Julius-eng/project-quiver-05032025/flight-test/README.md

# Flight Test Archive

This folder is no longer in active use. It serves as a historical record of early flight tests conducted during the initial development and validation phases of the project.

Current and future flight tests will be logged and tracked on our [flight tracking platform](https://project-flight-tracking.vercel.app/).

## Contents

- **PT1/** - Prototype 1 flight test logs and documentation
- **PT2/** - Prototype 2 flight test logs and documentation
- **PT3/** - Prototype 3 flight test documentation
- **PT3-TX/** - Prototype 3 flight test documentation in Texas
- **20hr-flight-plan.md** - Original 20-hour flight plan
- **performance-metrics-flight-plan.md** - Performance metrics flight plan
