Julius-eng/project-quiver-05032025/task-grant-bounty/pt3/electronics/0002-Battery-PCB/information-note.md

# PT 3 Battery PCB

# Status

`Valid`

`Revision History: V1`

`Replacement Log: None`

`Reference: PT3 PCB Spec information note`

# Project Description
## PCB Overview

The Battery PCB is one of four custom PCBs being designed for PT3. This PCB is responsible for safely controlling, protecting, and monitoring the primary power output from the Tattu Smart Battery to the Main PCB. These functions are implemented using onboard voltage regulators, MOSFETs, SSRs, resistors, TVS diodes, fuses, LEDs, temperature sensors, and flight controller (FC) control signals. The PCB transmits battery telemetry via CAN, temperature data via I²C, and notifies users of power status through integrated LEDs. Further details are available in the schematic and component datasheets. 

# Methodology
Reviewed and studied the PT3 Battery PCB design files from Julius. Discussed and developed understanding over various direct messages and calls. 
Designed was based on the information provided in the [PT3 PCB Spec information note](https://github.com/Arrow-air/project-quiver/blob/main/task-grant-bounty/pt3/electronics/0001-PCB-Spec/information-note.md).

# Results and Deliverables

## Schematics and CAD files


<sub>***PCB Schematic***</sub>


<sub>***PCB All layers***</sub>


<sub>***PCB Traces***</sub>


<sub>***PCB Ground Plane***</sub>


<sub>***PCB Front***</sub>


<sub>***PCB Back***</sub>


<sub>***PCB CAD front***</sub>


<sub>***PCB CAD back***</sub>

### PCB Build Specifications

- Base material: FR-4
- Dimensions: 172.2 x 101.8 mm
- Layers: 4
- PCB thickness: 1.6 mm
- PCB Color: Blue
- Silkscreen: White
- Material Type: FR-4 TG155
- Via Covering: Plugged
- Min via hole size/diameter: 0.3mm/(0.4/0.45mm)
- Surface finish: ENIG
- Gold Thickness: 2U”
- Outer/Inner Copper Weight: 2 oz each
- Board Outline Tolerance: ±0.2mm(Regular)

## Layout Description

**J1 – Push-button Connector**

- Pre-charge activation push button with integrated LED
    - LED indication powered by internal power supply (PS1)

**J2 – 5-pin Eurostyle Connector**

- FC_2: Pre-charge termination signal from flight controller (FC)
- I²C SDA & SCL: Temperature sensor data communication
- CAN H & L: Battery telemetry signals

**J3 – 4 pin Eurostyle Connector**

- SSR_S: Enable signal for Solid State Relay (SSR) U3
- 12V and 5V inputs from the Main PCB
- Ground

**J5 – CAN Jumper**

- Optional jumper for enabling battery telemetry via CAN

**J6 – Pre-charge Behavior Control Jumper**

- Optional jumper enabling specific control of the pre-charge circuit

**J7 & J8 – Fuse Connectors**

- Press-fit pins designed for a 200A fuse
- Pre-charge bypass: A 16 AWG cable with a ring terminal connects directly to J49 on the Main PCB, activated via push button (J1)

**J9 & J10 - Main Battery Connector**

- Custom Molex connectors:
    - Contact pins: 2x of Molex EXTreme 46437-9206
    - Guide pin: 1x  Molex 464379-301
            
       <sub>***Custom Molex Connector***</sub>

- J9
    - P1-P5: Main negative outputs (fused at J7 & J8)
        - Ground reference for the circuit with exception of 12V and 5V coming from the Main PCB via J3
    - P6: CAN_L
- J10
    - P2 - P6: Main positive output
    - P1: CAN_H

**J11 – Main Output Connector**

- AMASS power connector using 6 or 8 AWG cable

**IC1 & IC2 - Temperature sensors** 

- Powered by regulated 3.3V (PS2)
- Positioned on PCB's top layer, measuring temperature of pre-charge resistors and SSR MOSFETs located on the bottom layer
- Address determined by soldering 1 of the jumper pads circled in red
    - IC1: +3V3 (JP3)
    - IC2: GND (JP6)
        
        

**Q2 - Q7 Main MOSFETs**

- Source connected to fused negative terminal (BAT-)
- Gate voltage provided by SSR (U3) via regulator (U2), controlled by FC
- Protection circuitry:
    - 10Ω gate resistor
    - 220kΩ gate-to-ground resistor
    - TVS diode gate-to-ground
- Similar operation and protections apply to pre-charge MOSFET (Q1)
- Test points
    - TP1 - voltage divider for PS1 remote operation
        - Powered off reading: ~10-15V
        - Powered on reading: Battery voltage
    - TP2 - 5V input to PS2 (Temperature sensor voltage regulator)
    - TP3 - 3.3V PS2 output
    - TP4 - Gate voltage for Q1 MOSFET (pre-charge )
        - 12V after push button pressed
    - TP5 - Gate voltage for MOSFETs Q2-Q7
        - 12V after SSR_S triggered
    - TP6 - Battery voltage out of SSR U3
        - Battery voltage after SSR_S triggered

**The remainder of the circuit will be explained in the Circuit Operation section**

## Circuit Operation

- Battery is plugged in
    - PS1 is energized but is not outputting 12V without pushbutton (J1) activation
    - Main output (J11)
        - + terminal is live
        - - terminal is open circuit with MOSFETS Q1 - Q7
    - Depending on J5 jumper placement, Battery telemetry will be on CAN bus
- User presses push button (J1)
    - LED on pushbutton will light up
    - 12V output from PS1 to Q1 MOSFET gate
    - Pre-charge will begin allowing current to pass through 200A fuse (J7 & J8), automotive fuse (U1), MOSFET (Q1), NC SSR (K1), pre-charge resistors (R15 - R17), and then the main negative output
    - This will allow limited power output from the Battery PCB to the Main PCB
        - pre-charge ESC capacitors
        - Power on Main PCB 12V and 5V regulators
        - Power to FC and aux components
    - This will also bring in 5V and 12V from the Main PCB
        - 5V will power the 3.3V regulator (PS2)
            - temperature sensors will be powered on(3.3V) and transmit data over I<sup>2</sup>C back to Main PCB
    - After pre-charge is complete the following LEDs will be visible on the Battery PCB exterior
        - LED5 - 3.3V (from internal voltage regulator)
        - LED6 - 5V (coming from Main PCB, J3)
        - LED6 - 12V (coming from Main PCB, J3)
    - Pre-charge bypass wire will be live but is an open circuit on the Main PCB until SSR U3 (Main PCB) is closed. 
- User completes pre-arm checklist
- Users sends signal to fully activate main power out from FC (SSR_S, J3) and end pre-charge signal (FC_2, J2) (Depending on JP9 and JP10 selection)
    - Two things can happen here depending on J6 jumper placement
        - With jumper
            - SSR_S or FC_2 will open the NC SSR (K1) effectively terminating the pre-charge
            - Simultaneously, SSR_S will trigger the NO SSR (U3) allowing another 12V regulator (U2) to be powered on
                - this will apply 12V to the gate of the MOSFETs (Q2 - Q7)
                - current will pass through the MOSFETs to main negative output (J3)
            - circuit will have full power output capabilities
        - without jumper
            - pre-charge will remain on
            - FC_2 will be an open circuit
            - SSR_S will trigger the NO SSR (U3) allowing another 12V regulator (U2) to be powered on
                - this will apply 12V to the gate of the MOSFETs (Q2 - Q7)
                - current will pass through the MOSFETs to main negative output (J3)
            - circuit will have full power output capabilities
    - LED5 - SSR Signal will be visible on the Battery PCB exterior
 
# Remarks
- Design work was conducted by Julius.
- Schematic and CAD files can be find in the Quiver PT3 task and bounties directory
- information note prepared by Erick.
- Manufacturing instructions can be found in the assembly guide.
