Julius-eng/project-quiver-05032025/task-grant-bounty/pt1/electronics/0002-PT1.5_Harnessing_Update/information-note.md

# PT 1.5 Harnessing Update

# Status

`Valid`

`Revision History: None`

`Replacement Log: None`

`Reference: None`

# Project Description

This information note covers the harnessing updates for PT1 due to the implementation of a new PCB. These updates were required because various components, connectors, and enclosures were changed. 

# Methodology

The main considerations for the design are:

- Updated layout and components used in the new PCB
- Components removed
- Redesigned enclosure
- Compatibility with the existing systems

# Results and Deliverables

### Overview of Changes

The following components were removed from the PT1 design:

- Feather PT3 Testbed PDB
- Contactor
- XT-60 Splitter
- Custom designed enclosure
- Pixhawk PM02D Voltage regulator
- KDE UBEC

The following components were added to the design:

- “PT2 PCB”
    - See [information note](https://github.com/Arrow-air/project-quiver/blob/main/task-grant-bounty/pt1/electronics/0001-PDB_V1/information-note.md) for detailed review.
    - Handles all voltage regulation and power distribution
    - Introduces various plug size Molex Eurostyle Terminal blocks
    - Added physical switch for pre-charge control
    - XT60PW-M for ESC Output
- Solid State Relay (SSR)
- Updated PCB enclosure merged with the attachment interface

The following connectors are being reused:

- compression lugs
- XT30PW-F

An updated To/From table was prepared for all connections in a [CSV format](https://docs.google.com/spreadsheets/d/16EMP2wPfAB1RD0uh3B_RAArtTbWv5ikxNuRASy50kpA/edit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). Refer to this table to get specifics on pins and what connectors are used. This will eventually be used to create a detailed routing CAD diagram. 

### Cables Created

J1 → SIYI

- SIYI cable plugs into J1

J2 → SSR LED

J3 → SSR Control Pins

- 4 position Eurostyle plug to header pins
- 28 AWG

J4 & J5 → Various FC ports

- 6 and 10 position Eurostyle plug to JST connectors on Pixhawk
- 28 AWG
- 75 cm
- Note: J5 pins 8 and 9 will go to flight controller AD&IO port

J6 → Payload (Attachment interface)

- 7 position Eurostyle plug to 8 position Molex

J7 → Battery Interface

- 2 position Eurostyle plug with bare leads
    - solder into slots on battery interface

J8 → Radar Altimeter

- 4 Position Eurostyle plug directly from radar altimeter

J9 → Battery (-)

- 2 position Eurostyle plug
- Pin 1 connects to negative terminal of battery interface with ring terminal

SSR + → J10

- 6 AWG Silicon cable with compression lug

J11 → Precharge Switch 

- 2 position Eurostyle connecting to toggle switch

SSR - → J12

- 6 AWG Silicon cable with compression lug

XT60PW-F are used for power delivery to the ESCs and 5 Position Eurostyle plugs are used for the CAN and PWM connections. 

### Updated Enclosure

The pictures below give a brief description of the internal connections for the updated enclosure. Please see the PT 1.5 cockpit information note for additional details. 





# Remarks

- Cable lengths and colors have not been recorded. This note will be updated when the information is available
- Suggestions received so far for changes to harnessing:
    - shielded, threaded, barrel connectors
    - 3rd party manufactured harnessing
- There is a lot of cabling in this update that could be reduce with a different harnessing approach.
    - We can attempt a single connector for PT3 and have a harness with nodes that branch off to different areas of the drone.
    - This will increase the complexity of the harnessing and would require more information of cable lengths and where to place components.
- Below is a rough drawing of the harnessing for PT 1.5
    - The drawing is incomplete because there was too many harnesses to fit in one screen.
