Julius-eng/project-quiver-05032025/docs/Engineering-Reports/PT3/images/battwall.png

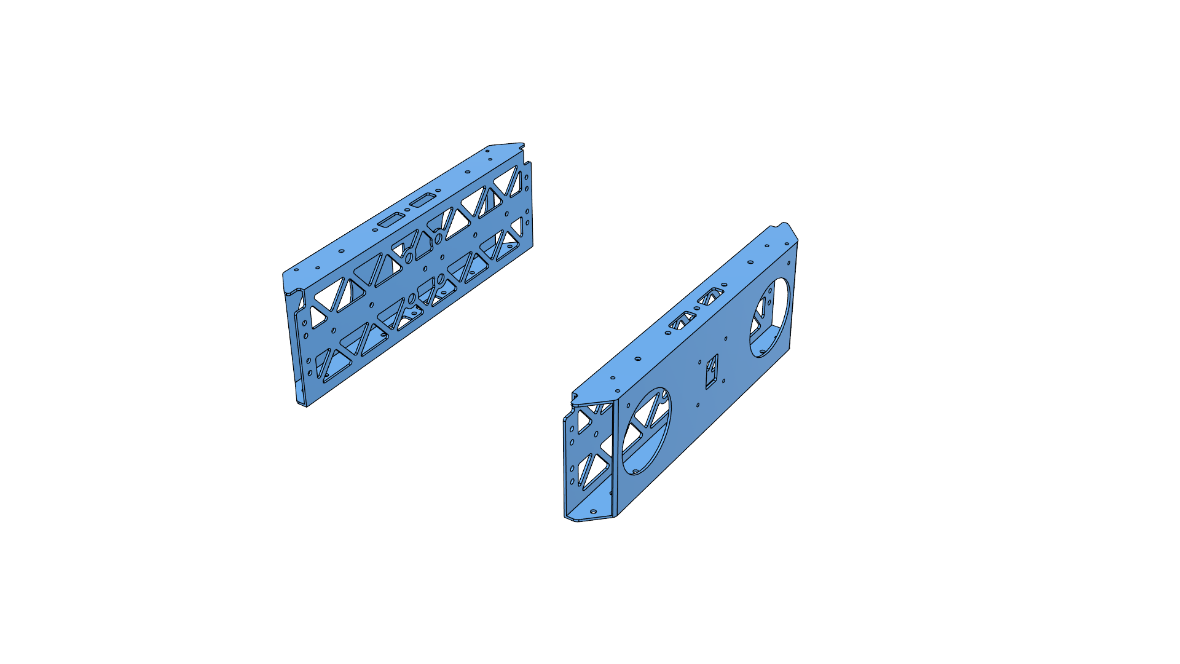
docs/Engineering-Reports/PT3/images/battwall.png
