Julius-eng/project-quiver-05032025/docs/Engineering-Reports/PT3/images/GNSS-explode.png

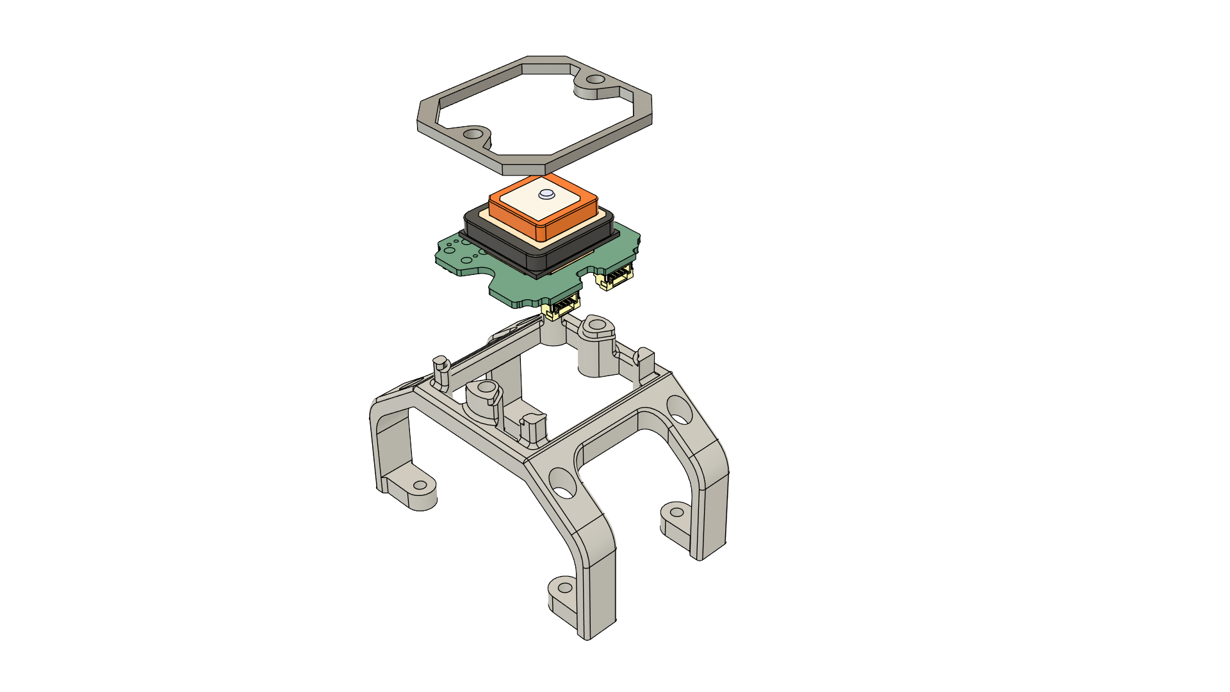
docs/Engineering-Reports/PT3/images/GNSS-explode.png
