Julius-eng/project-quiver-05032025/docs/Engineering-Reports/PT3/images/PCB3D.png

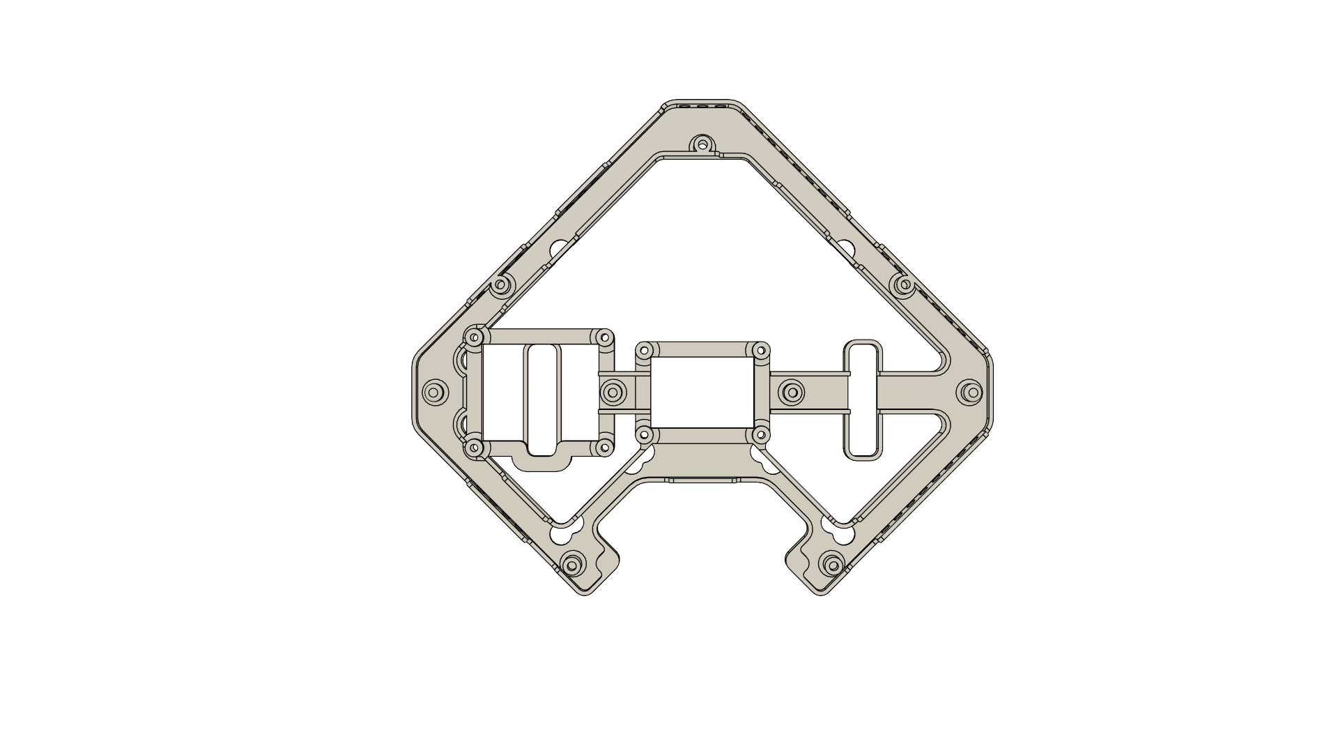
docs/Engineering-Reports/PT3/images/PCB3D.png
