Julius-eng/project-quiver-05032025/docs/Engineering-Reports/PT3/images/platescut.png

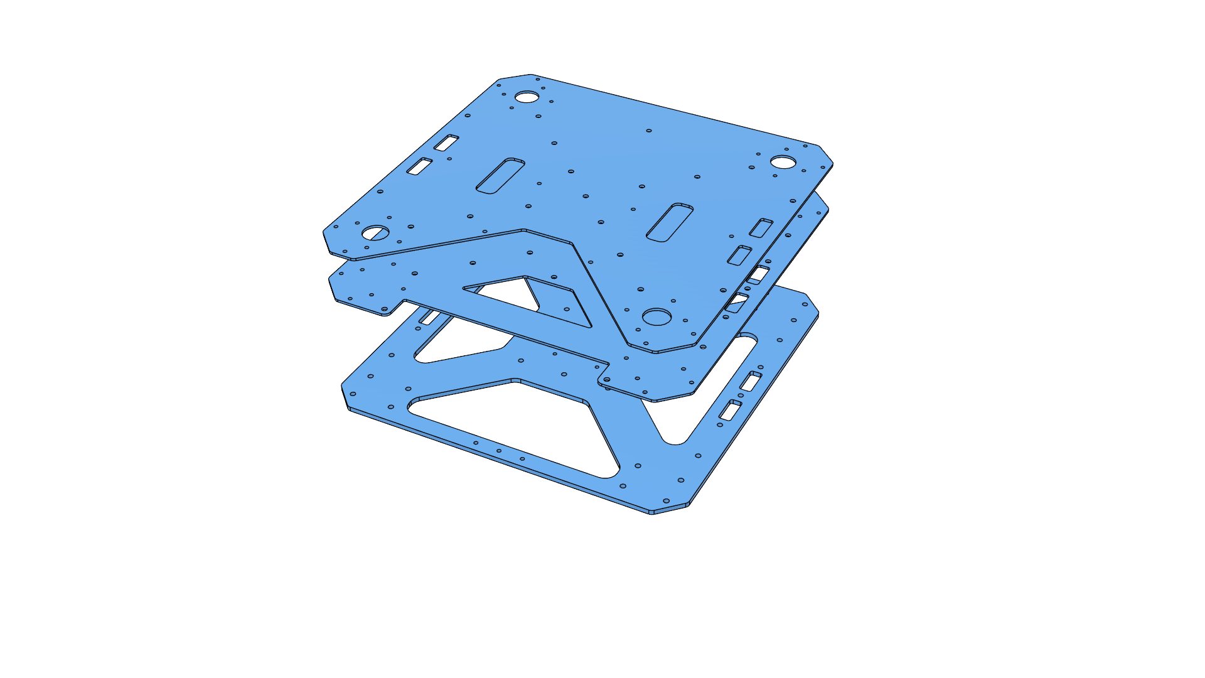
docs/Engineering-Reports/PT3/images/platescut.png
