Julius-eng/project-quiver-05032025/docs/Engineering-Reports/PT3/images/side_att_explode.png

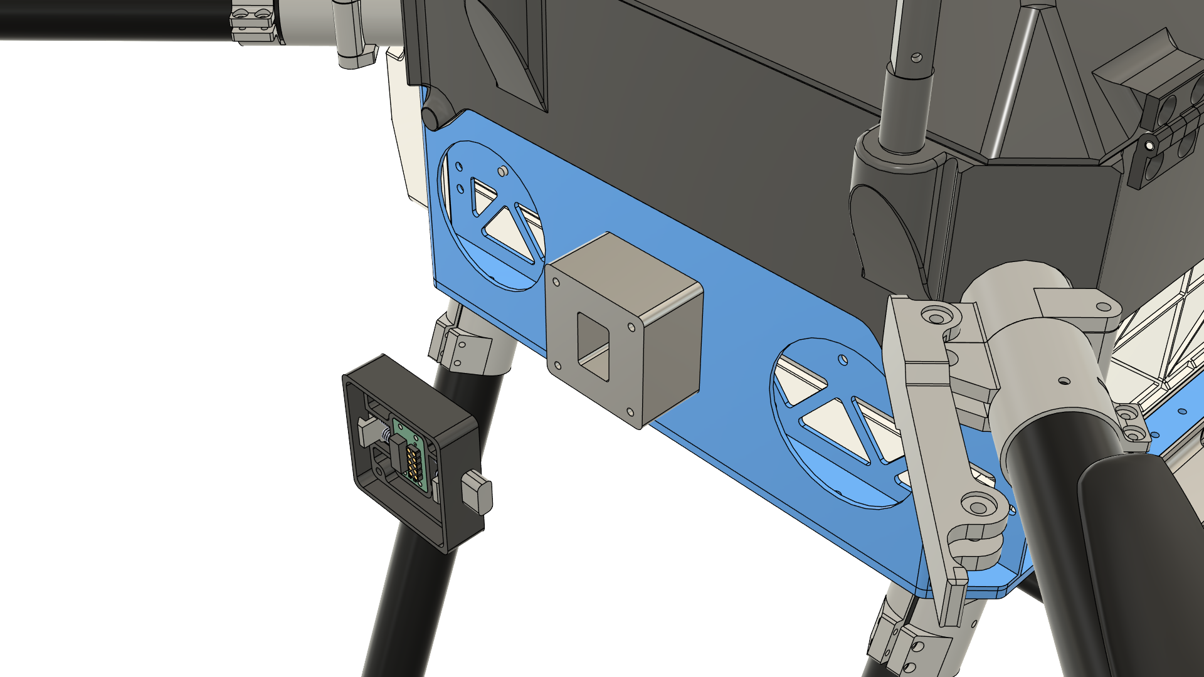
docs/Engineering-Reports/PT3/images/side_att_explode.png
