Julius-eng/project-quiver-05032025/task-grant-bounty/pt1/electronics/0001-PDB_V1/project-data/Pictures/Quiver_PDB_Bottom.png

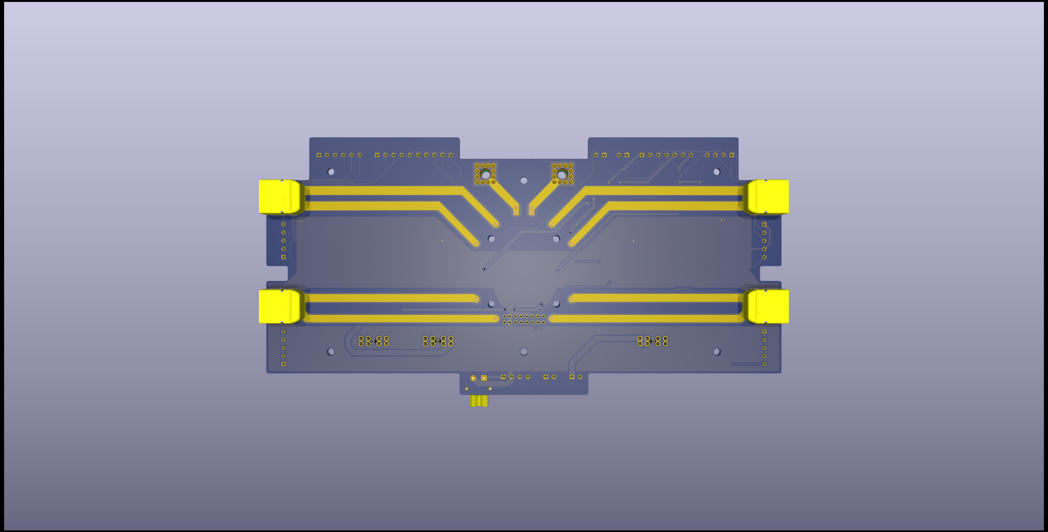
task-grant-bounty/pt1/electronics/0001-PDB_V1/project-data/Pictures/Quiver_PDB_Bottom.png
