Julius-eng/project-quiver-05032025/task-grant-bounty/pt1/electronics/0002-PT1.5_Harnessing_Update/picture/1.5 info note- 1.png

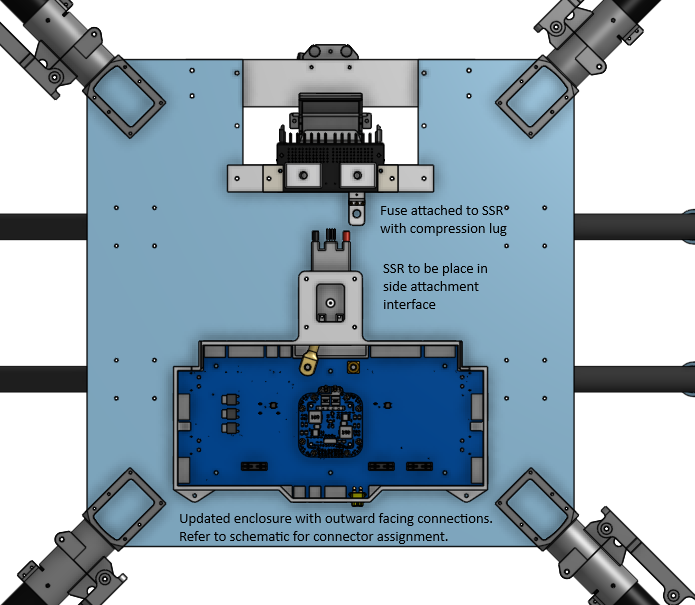
task-grant-bounty/pt1/electronics/0002-PT1.5_Harnessing_Update/picture/1.5 info note- 1.png
