Julius-eng/project-quiver-05032025/task-grant-bounty/pt1/electronics/0002-PT1.5_Harnessing_Update/picture/Screenshot 2025-05-01 110826.png

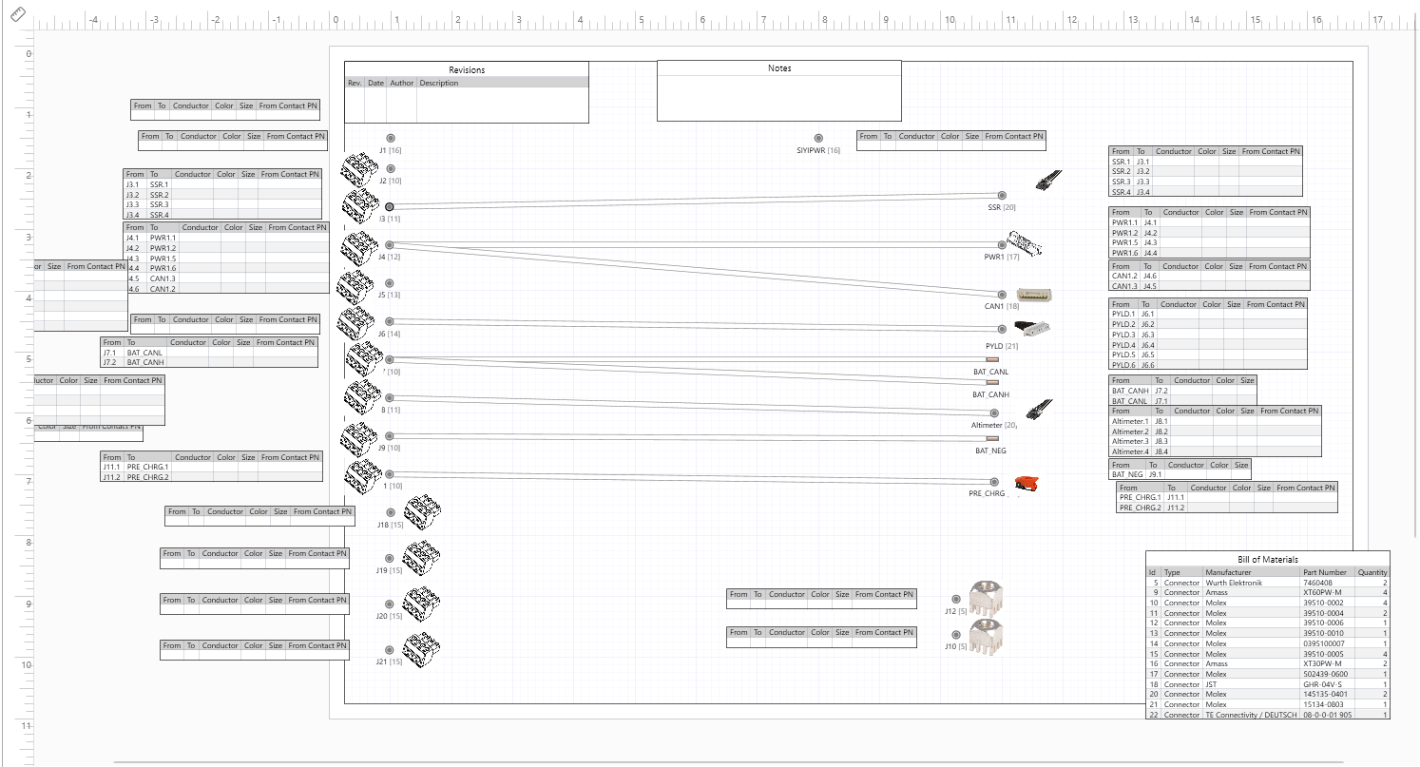
task-grant-bounty/pt1/electronics/0002-PT1.5_Harnessing_Update/picture/Screenshot 2025-05-01 110826.png
