Julius-eng/project-quiver-05032025/task-grant-bounty/pt1/structural/0001-battery_enclosure_improvement/picture/explode_view.jpg

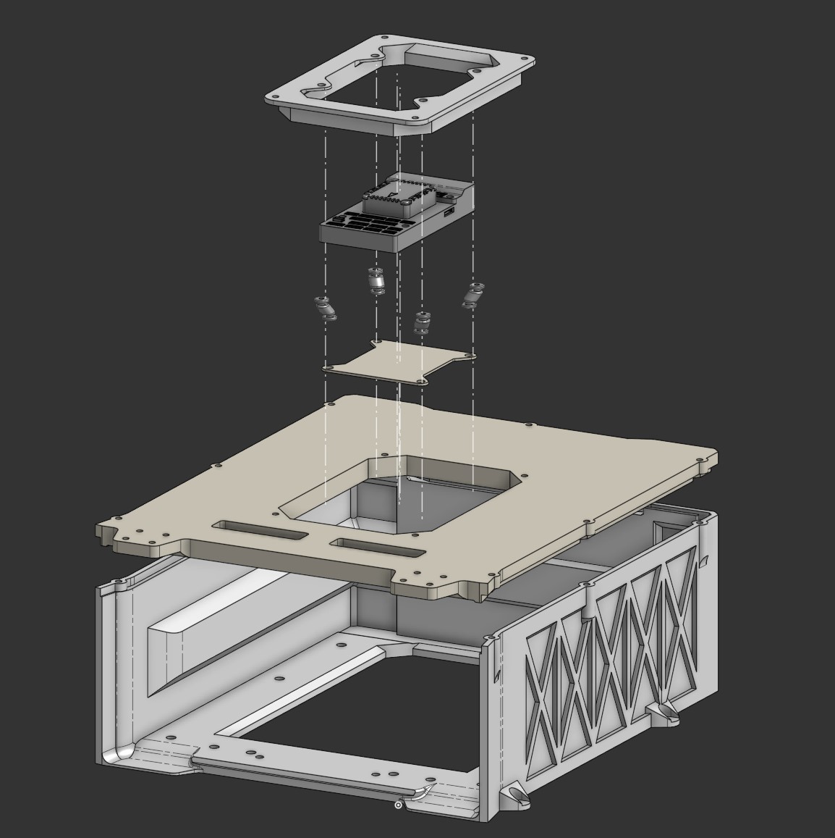
task-grant-bounty/pt1/structural/0001-battery_enclosure_improvement/picture/explode_view.jpg
