Julius-eng/project-quiver-05032025/task-grant-bounty/pt2/project-quiver-pt2-complete-grant/additional-data/pt2-design-improvements-introduction-pictures/Design_Improvments_3.png

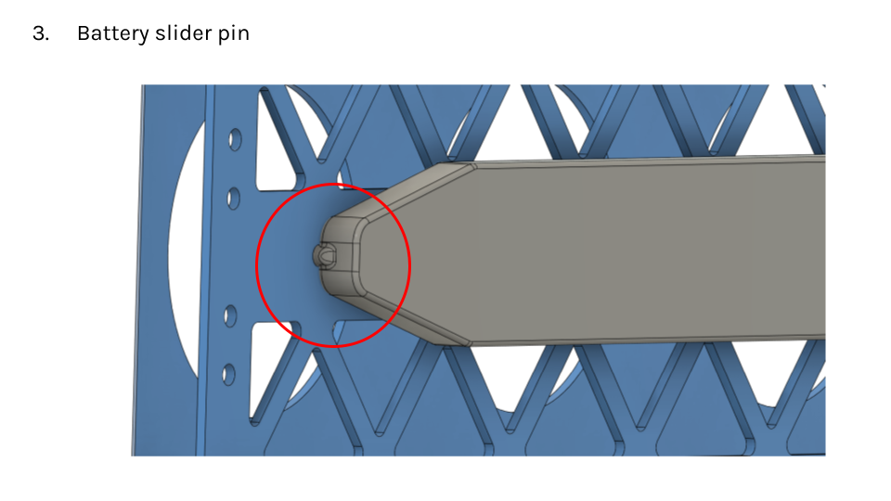
task-grant-bounty/pt2/project-quiver-pt2-complete-grant/additional-data/pt2-design-improvements-introduction-pictures/Design_Improvments_3.png
