Julius-eng/project-quiver-05032025/task-grant-bounty/pt2/project-quiver-pt2-complete-grant/additional-data/pt2-main-pcb-files/quiver-pt2-main-pcb-overview.png

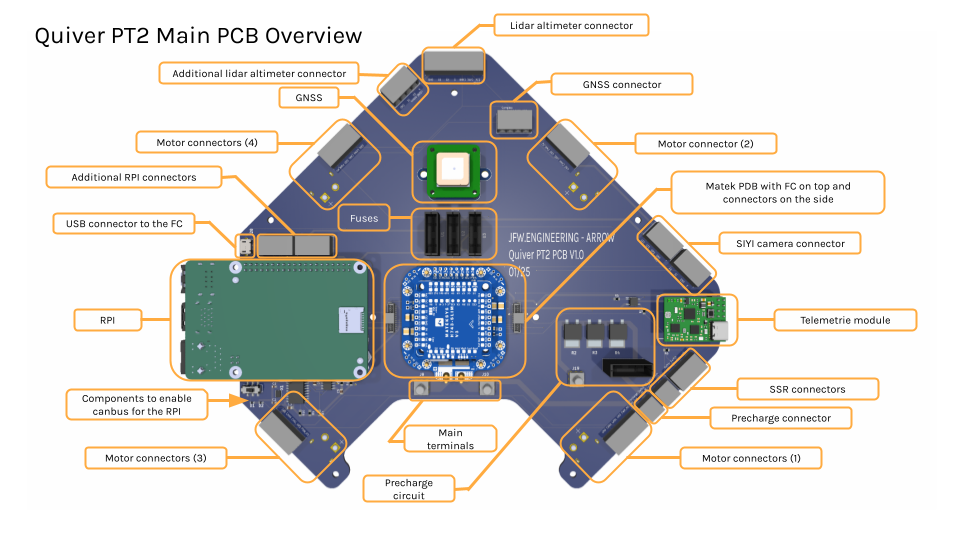
task-grant-bounty/pt2/project-quiver-pt2-complete-grant/additional-data/pt2-main-pcb-files/quiver-pt2-main-pcb-overview.png
