Julius-eng/project-quiver-05032025/task-grant-bounty/pt2/project-quiver-pt2-complete-grant/engineering-report/pictures/Image_4.png

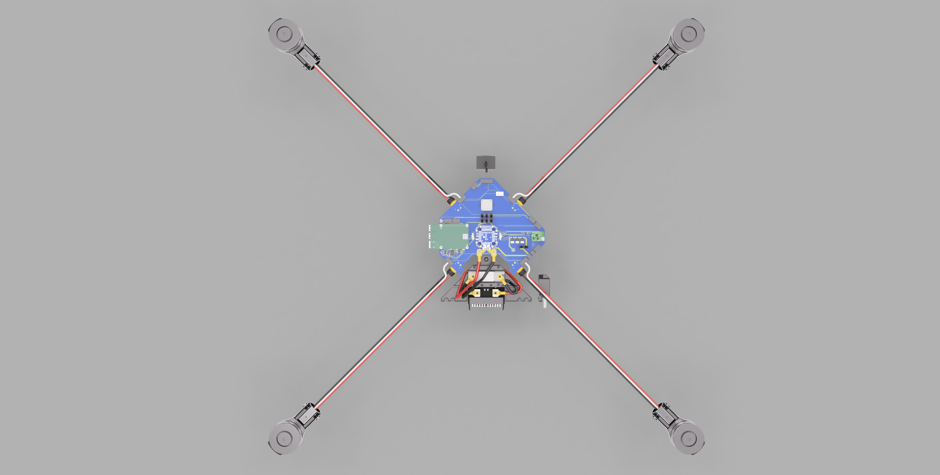
task-grant-bounty/pt2/project-quiver-pt2-complete-grant/engineering-report/pictures/Image_4.png
