Julius-eng/project-quiver-05032025/task-grant-bounty/pt3/electronics/0001-PCB-Spec/picture/carrier-1.png

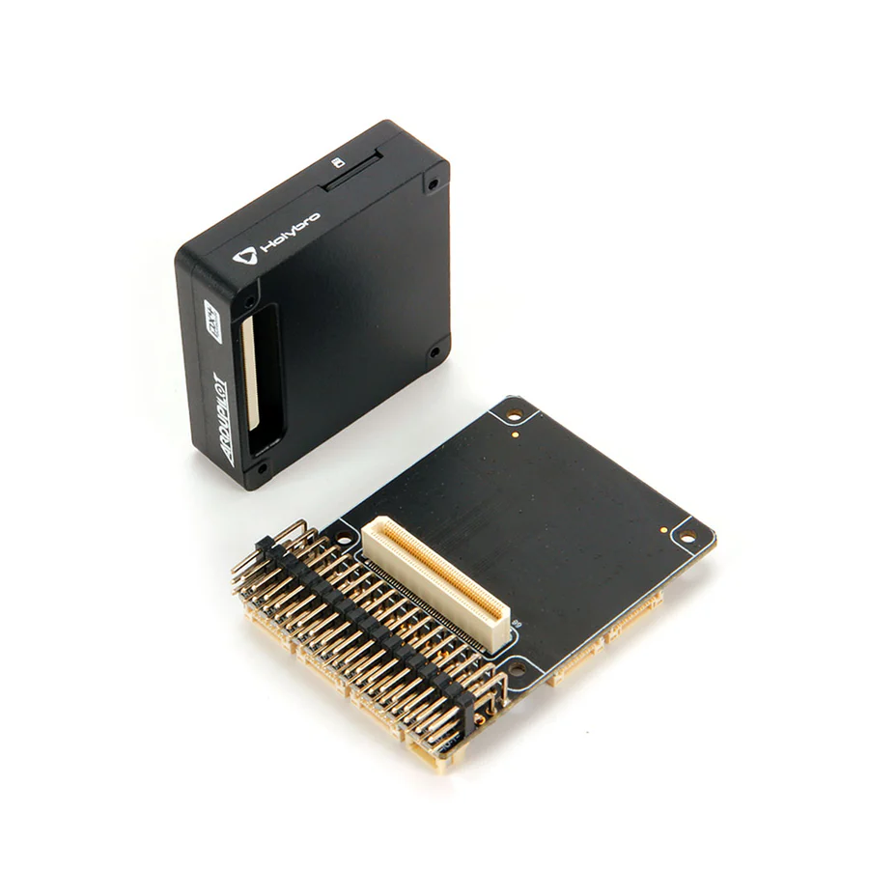
task-grant-bounty/pt3/electronics/0001-PCB-Spec/picture/carrier-1.png
