Julius-eng/project-quiver-05032025/task-grant-bounty/pt3/electronics/0001-PCB-Spec/picture/PCB-seg.png

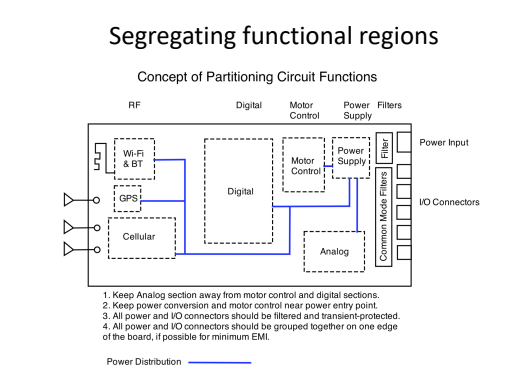
task-grant-bounty/pt3/electronics/0001-PCB-Spec/picture/PCB-seg.png
