Julius-eng/project-quiver-05032025/task-grant-bounty/pt3/electronics/0007-Main-PCB/Updates/assets/NEW2.png

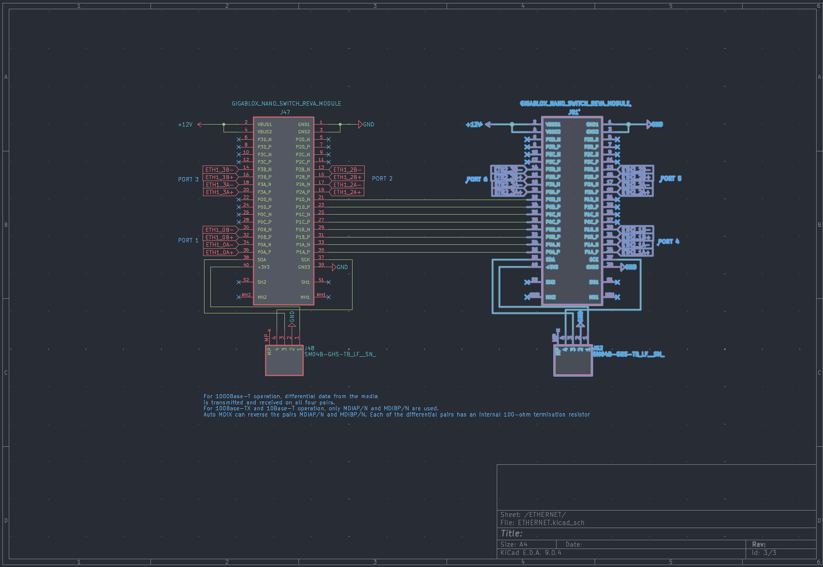
task-grant-bounty/pt3/electronics/0007-Main-PCB/Updates/assets/NEW2.png
