Julius-eng/project-quiver-05032025/task-grant-bounty/pt3/electronics/0008-FC-PCB/assets/editor - bottom.png

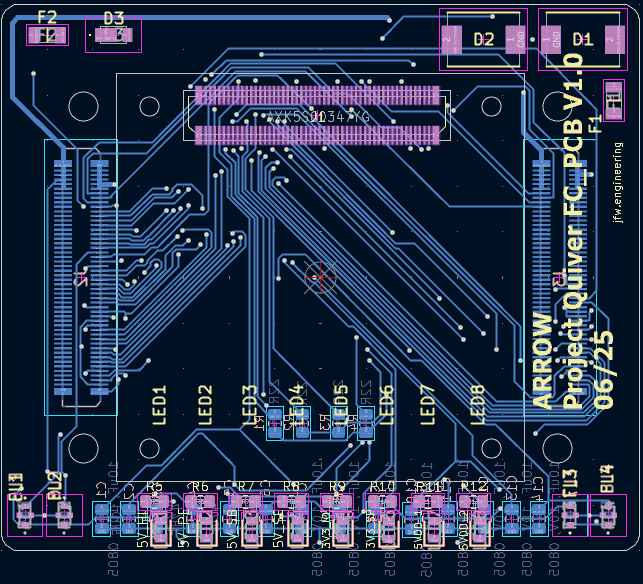
task-grant-bounty/pt3/electronics/0008-FC-PCB/assets/editor - bottom.png
