Julius-eng/project-quiver-05032025/task-grant-bounty/pt3/electronics/0008-FC-PCB/KiCAD-Files/Quiver_PT3_FC_PCB_1.png

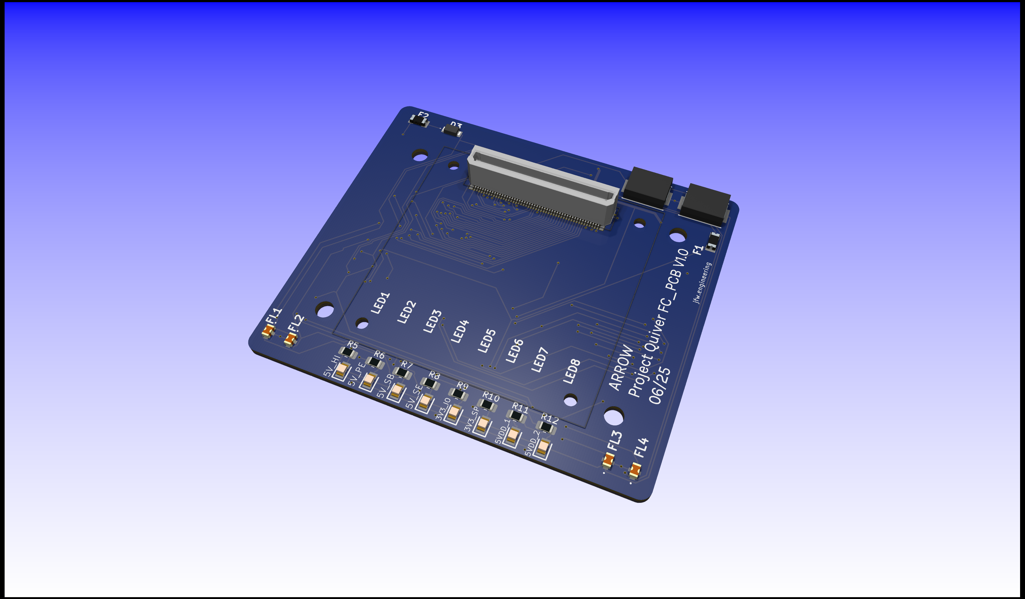
task-grant-bounty/pt3/electronics/0008-FC-PCB/KiCAD-Files/Quiver_PT3_FC_PCB_1.png
