Julius-eng/project-quiver-05032025/task-grant-bounty/pt3/electronics/0008-FC-PCB/Updates/assets/PCB5.png

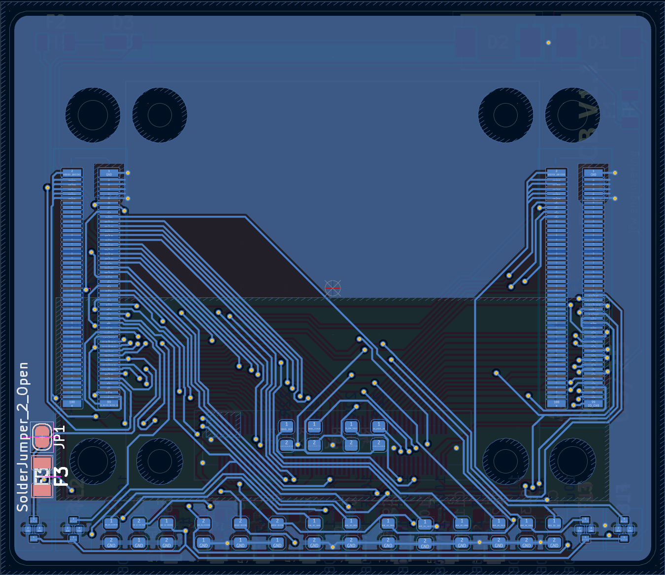
task-grant-bounty/pt3/electronics/0008-FC-PCB/Updates/assets/PCB5.png
