Julius-eng/project-quiver-05032025/task-grant-bounty/pt3/structural/0001-comprehensive_airframe_modification/image/altimeter_mount.jpg

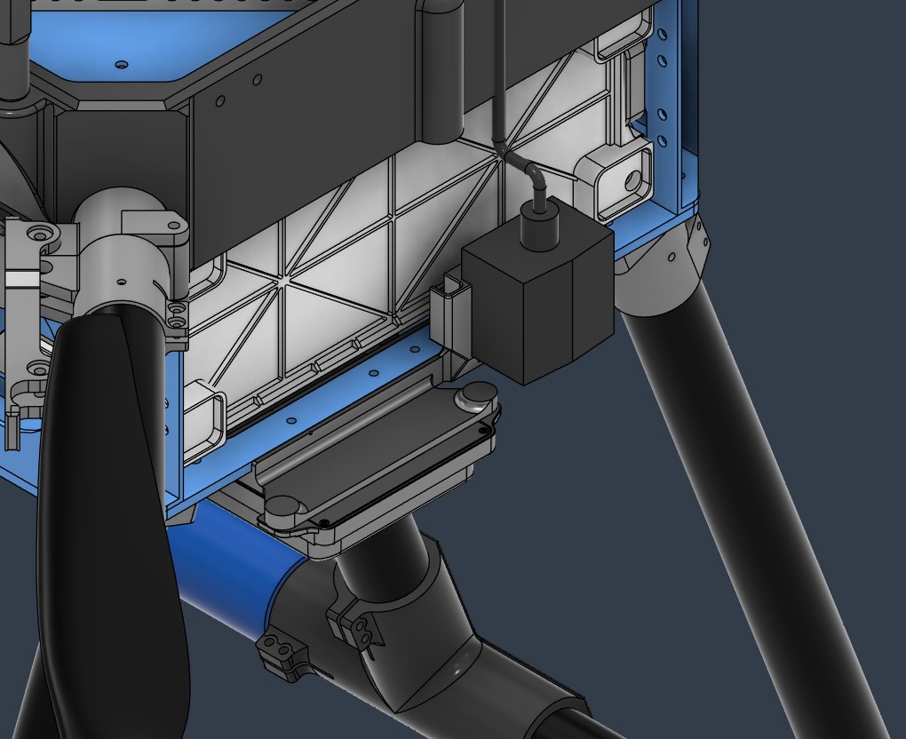
task-grant-bounty/pt3/structural/0001-comprehensive_airframe_modification/image/altimeter_mount.jpg
