Julius-eng/project-quiver-05032025/task-grant-bounty/pt3/structural/0001-comprehensive_airframe_modification/image/gnss_stand.jpg

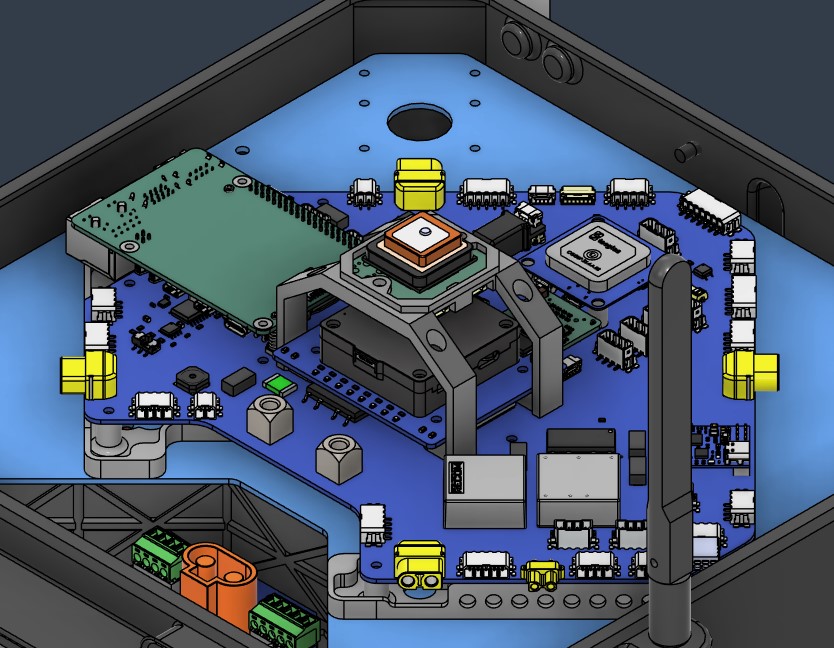
task-grant-bounty/pt3/structural/0001-comprehensive_airframe_modification/image/gnss_stand.jpg
