Julius-eng/project-quiver-05032025/task-grant-bounty/pt3/structural/0003-enclosure_latch_and_sensor_mount_modification/image/sensor_mount_new_2.jpg

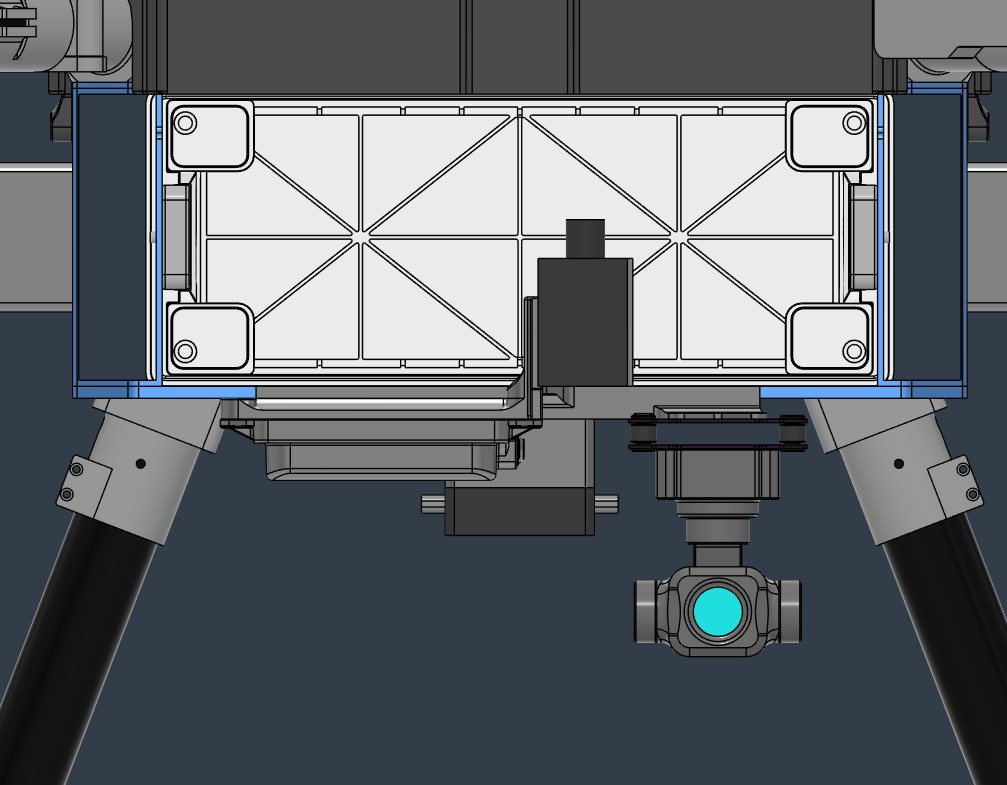
task-grant-bounty/pt3/structural/0003-enclosure_latch_and_sensor_mount_modification/image/sensor_mount_new_2.jpg
