Julius-eng/project-quiver-05032025/task-grant-bounty/pt3/electronics/0003-Attachment-Interface-PCB/BOM/QuiverAttachPCB_BOM.csv

QuiverAttachPCB
Id | Designator | Footprint | Quantity | Designation | Supplier | MPN | Product URL
1 | J2 | 8132201030000101 | 1 | 813-22-010-30-000101 | Mill-Max | 813-22-010-30-000101 | https://www.mouser.com/ProductDetail/Mill-Max/813-22-010-30-000101?qs=iJx90KzHWBpyidWenribEg%3D%3D
2 | J1 | CONN12_2077601281_MOL | 1 | 2077601281 | Molex | 2077601281 | https://www.mouser.com/ProductDetail/Molex/207760-1281?qs=GedFDFLaBXEeqt2cXDe9Ig%3D%3D
3 | J3 | 419-10-210-30-054000 | 1 | 419-10-210-30-054000 | Mill-Max | 419-10-210-30-054000 | https://www.mouser.com/ProductDetail/Mill-Max/419-10-210-30-054000?qs=rcV84j27mGu7FxS0X2jhEg%3D%3D
 | Not Populated | 204523-1201 | 1 | 204523-1201 | Molex | 204523-1201 | https://www.mouser.com/ProductDetail/Molex/204523-1201?qs=GedFDFLaBXE6kZVpi1x6pg%3D%3D
