Julius-eng/project-quiver-05032025/task-grant-bounty/pt1/flight-test/0001-list-of-issues/Flight Log Review.xlsx

Table 1
Log Name | Date | Flight Summary | Flight Modes | Flight Duration | Vibration Levels | GPS | EKF | Power | Flight Performance | Motor Outputs | Error Messages | Comments
00000095.BIN | 2025-03-20 | On-Ground | STAB | 1:00:00 | OK | OK | OK | OK | - | Random zeros? | -
00000096.BIN | 2025-03-20 | Hover, stabilization | STAB, ALT, POS | 1:35:00 | OK | OK | 2 Yaw Reset | OK | Good | Good, 2-4 giving more | - | Pitch and roll performance great
00000097.BIN | 2025-03-20 | Hover, small inputs | STAB, POS | 3:20:00 | OK | OK | 2 Yaw Reset | OK | Good | Good, too much change during yaw inputs | - | Yaw input response should be studied
00000098.BIN | 2025-03-20 | On-Ground | STAB | 0:15:00 | Higher but safe | OK | OK | OK | - | Hitting limits on ground | - | ?
00000099.BIN | 2025-03-20 | Horizontal Movements | STAB, POS | 3:00:00 | OK | OK | 2 Yaw Reset | OK | Good, POS needs tuning | Good, too much change during yaw inputs | -
00000100.BIN | 2025-03-21 | On-Ground | STAB | 0:30:00 | OK | OK | OK | OK | - | Good | -
00000101.BIN | 2025-03-21 | On-Ground | STAB | 0:40:00 | OK | OK | OK | ESC0 slightly less | - | Good, 1-2 giving more | -
00000102.BIN | 2025-03-21 | Takeoff, Landing | STAB, POS | 1:25:00 | OK | OK | 2 Yaw Reset | ESC0 slightly less | Ground oscillations at the end | 1-2 giving way more on ground (around 28:30) | - | Check yaw at the beginning
00000103.BIN | 2025-03-21 | On-Ground, No input | GUIDED | 2:00:00 | OK | OK | OK | Contactor Open | - | - | - | Tried activating guided mode
00000104.BIN | 2025-03-21 | On-Ground, No input | POS | 0:15:00 | OK | OK | OK | Contactor Open | - | - | - | RC calibration?
00000105.BIN | 2025-03-22 | On-Ground, No input | POS | 0:15:00 | OK | inside the workshop? | OK | Contactor Open | - | - | -
00000106.BIN | 2025-03-22 | On-Ground | STAB | 1:00:00 | OK | OK | OK | ESC0 slightly less | Ground oscillations - no takeoff | Too much oscillation on ground | -
00000107.BIN | 2025-03-22 | Takeoff, few maneuvers, Landing | STAB, POS | 0:55:00 | OK | OK | 2 Yaw Reset | ESC0 slightly less | A bit worse than others | 3-4 giving more | -
00000108.BIN | 2025-03-22 | Takeoff, small maneuvers | ALT, POS | 1:40:00 | OK | OK | 2 Yaw Reset | ESC0 slightly less | A bit oscillatory | Good | - | Altitude changes in POS even though no throttle given
00000109.BIN | 2025-03-22 | Lateral and longitudinal movements, step inputs, yaw inputs | ALT, POS | 3:10:00 | OK | OK | 2 Yaw Reset | ESC0 slightly less | Good, check POS | Good but check around 46:30 | -
00000110.BIN | 2025-03-22 | On-Ground | ALT, POS | 0:30:00 | OK | - | - | No data | - | No data | - | It says armed but no battery data? Contractor probably open, armed how?
00000111.BIN | 2025-03-22 | Altitude changes in POS mode | ALT, POS | 1:30:00 | OK | OK | 1 Yaw Reset | ESC0 slightly less | A bit oscillatory | Good but check around 09:36 | - | Route was like a big circle but very little pilot input. Check
00000112.BIN | 2025-03-22 | Takeoff, very small maneuvers, altitude change, land | ALT, POS | 1:20:00 | Slightly higher at landing but safe | OK | 2 Yaw Reset | OK, too much oscillation at landing | A bit oscillatory | Good | - | Too much vibration at landing
00000113.BIN | 2025-03-22 | Takeoff and landing in POS mode | POS | 0:50:00 | OK | OK | 2 Yaw Reset | ESC0 slightly less | Pitch twitches, roll better | Good | -
00000114.BIN | 2025-03-22 | Takeoff and landing in AUTO mode | POS, AUTO | 0:50:00 | OK | OK | 1 Yaw Reset | ESC0 slightly less | Worse than POS | Good but twitches at landing
00000115.BIN | 2025-03-22 | Takeoff and land in POS mode, roll step | POS | 0:45:00 | OK | OK | 1 Yaw Reset | ESC0 slightly less | Better but still needs tuning | Good
00000116.BIN | 2025-03-22 | Waypoint tracking with AUTO mode (line) | POS, AUTO | 1:15:00 | OK | OK | 1 Yaw Reset | ESC0 slightly less | Better than 114, still needs checking | Good but twitches at landing
00000117.BIN | 2025-03-22 | Waypoint tracking with AUTO mode (triangle) | POS, AUTO | 1:30:00 | OK | OK | 2 Yaw Reset | ESC0 slightly less | Similar to 116 | 1 giving less after some point, check attitudes
00000118.BIN | 2025-03-22 | On-Ground, No input | POS | 0:20:00 | OK | OK | - | ESC0 slightly less | - | -
00000119.BIN | 2025-03-22 | On-Ground, No input | POS | 0:30:00 | OK | OK | - | ESC0 slightly less | - | -
00000120.BIN | 2025-03-22 | 10 m altitude test in AUTO mode | POS, AUTO | 0:40:00 | OK | OK | 1 Yaw Reset | ESC0 slightly less | Twitches | 1-2 giving less but attitude is also positive |  | Possible wind, positive roll and pitch
00000121.BIN | 2025-03-22 | 10 m altitude test in AUTO mode | POS, AUTO | 0:30:00 | OK | OK | 2 Yaw Reset | ESC0 slightly less | Worse than 120 | 1-2 giving less, small yaw divergence. Landing twitchy |  | Possible wind, positive roll and pitch
00000122.BIN | 2025-03-22 | 10 m altitude test in AUTO mode | POS, AUTO | 0:30:00 | OK | OK | 2 Yaw Reset | ESC0 slightly less | Needs tuning | 1-2 giving less, small yaw divergence. Landing twitchy |  | Possible wind, positive roll and pitch
00000123.BIN | 2025-03-22 | 10 m altitude test in AUTO mode | POS, AUTO | 0:25:00 | OK | OK | 1 Yaw Reset | ESC0 slightly less | Worse in pitch and roll, faster in climb rate | 1-2 giving less, small yaw divergence. Landing twitchy |  | Possible wind, positive roll and pitch
00000124.BIN | 2025-03-22 | 10 m altitude test in AUTO mode, stays longer at 10 m | POS, AUTO | 0:35:00 | OK | OK | 1 Yaw Reset | ESC0 slightly less | Similar to 123 | 1-2 giving less, small yaw divergence. Landing twitchy |  | Possible wind, positive roll and pitch
00000125.BIN | 2025-03-22 | 10 m altitude test in AUTO mode | POS, AUTO | 0:30:00 | OK | OK | 1 Yaw Reset | ESC0 slightly less | Less twitchy but not following too well | 1-2 giving less, small yaw divergence. Landing twitchy
00000126.BIN | 2025-03-22 | 10 m altitude test in AUTO mode | POS, AUTO | 0:30:00 | OK, a bit higher than others | OK | 1 Yaw Reset | ESC0 slightly less | Still slow | 1-2 giving less, small yaw divergence. Landing twitchy
00000127.BIN | 2025-03-22 | Takeoff and reach 10m in AUTO, descend and land in POS mode | POS, AUTO | 1:00:00 | OK | OK | 1 Yaw Reset | ESC0 slightly less | Overshoots in AUTO, POS slightly better than AUTO | Good, landing less twitchy
00000128.BIN | 2025-03-22 | 10 m altitude test in AUTO mode | POS, AUTO | 0:30:00 | OK | OK | 1 Yaw Reset | ESC0 slightly less | Oscillatory behavior | Landing twitchy
00000129.BIN | 2025-03-22 | Waypoint tracking with AUTO mode (square). In the last leg, POS activated for return | POS, AUTO | 1:00:00 | OK | OK | 1 Yaw Reset | ESC0 slightly less | Angle tracking is the best in all AUTO flights. POS is also better. | Good, landing is great |  | Best test, check gains
00000130.BIN | 2025-03-22 | Waypoint tracking with AUTO mode (zigzag with elevation change) | AUTO | 2:00:00 | OK | OK | 1 Yaw Reset | ESC0 slightly less | Angle tracking is good, less altitude drop during decelaration. Landing is a bit fast. | Hit the limits yaw turns. Investigate.
