Julius-eng/project-quiver-05032025/docs/pt3-assembly-guides/structural-assembly/assets/models/part2.step

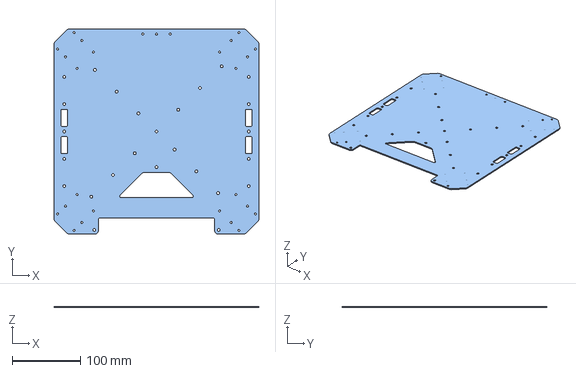
[picture p119: CAD file, 2025-07-04]
docs/pt3-assembly-guides/structural-assembly/assets/models/part2.step
300.0 x 300.0 x 2.00 mm
