Julius-eng/project-quiver-05032025/task-grant-bounty/pt3/electronics/0003-Attachment-Interface-PCB/QuiverAttachPCB_10pin/QuiverAttachPCB.step

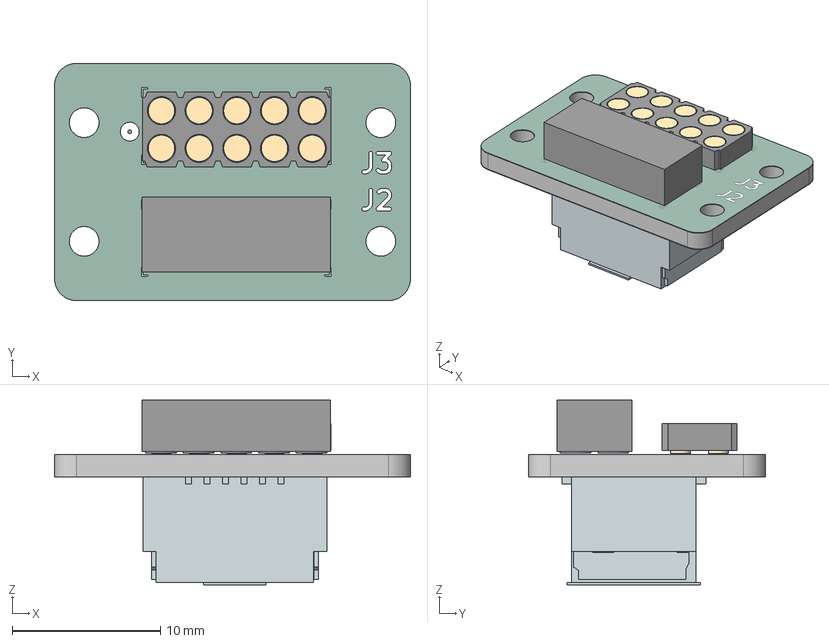
[picture p120: CAD file, 2025-06-26]
task-grant-bounty/pt3/electronics/0003-Attachment-Interface-PCB/QuiverAttachPCB_10pin/QuiverAttachPCB.step
24.0 x 16.0 x 12.5 mm
Pins
P4XX-28-011-00-000000_P410-28-011-00-000000
QuiverAttachPCB_silkscreen
QuiverAttachPCB_soldermask
QuiverAttachPCB_PCB
