Julius-eng/project-quiver-05032025/docs/pt3-assembly-guides/structural-assembly/assets/models/part4.step

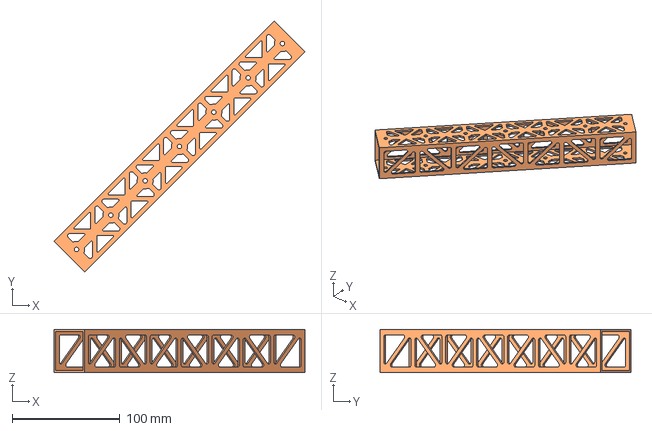
[picture p121: CAD file, 2025-07-04]
docs/pt3-assembly-guides/structural-assembly/assets/models/part4.step
232.8 x 232.8 x 40.0 mm
