Julius-eng/project-quiver-05032025/docs/pt3-assembly-guides/structural-assembly/assets/models/part7_8.step

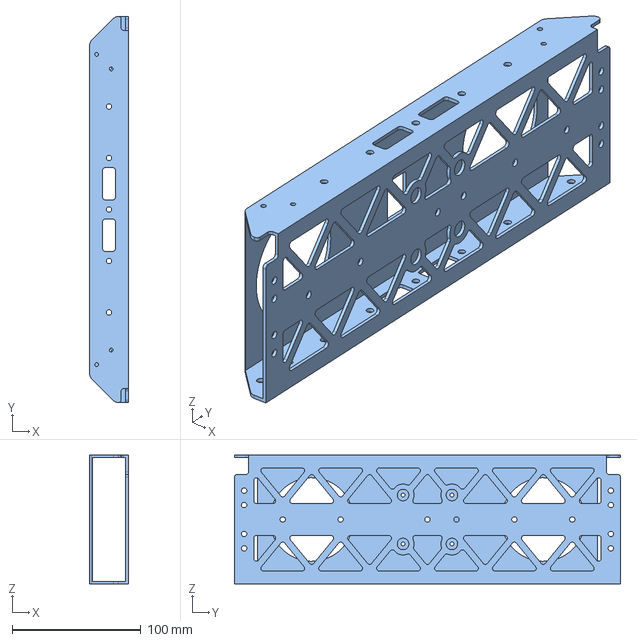
[picture p122: CAD file, 2025-07-04]
docs/pt3-assembly-guides/structural-assembly/assets/models/part7_8.step
30.0 x 300.0 x 100.0 mm
