Julius-eng/project-quiver-05032025/docs/pt3-assembly-guides/structural-assembly/assets/models/part3.step

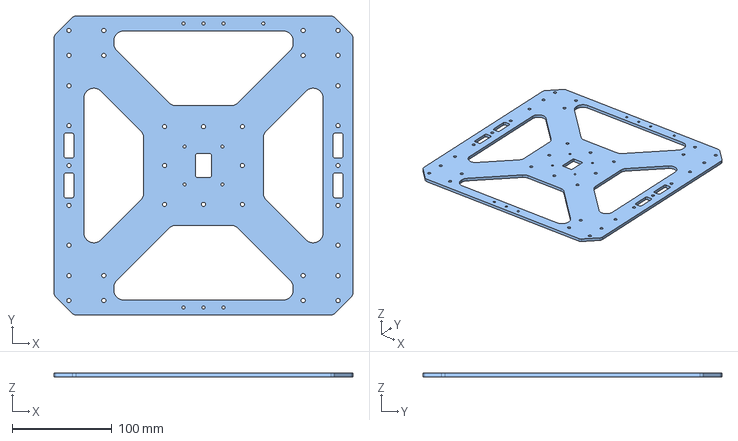
[picture p123: CAD file, 2025-07-04]
docs/pt3-assembly-guides/structural-assembly/assets/models/part3.step
300.0 x 300.0 x 4.00 mm
