Julius-eng/project-quiver-05032025/docs/pt3-assembly-guides/structural-assembly/assets/models/part5_6.step

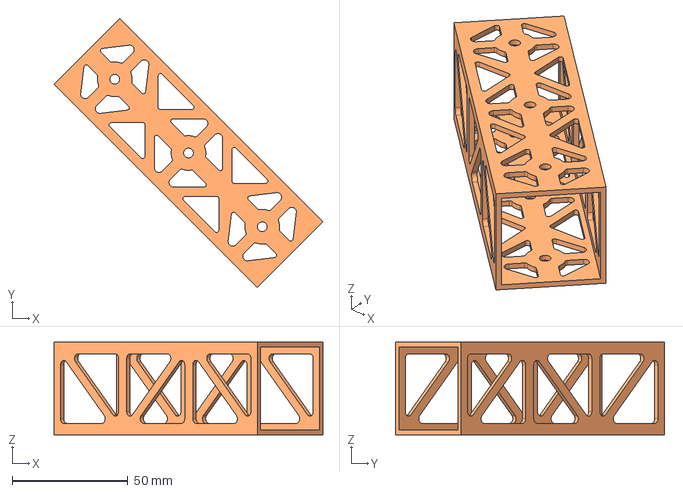
[picture p125: CAD file, 2025-07-04]
docs/pt3-assembly-guides/structural-assembly/assets/models/part5_6.step
116.1 x 116.1 x 40.0 mm
