Julius-eng/project-quiver-05032025/docs/pt3-assembly-guides/PCB-assembly/battery-connector-pcb.mdx

---
title: Battery Connector PCB
sidebar_position: 1
---

# Battery Connector PCB Assembly Manual

This manual will help with the project Quiver PT3 BC PCB (Battery connector PCB) assembly process.

> Note: This is not a final version of this document. As of this time (June 2025) this PCB is not tested yet and not fully assembled. The given instructions will give a general guide on the assembly process. Assembly should only be carried out by an experienced worker with experience in SMD soldering and the appropriate equipment. If you need this PCB fully assembled please contact: julius@arrowair.com

This PCB can be ordered (almost) fully assembled from the respective PCB manufacturer (e.g. JLCPCB). There are several parts that are normally not in stock at the PCB manufacturer and need to be sourced from one of the large electronic component distributors by the PCB manufacturer. This means that the production time for a finished PCB is around 3 weeks.

The large molex battery connectors (J9, J10) still need manual assembly at the moment. A quick explanation is written under the chapter: **Additional Steps**

The manual soldering of the circuit board can be done with the help of this interactive BOM which is stored in the respective github folder of this PCB:

## Interactive BOM

[Open Interactive BOM](./assets/Quiver_PT3_BC_PCB_V0.1_ibom.html)

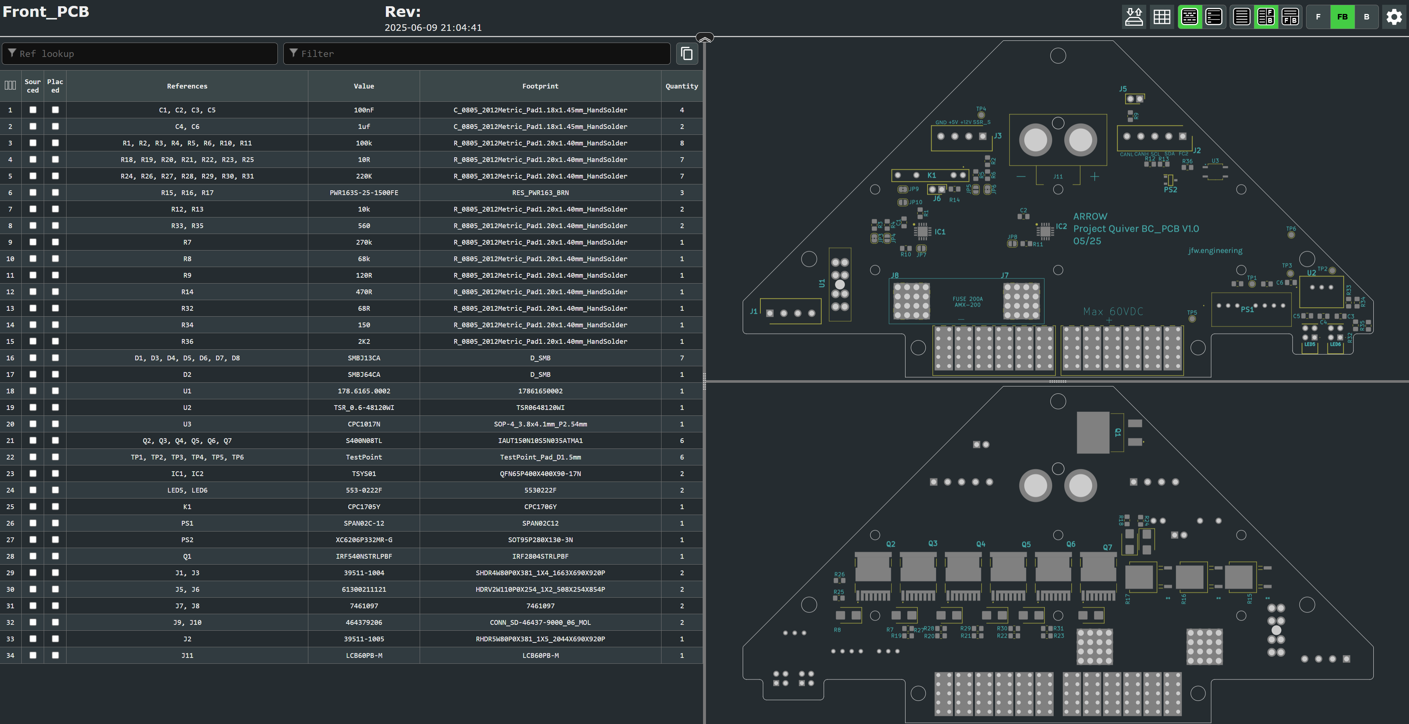
[picture p126: docs/pt3-assembly-guides/PCB-assembly/assets/bc-pcb/bom.png]
Interactive BOM screenshot


This is an HTML file that opens in the browser. On the left side is the parts list and on the right side are the views for the front and back of the circuit board. It will help to put the components in the right place.

It is essential to use a pcb stencil to place the solder paste in the right places. A reflow oven or a hot air blower (temperature and airflow controllable) should be used for the soldering process.

### View on the top side of this PCB:

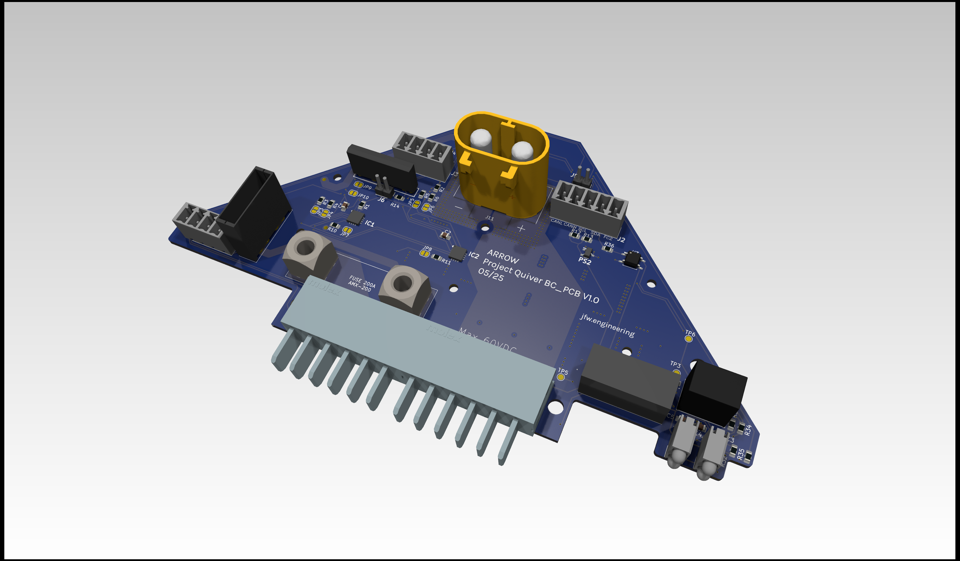
[picture p127: docs/pt3-assembly-guides/PCB-assembly/assets/bc-pcb/PCB_1.png]
Top side of PCB


### View on the bottom side of this PCB:

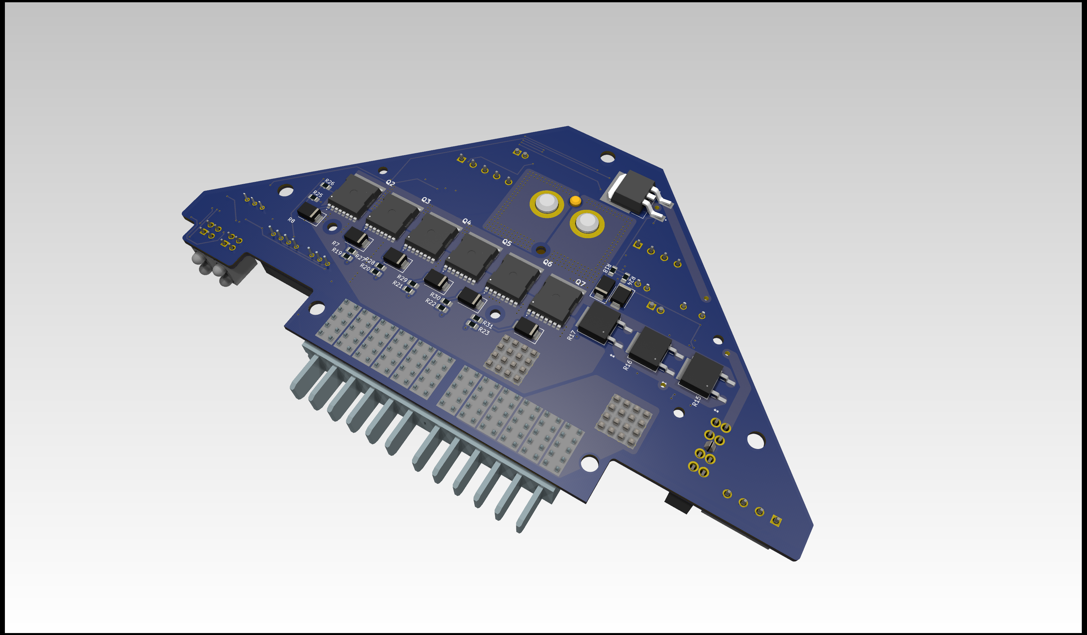
[picture p128: docs/pt3-assembly-guides/PCB-assembly/assets/bc-pcb/PCB_2.png]
Bottom side of PCB


## Additional Steps

1. Adding the Molex battery connector (J9, J10):

   The molex battery connector can not be bought in one piece at the moment (06/25). It's assembled from four individual parts (1x guiding pin left, 1x guiding pin right, 2x Molex 46437-9206). The guiding pins are sourced from a pre assembled Molex connector 464379-301. The individual parts can be clipped together and then inserted into the PCB. The connector pins should be manually soldered to the PCB.

   Molex connector

2. Installation of the heatsink:

   The heatsink must be attached to the PCB for the PCB to function properly. The heat sink is in direct contact with the frame of the drone and ensures that the power mosfets are well cooled.

   - Gap filler: Arctic TP-3 thermal pad: [https://www.arctic.de/TP-3/ACTPD00057A](https://www.arctic.de/TP-3/ACTPD00057A)
   - Nylon spacers: McMaster 99072A104
   - Screws: McMaster 92125A090
   - Washers: McMaster 95610A011
   - Nuts: McMaster 90591A270

   Please secure the screws of the heatsink with loctite.

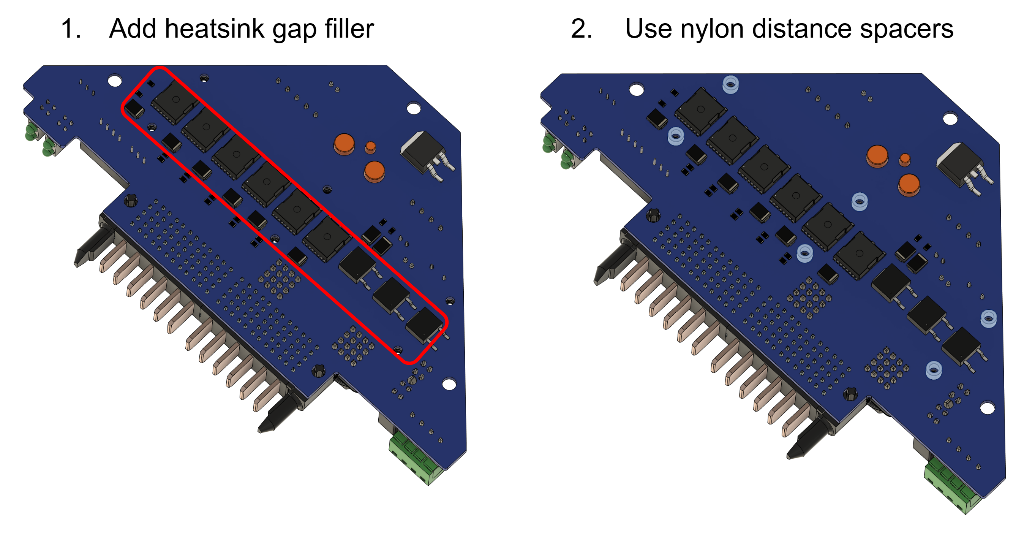
[picture p129: docs/pt3-assembly-guides/PCB-assembly/assets/bc-pcb/Heatsink_1.png]
Heatsink installation
   

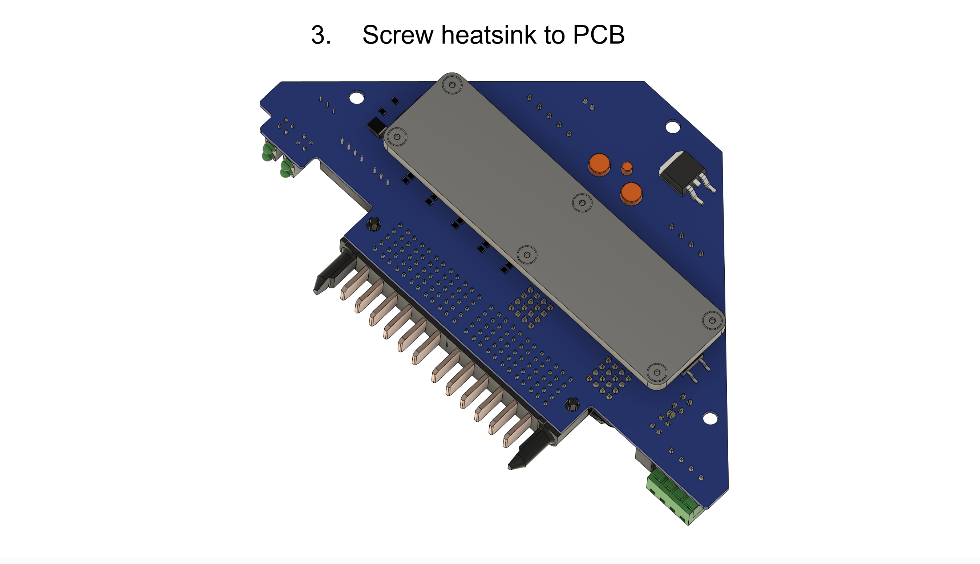
[picture p130: docs/pt3-assembly-guides/PCB-assembly/assets/bc-pcb/Heatsink_2.png]
Heatsink installed
   

3. Installation of the fuse:

   A AMX-200 fuse needs to be mounted between J7 and J8. Please use loctite to secure the screws.

   Example screws: McMaster 98093A213
