Julius-eng/project-quiver-05032025/docs/pt3-assembly-guides/PCB-assembly/flight-controller-pcb.mdx

---
title: Flight Controller PCB
sidebar_position: 2
---

# Flight Controller PCB Assembly Manual

This manual will help with the project Quiver PT3 FC PCB (Flight controller PCB) assembly process.

> Note: This is not a final version of this document. As of this time (June 2025) this PCB is not tested yet and not fully assembled. The given instructions will give a general guide on the assembly process. Assembly should only be carried out by an experienced worker with experience in SMD soldering and the appropriate equipment. If you need this PCB fully assembled please contact: julius@arrowair.com

This PCB can be ordered fully assembled from the respective PCB manufacturer (e.g. JLCPCB). The 100 pin connectors (J1, J2, J3) are normally not in stock and must be ordered from the manufacturer. This means that the production time for a finished PCB is around 3 weeks.

The manual soldering of the circuit board can be done with the help of this interactive BOM which is stored in the respective github folder of this PCB:

## Interactive BOM

[Open Interactive BOM](./assets/Quiver_PT3_FC_PCB_V0.1_ibom.html)

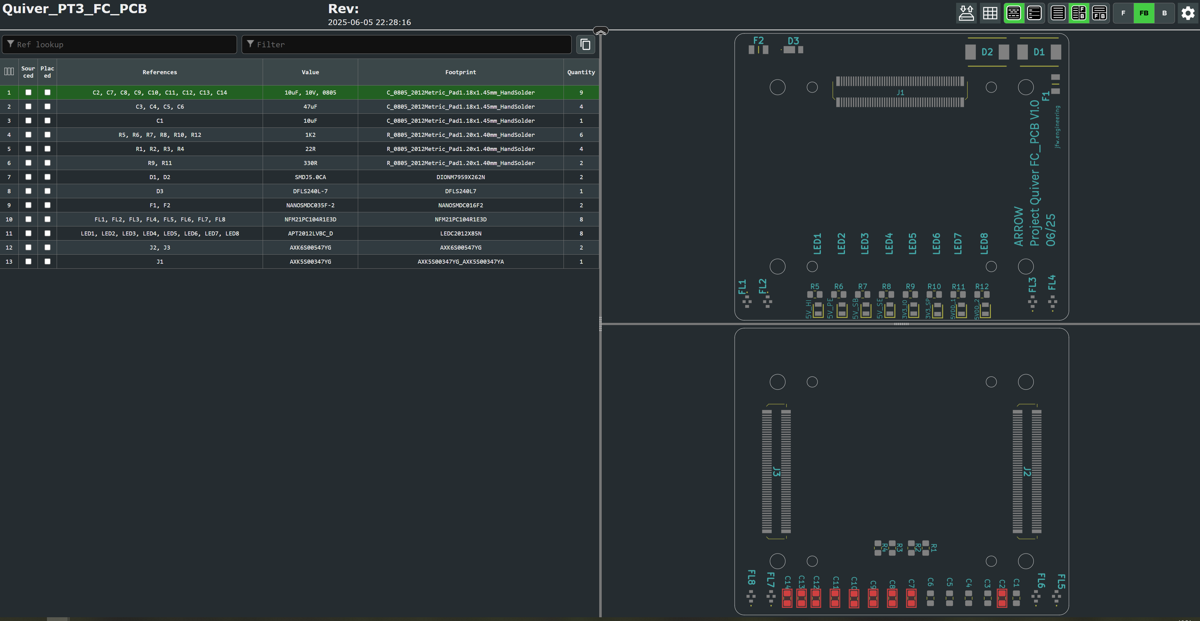
[picture p131: docs/pt3-assembly-guides/PCB-assembly/assets/fc-pcb/bom.png]
Interactive BOM screenshot


This is an HTML file that opens in the browser. On the left side is the parts list and on the right side are the views for the front and back of the circuit board. It will help to put the components in the right place.

It is essential to use a pcb stencil to place the solder paste in the right places. A reflow oven or a hot air blower (temperature and airflow controllable) should be used for the soldering process.

### View on the top side of this PCB (this side will connect to the pix32 v6 flight controller):

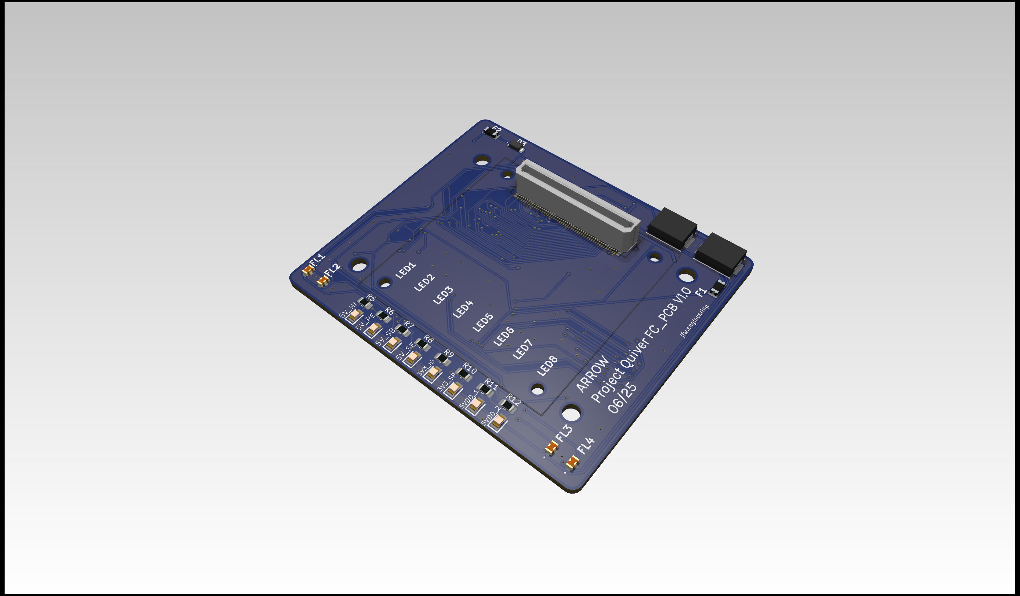
[picture p132: docs/pt3-assembly-guides/PCB-assembly/assets/fc-pcb/PCB_1.png]
Top side of PCB


### View on the bottom side of this PCB (this side will connect to the PT3 Main PCB):

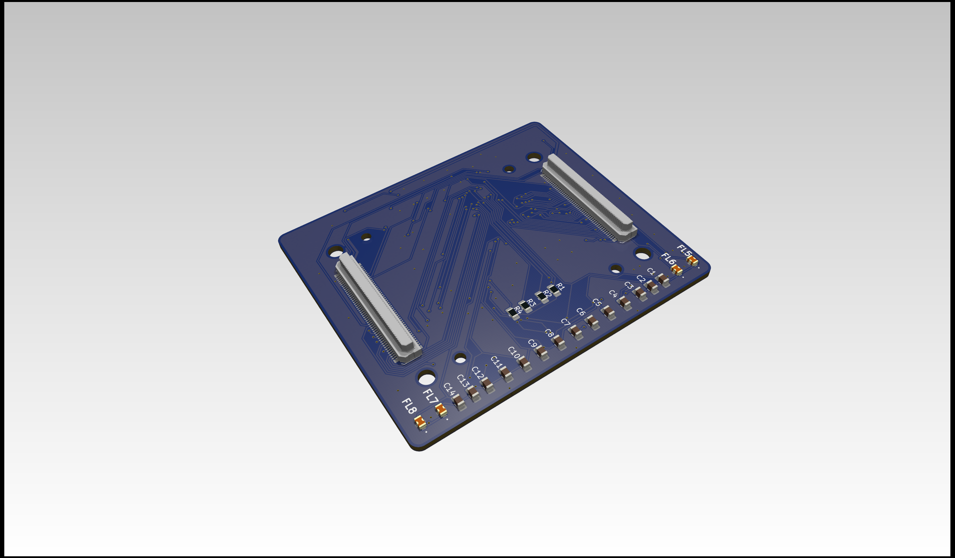
[picture p133: docs/pt3-assembly-guides/PCB-assembly/assets/fc-pcb/PCB_2.png]
Bottom side of PCB


## Additional Steps

- no additional steps at the moment
