Julius-eng/project-quiver-05032025/task-grant-bounty/pt1/electronics/0001-PDB_V1/Quiver-PDB-V1-Assembly-Manual.md

# Quiver PDB V1 Assembly Manual

This manual will help with the Quiver PDB V1 assembly process.\
Please work with the BOM of the project. It can be found in the github repository or on [google drive](https://docs.google.com/spreadsheets/d/1y5KGBi_LQUwVHGBvShN0OQPeAf_51J6Oxi9SjTfoWfo/edit?usp=sharing). Here is a picture of the current BOM (21.03.2025):



## Follow these 13 steps to finish the assembly:

### 1. Prepare the bare PCB



### 2. Pressfit the screw terminals



### 3. Fix the distance adapter



### 4. Solder the high power pins for the Matek PDB



### 5. Solder the two pin headers to the PCB



### 6. Matek PDB soldering



### 7. Bottom side preparation



### 8. Solder XT60 and copper rods



### 9. Bottom side is finished. Turn around the PCB again.



### 10. Solder the SMD components



### 11. Solder the fuse holders



### 12. Solder all outside facing connectors. After that all components are soldered onto the PCB.



### 13. Great job! The PCB is finished!
