Julius-eng/project-quiver-05032025/task-grant-bounty/pt2/project-quiver-pt2-complete-grant/manuals/pt2-structure-assembly-guide.md

# **Project Quiver PT2 structural assembly guide**

## BOM for the assembly

Table 1: Structure parts and additional material

| Part Nr. | Structure Part | Quantity |
| --- | --- | --- |
| 1 | Top plate 2mm aluminum | 1 |
| 2 | Bottom plate 2mm aluminum | 1 |
| 3 | Small square tube 40x40x2 aluminum (length: 124 mm) | 2 |
| 4 | Small square tube 40x40x2 aluminum (length: 289 mm) | 1 |
| 5 | Side rectangle 30x100x2 aluminum (length: 300 mm) | 2 |
| 6 | Attachment plate 4mm aluminum | 1 |
| 7 | Folding arm adapter | 4 |
| 8 | CF motor beam (length: 360mm) | 4 |
| 9 | CF landing leg beam (length: 400mm) | 4 |
| 10 | CF landing leg bottom beam (length: 500mm) | 2 |
| 11 | Landing leg adapter top (aluminum) | 4 |
| 12 | Landing leg adapter bottom (printed) | 4 |
| 13 | Battery slider | 2 |
| 14 | Rivet 1 (4mm Dia. for 2.5mm-4.5mm thickness; McMaster Part: [97525A251](https://www.mcmaster.com/97525A251)) | 36 |
| 15 | Rivet 2 (4mm Dia- for 4.5mm-6.4mm thickness; McMaster Part: [97525A226](https://www.mcmaster.com/97525A226)) | 10 |
| 16 | Screw 1 (Hex Drive Flat Head Screw M3x8, McMaster Part: [**92125A128**](https://www.mcmaster.com/92125A128)**)** | 48 |
| 17 | Screw 2 (Flanged Button Head Screw M4x10; McMaster Part: [97654A373](https://www.mcmaster.com/97654A373)) | 24 |
| 18 | Screw 3 (Socket Head Screw M3x16; McMaster Part: [91292A115](https://www.mcmaster.com/91292A115)) | 24 |
| 19 | Washer 1 (General Purpose Washer 3.2mm ID, 6mm OD; McMaster Part: [98689A112](https://www.mcmaster.com/98689A112/)) | 24 |
| 20 | Nut 1 (Nylon-Insert Locknut M3; McMaster Part: [**90576A811**](https://www.mcmaster.com/90576A811/)**)** | 24 |

## Preparation

- You need the following tools:
  - Allen key set
  - Wrench set
  - Cordless screwdriver or drill press
  - Chamfering drill bit for 3mm holes
  - Riveting tool
  - Adhesive application tool
  - Loctite
  - Adhesive (for aluminum parts). Note: The adhesive is mostly to reduce vibrations. It's not really needed for structural robustness. The additional strength is just a positive additional point.
  - Cleaning agent
- Check if all the necessary parts are there

## Assembly steps

### Step 1: Prepare the top and bottom aluminum plate

- Parts you need in this step: 1x Bottom plate; 1x Top plate

- Get the top aluminum plate and the bottom aluminum plate ready.

  

- Note: The plates are not symmetrical. The holes for the long square aluminum tube and the short aluminum tube are different. For the next step, you need to make sure that you are applying the chamfers to the correct side.

  

  

- Use the chamfer bit and your cordless screwdriver to create chamfers on the drill holes for the folding motor arm adapter on the top and bottom aluminum plate. You can check with one of the designated screws if you chamfer is wide enough. The next picture shows which holes need the chamfer.

  

  

- Clean the two plates from any metal dust.

- Set aside the top plate. You will need the bottom plate in the next step.

### Step 2: Assemble the bottom plate with the small square tubes

- Parts you need in this step: 1x Bottom plate, 2x Small square tube 40x40x2 aluminum (length: 124 mm), 1x Small square tube 40x40x2 aluminum (length: 289 mm), 13x Rivet 1

- Clean all parts from fat residues and dust.

- Lay down the three square tubes like in the picture and apply some adhesive near the holes.

  

- Place the bottom plate over it and and rivet the components together with the 13 rivets shown in the next picture. Make sure the chamfers are facing upwards.

  

### Step 3:

- Parts you need in this step: 4x Motor arm adapter, 24x Screw 1
- Place the motor arm connectors under the 2mm plate. Orientate the motor arm adapters in the same folding direction.
- Screw the motor arm adapters to the assembly with 24x Screw 1. Use loctite to secure the screws!

  

### Step 4:

- Parts you need in this step: 2x Side rectangle 30x100x2 aluminum, 10x Rivet 2

- Clean all parts from fat residues and dust.

- Place the rectangular tubes parallel to each other and apply adhesive to the top around the rivet holes.

  

- Turn around the assembly.

- Rivet the aluminum sides to the assembly with 10x Rivet 2.

  

### Step 5:

- Parts you need in this step: 1x Top plate, 13x Rivet 1, 24x Screw 1

- Clean all parts from fat residues and dust.

- Apply some adhesive on the top surface of the square tubes around the rivet holes.

  

- Place the top plate on top of the assembly and rivet it together with 13x Rivet 1. Use 24x Screw 1 to also screw the top plate to the motor arm connectors. Use loctite to secure the screws!

  

### Step 6:

- Parts you need in this step: 1x Attachment plate

- Clean all parts from fat residues and dust.

- Apply some adhesive on the top surface of the rectangular aluminum tubes near the rivet holes.

  

- Place the attachment plate on the structure and rivet it together with 10x Rivet 2.

  

### Step 7:

- Parts you need in this step: 4x Aluminum landing leg adapter, 16x Screw 2

- Place the landing leg adapters in the corners of the structure. The adapters are facing outside to the left and right of the structure.

  

- Screw the adapters with 16x Screw 2 to the assembly. Use loctite to secure the screws!

  

### Step 8:

- Parts you need in this step: 4x CF landing leg beam (length: 400mm), Screw package from the aluminum landing leg adapters
- Insert the four CF landing leg beams into the landing leg adapters. Use the screws that came with the landing gear adapters to secure the tubes in place. Use loctite to secure the screws.

  

### Step 9:

- Parts you need in this step: 2x CF landing leg bottom beam (500mm), 4x Landing leg adapter bottom (printed), 24x Screw 3, 24x Washer 1, 24x Nut 1

- Prepare the bottom lending legs with the 3D printed adapters like in the following picture.

  

- Place the prepared bottom landing gear on the four carbon fiber tubes that were previously screwed into the structure.

  

- Fix the landing gear in place with 24x Screw 3, 24x Washer 1, 24x Nut 1.

  

### Step 10:

- Parts you need in this step: 2x Battery slider, 8x Screw 2

- Place the 3D printed battery sliders inside the frame. The angled end is orientated to the front of the structure (were the cutouts in the plates are).

  

- Use 8x Screw 2 to fix the two battery sliders to the frame. Secure the screws with loctite.

  

### Step 11:

- Parts you need in this step: 4x CF motor beam (length: 360mm), Screw package from motor beam adapter
- Place the 4 motor beams into the foldable motor beam adapter. Use the screw package that came with the foldable motor beam adapter to secure the motor beams to the structure. Secure the screws with loctite!

  

### The assembly of the quiver PT2 structure is finished.

If you assembled it right your structure should look almost like the following picture.
