Julius-eng/project-quiver-05032025/docs/pt3-assembly-guides/harnessing-guide/assets/Wire Data - Main_PCB.pdf

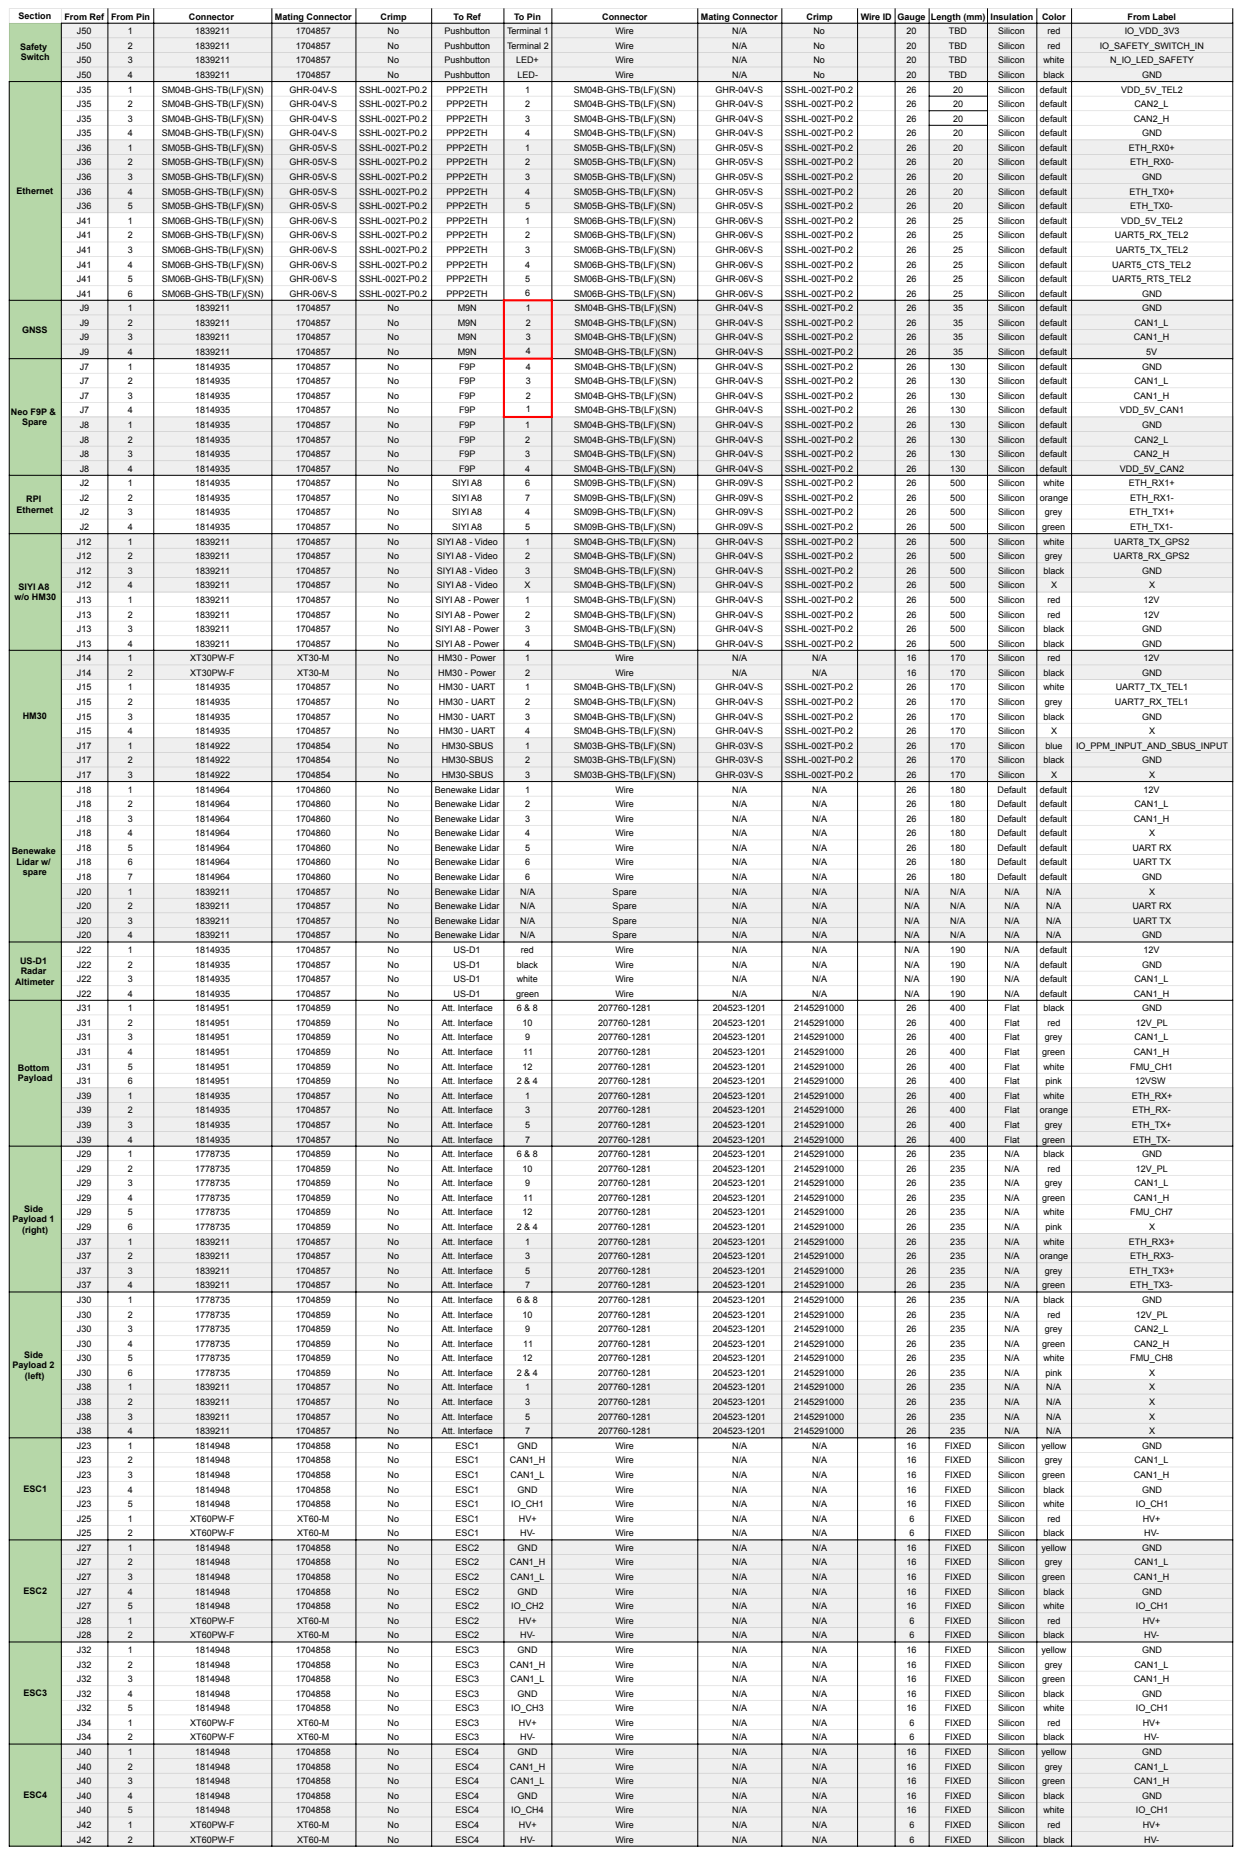
[picture p193: page 1]

RPI Ethernet | J2 J2 | 1 2 3 4 | 1814935 1814935 | 1704857 1704857 | No No | SIYI A8 SIYI A8 | 6 7 4 5 | SM09B-GHS-TB(LF)(SN) SM09B-GHS-TB(LF)(SN) | GHR-09V-S GHR-09V-S | SSHL-002T-P0.2 SSHL-002T-P0.2 | 26 26 | 500 500 | Silicon Silicon | white orange grey green | ETH_RX1+ ETH_RX1-ETH_TX1+ ETH_TX1-

SIYI A8 w/o HM30 | J12 J12 J12 J12 J13 J13 J13 J13 | 1 2 3 4 | 1839211 1839211 1839211 1839211 | 1704857 1704857 1704857 1704857 | No No No No | SIYI A8 - Video SIYI A8 - Video SIYI A8 - Video SIYI A8 - Video SIYI A8 - Power SIYI A8 - Power SIYI A8 - Power SIYI A8 - Power | 1 2 3 X 1 2 3 4 | SM04B-GHS-TB(LF)(SN) SM04B-GHS-TB(LF)(SN) SM04B-GHS-TB(LF)(SN) SM04B-GHS-TB(LF)(SN) SM04B-GHS-TB(LF)(SN) SM04B-GHS-TB(LF)(SN) SM04B-GHS-TB(LF)(SN) SM04B-GHS-TB(LF)(SN) | GHR-04V-S GHR-04V-S GHR-04V-S GHR-04V-S | SSHL-002T-P0.2 SSHL-002T-P0.2 SSHL-002T-P0.2 SSHL-002T-P0.2 | 26 26 26 26 | 500 500 500 500 | Silicon Silicon Silicon Silicon | white grey black X red red black black | UART8_TX_GPS2 UART8_RX_GPS2 GND X 12V 12V GND GND

HM30 | J14 J14 J15 J15 J15 J15 J17 J17 J17 | 1 2 1 2 3 4 1 2 3 | XT30PW-F XT30PW-F 1814935 1814935 1814935 1814935 1814922 1814922 1814922 | XT30-M XT30-M 1704857 1704857 1704857 1704857 1704854 1704854 1704854 | No No No No No No No No No | HM30 - Power HM30 - Power HM30 - UART HM30 - UART HM30 - UART HM30 - UART HM30-SBUS HM30-SBUS HM30-SBUS | 1 2 1 2 3 4 1 2 3 | Wire Wire SM04B-GHS-TB(LF)(SN) SM04B-GHS-TB(LF)(SN) SM04B-GHS-TB(LF)(SN) SM04B-GHS-TB(LF)(SN) SM03B-GHS-TB(LF)(SN) SM03B-GHS-TB(LF)(SN) SM03B-GHS-TB(LF)(SN) | N/A N/A GHR-04V-S GHR-04V-S GHR-04V-S GHR-04V-S GHR-03V-S GHR-03V-S GHR-03V-S | N/A N/A SSHL-002T-P0.2 SSHL-002T-P0.2 SSHL-002T-P0.2 SSHL-002T-P0.2 SSHL-002T-P0.2 SSHL-002T-P0.2 SSHL-002T-P0.2 | 16 16 26 26 26 26 26 26 26 | 170 170 170 170 170 170 170 170 170 | Silicon Silicon Silicon Silicon Silicon Silicon Silicon Silicon Silicon | red black white grey black X blue black X | 12V GND UART7_TX_TEL1 UART7_RX_TEL1 GND X IO_PPM_INPUT_AND_SBUS_INPUT GND X

Benewake Lidar w/ spare | J18 J18 J18 J18 J18 J18 J18 J20 J20 J20 J20 | 1 2 3 4 5 6 7 1 2 3 4 | 1814964 1814964 1814964 1814964 1814964 1814964 1814964 1839211 1839211 1839211 1839211 | 1704860 1704860 1704860 1704860 1704860 1704860 1704860 1704857 1704857 1704857 1704857 | No No No No No No No No No No No | Benewake Lidar Benewake Lidar Benewake Lidar Benewake Lidar Benewake Lidar Benewake Lidar Benewake Lidar Benewake Lidar Benewake Lidar Benewake Lidar Benewake Lidar | 1 2 3 4 5 6 6 N/A N/A N/A N/A | Wire Wire Wire Wire Wire Wire Wire Spare Spare Spare Spare | N/A N/A N/A N/A N/A N/A N/A N/A N/A N/A N/A | N/A N/A N/A N/A N/A N/A N/A N/A N/A N/A N/A | 26 26 26 26 26 26 26 N/A N/A N/A N/A | 180 180 180 180 180 180 180 N/A N/A N/A N/A | Default Default Default Default Default Default Default N/A N/A N/A N/A | default default default default default default default N/A N/A N/A N/A | 12V CAN1_L CAN1_H X UART RX UART TX GND X UART RX UART TX GND

US-D1 Radar Altimeter | J22 J22 | 1 2 3 4 | 1814935 1814935 | 1704857 1704857 | No No | US-D1 US-D1 | red black white green | Wire Wire | N/A N/A | N/A N/A | N/A N/A | 190 190 | N/A N/A | default default | 12V GND CAN1_L CAN1_H

Bottom Payload | J31 J31 J31 J31 J31 J31 J39 J39 J39 J39 | 1 2 3 4 5 6 1 2 3 4 | 1814951 1814951 1814951 1814951 1814951 1814951 1814935 1814935 1814935 1814935 | 1704859 1704859 1704859 1704859 1704859 1704859 1704857 1704857 1704857 1704857 | No No No No No | Att. Interface Att. Interface Att. Interface Att. Interface Att. Interface | 6 & 8 10 9 11 12 2 & 4 1 3 5 7 | 207760-1281 207760-1281 207760-1281 207760-1281 207760-1281 | 204523-1201 204523-1201 204523-1201 204523-1201 204523-1201 | 2145291000 2145291000 2145291000 2145291000 2145291000 | 26 26 26 26 26 | 400 400 400 400 400 | Flat Flat Flat Flat Flat | black red grey green white pink white orange grey green | GND 12V_PL CAN1_L CAN1_H FMU_CH1 12VSW ETH_RX+ ETH_RX-ETH_TX+ ETH_TX-

Side Payload 1 (right) | J29 J29 J29 J29 J29 J29 J37 J37 J37 J37 | 1 2 3 4 5 6 1 2 3 4 | 1778735 1778735 1778735 1778735 1778735 1778735 1839211 1839211 1839211 1839211 | 1704859 1704859 1704859 1704859 1704859 1704859 1704857 1704857 1704857 1704857 | No No No No No | Att. Interface Att. Interface Att. Interface Att. Interface Att. Interface | 6 & 8 10 9 11 12 2 & 4 1 3 5 7 | 207760-1281 207760-1281 207760-1281 207760-1281 207760-1281 | 204523-1201 204523-1201 204523-1201 204523-1201 204523-1201 | 2145291000 2145291000 2145291000 2145291000 2145291000 | 26 26 26 26 26 | 235 235 235 235 235 | N/A N/A N/A N/A N/A | black red grey green white pink white orange grey green | GND 12V_PL CAN1_L CAN1_H FMU_CH7 X ETH_RX3+ ETH_RX3-ETH_TX3+ ETH_TX3-

Side Payload 2 (left) | J30 J30 J30 J30 J30 J30 J38 J38 J38 J38 | 1 2 3 4 5 6 1 2 3 4 | 1778735 1778735 1778735 1778735 1778735 1778735 1839211 1839211 1839211 1839211 | 1704859 1704859 1704859 1704859 1704859 1704859 1704857 1704857 1704857 1704857 | No No No No No | Att. Interface Att. Interface Att. Interface Att. Interface Att. Interface | 6 & 8 10 9 11 12 2 & 4 1 3 5 7 | 207760-1281 207760-1281 207760-1281 207760-1281 207760-1281 | 204523-1201 204523-1201 204523-1201 204523-1201 204523-1201 | 2145291000 2145291000 2145291000 2145291000 2145291000 | 26 26 26 26 26 | 235 235 235 235 235 | N/A N/A N/A N/A N/A | black red grey green white pink N/A N/A N/A N/A | GND 12V_PL CAN2_L CAN2_H FMU_CH8 X X X X X

ESC1 | J23 J23 J23 J23 J23 J25 J25 | 1 2 3 4 5 1 2 | 1814948 1814948 1814948 1814948 1814948 XT60PW-F XT60PW-F | 1704858 1704858 1704858 1704858 1704858 XT60-M XT60-M | No No No No No No No | ESC1 ESC1 ESC1 ESC1 ESC1 ESC1 ESC1 | GND CAN1_H CAN1_L GND IO_CH1 HV+ HV- | Wire Wire Wire Wire Wire Wire Wire | N/A N/A N/A N/A N/A N/A N/A | N/A N/A N/A N/A N/A N/A N/A | 16 16 16 16 16 6 6 | FIXED FIXED FIXED FIXED FIXED FIXED FIXED | Silicon Silicon Silicon Silicon Silicon Silicon Silicon | yellow grey green black white red black | GND CAN1_L CAN1_H GND IO_CH1 HV+ HV-

ESC2 | J27 J27 J27 J27 J27 J28 J28 | 1 2 3 4 5 1 2 | 1814948 1814948 1814948 1814948 1814948 XT60PW-F XT60PW-F | 1704858 1704858 1704858 1704858 1704858 XT60-M XT60-M | No No No No No No No | ESC2 ESC2 ESC2 ESC2 ESC2 ESC2 ESC2 | GND CAN1_H CAN1_L GND IO_CH2 HV+ HV- | Wire Wire Wire Wire Wire Wire Wire | N/A N/A N/A N/A N/A N/A N/A | N/A N/A N/A N/A N/A N/A N/A | 16 16 16 16 16 6 6 | FIXED FIXED FIXED FIXED FIXED FIXED FIXED | Silicon Silicon Silicon Silicon Silicon Silicon Silicon | yellow grey green black white red black | GND CAN1_L CAN1_H GND IO_CH1 HV+ HV-

ESC3 | J32 J32 J32 J32 J32 J34 J34 | 1 2 3 4 5 1 2 | 1814948 1814948 1814948 1814948 1814948 XT60PW-F XT60PW-F | 1704858 1704858 1704858 1704858 1704858 XT60-M XT60-M | No No No No No No No | ESC3 ESC3 ESC3 ESC3 ESC3 ESC3 ESC3 | GND CAN1_H CAN1_L GND IO_CH3 HV+ HV- | Wire Wire Wire Wire Wire Wire Wire | N/A N/A N/A N/A N/A N/A N/A | N/A N/A N/A N/A N/A N/A N/A | 16 16 16 16 16 6 6 | FIXED FIXED FIXED FIXED FIXED FIXED FIXED | Silicon Silicon Silicon Silicon Silicon Silicon Silicon | yellow grey green black white red black | GND CAN1_L CAN1_H GND IO_CH1 HV+ HV-

ESC4 | J40 J40 J40 J40 J40 J42 J42 | 1 2 3 4 5 1 2 | 1814948 1814948 1814948 1814948 1814948 XT60PW-F XT60PW-F | 1704858 1704858 1704858 1704858 1704858 XT60-M XT60-M | No No No No No No No | ESC4 ESC4 ESC4 ESC4 ESC4 ESC4 ESC4 | GND CAN1_H CAN1_L GND IO_CH4 HV+ HV- | Wire Wire Wire Wire Wire Wire Wire | N/A N/A N/A N/A N/A N/A N/A | N/A N/A N/A N/A N/A N/A N/A | 16 16 16 16 16 6 6 | FIXED FIXED FIXED FIXED FIXED FIXED FIXED | Silicon Silicon Silicon Silicon Silicon Silicon Silicon | yellow grey green black white red black | GND CAN1_L CAN1_H GND IO_CH1 HV+ HV-
