Julius-eng/project-quiver-05032025/docs/pt3-assembly-guides/structural-assembly/assets/images/step9_6.png

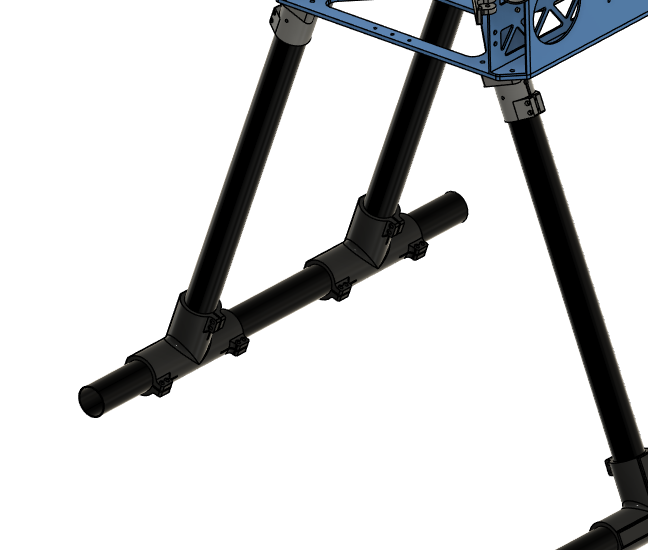
docs/pt3-assembly-guides/structural-assembly/assets/images/step9_6.png
