Julius-eng/project-quiver-05032025/task-grant-bounty/general/structural/0001-3d_printing_FEA_workflow_study/image/basf_abs_properties_2.jpg

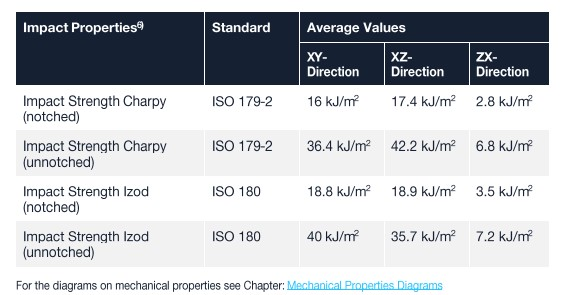
task-grant-bounty/general/structural/0001-3d_printing_FEA_workflow_study/image/basf_abs_properties_2.jpg
