Julius-eng/project-quiver-05032025/task-grant-bounty/pt1/electronics/0001-PDB_V1/manual-data/step_12.png

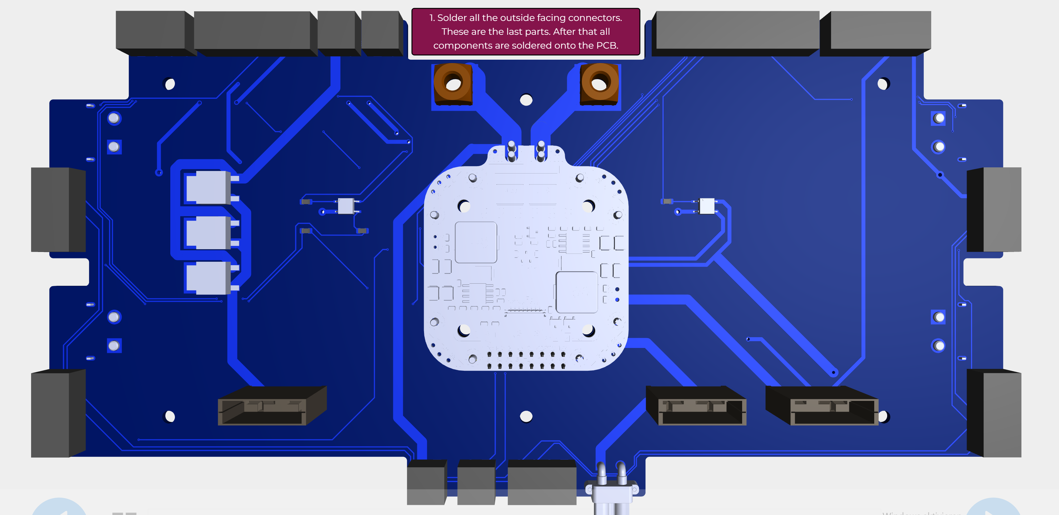
task-grant-bounty/pt1/electronics/0001-PDB_V1/manual-data/step_12.png
