Julius-eng/project-quiver-05032025/task-grant-bounty/pt2/electronics/0001-electronics-assembly-manual/pictures/1-12.png

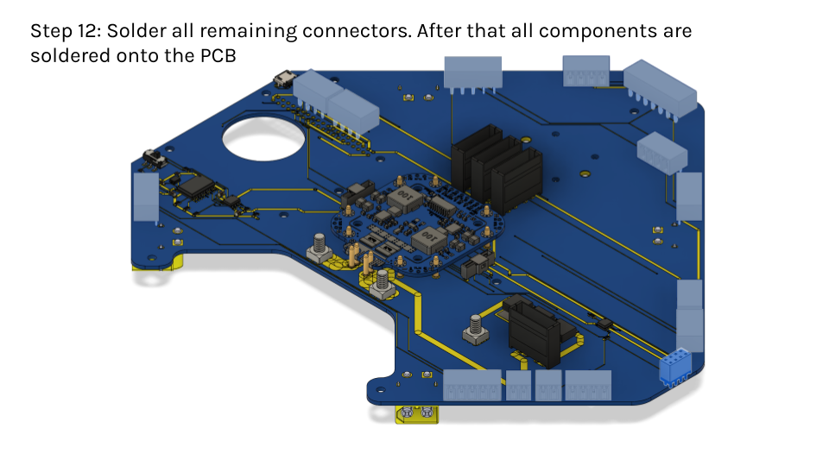
task-grant-bounty/pt2/electronics/0001-electronics-assembly-manual/pictures/1-12.png
