Julius-eng/project-quiver-05032025/task-grant-bounty/pt2/project-quiver-pt2-complete-grant/manuals/pictures/Image_21.png

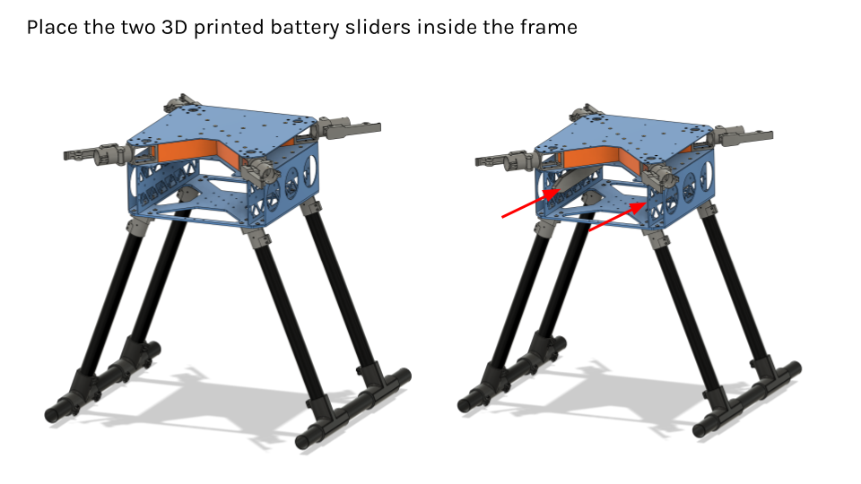
task-grant-bounty/pt2/project-quiver-pt2-complete-grant/manuals/pictures/Image_21.png
