Julius-eng/project-quiver-05032025/flight-test/PT1/assets/002/images/2.jpg

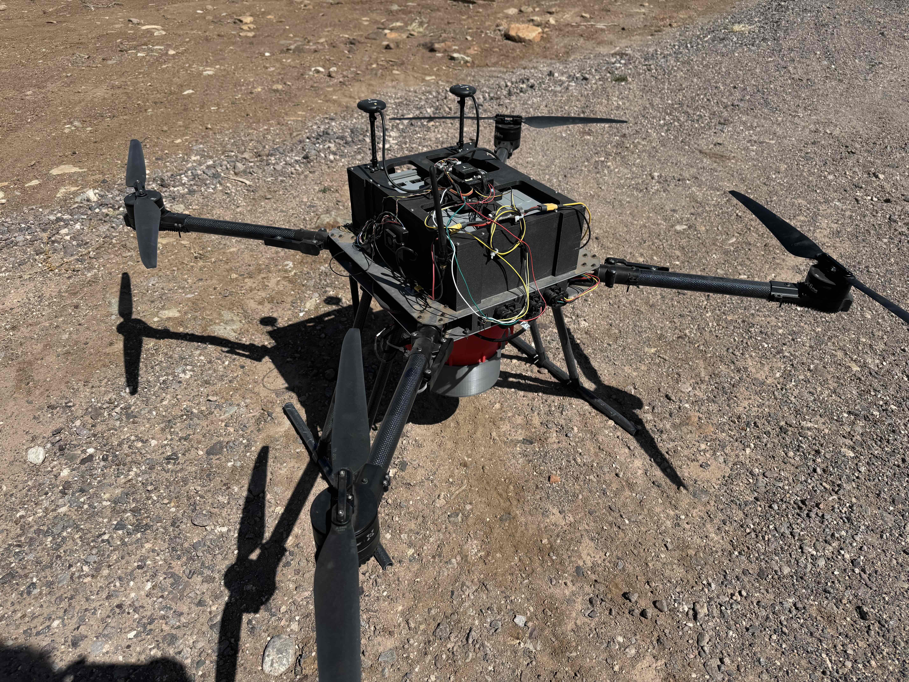
flight-test/PT1/assets/002/images/2.jpg
