Julius-eng/project-quiver-05032025/task-grant-bounty/pt2/flight-test/0002/images/motor_outputs.png

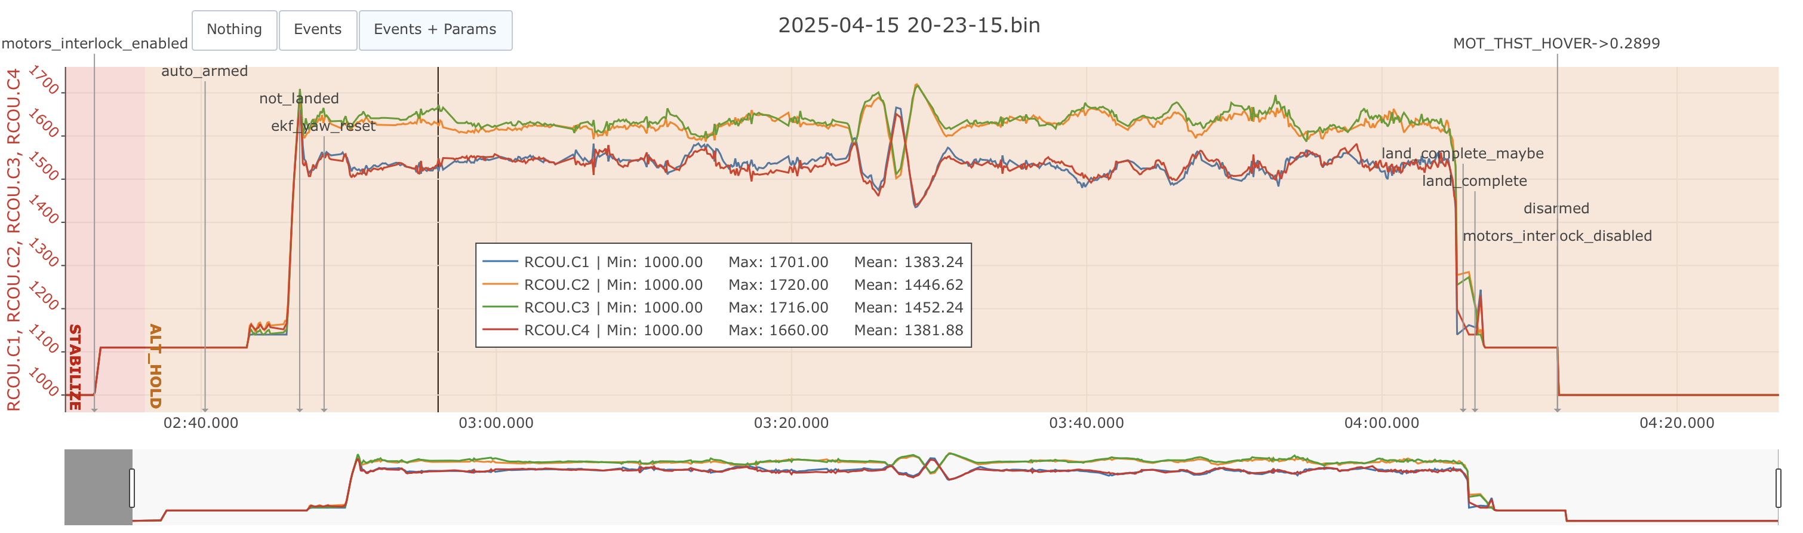
task-grant-bounty/pt2/flight-test/0002/images/motor_outputs.png
