Julius-eng/project-quiver-05032025/task-grant-bounty/pt2/flight-test/0004/images/rc_inputs.png

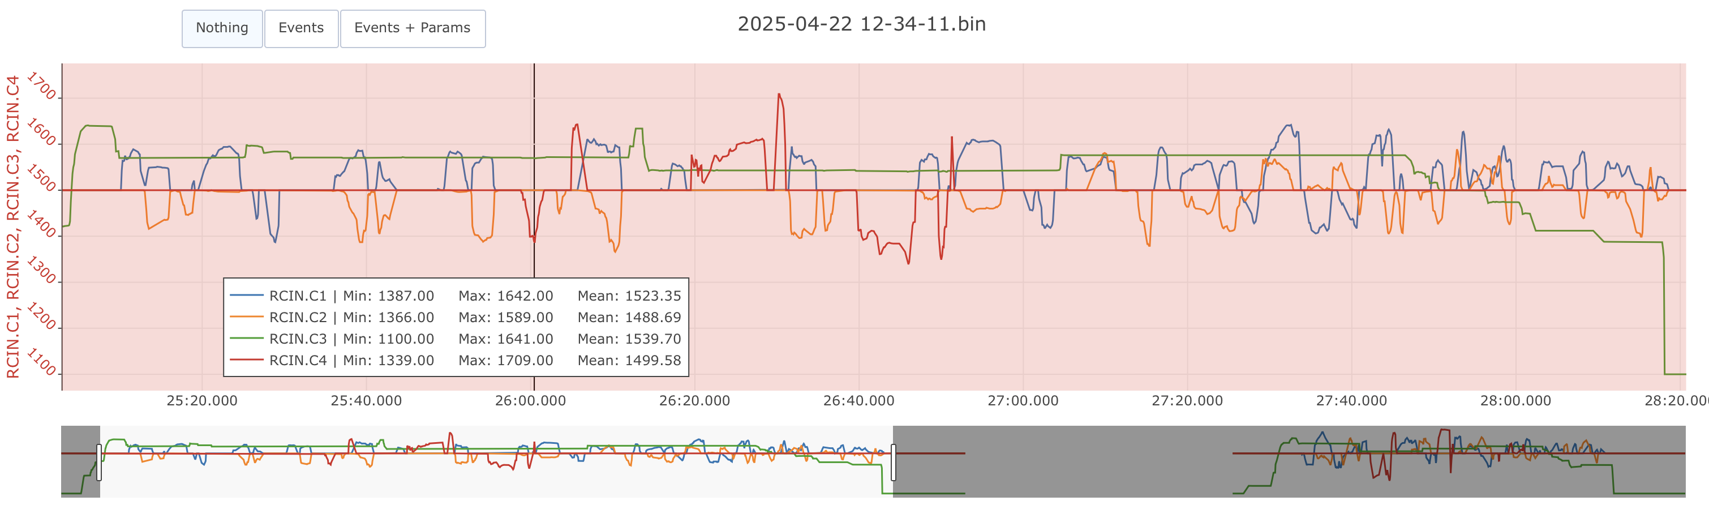
task-grant-bounty/pt2/flight-test/0004/images/rc_inputs.png
