Julius-eng/project-quiver-05032025/task-grant-bounty/pt2/flight-test/0005/images/altitude.png

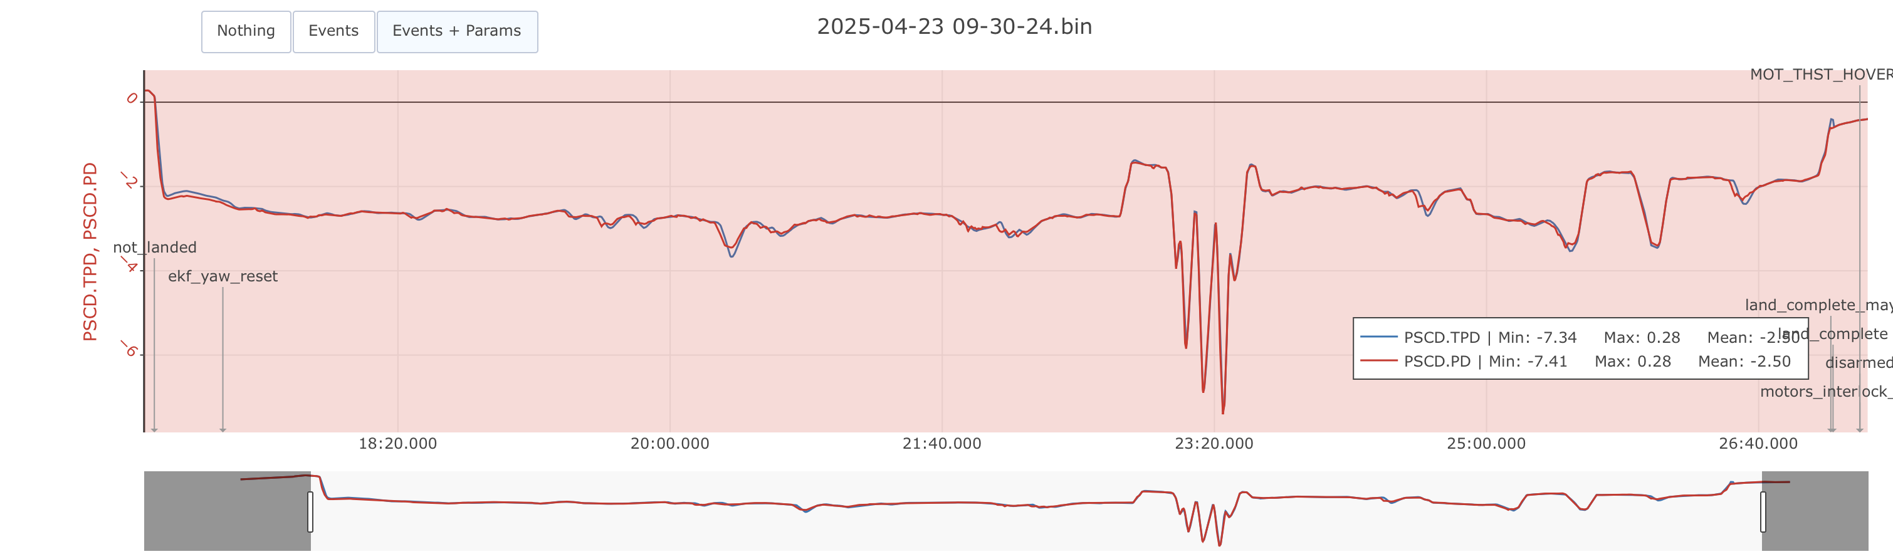
task-grant-bounty/pt2/flight-test/0005/images/altitude.png
