Julius-eng/project-quiver-05032025/task-grant-bounty/pt2/flight-test/0006/images/yaw.png

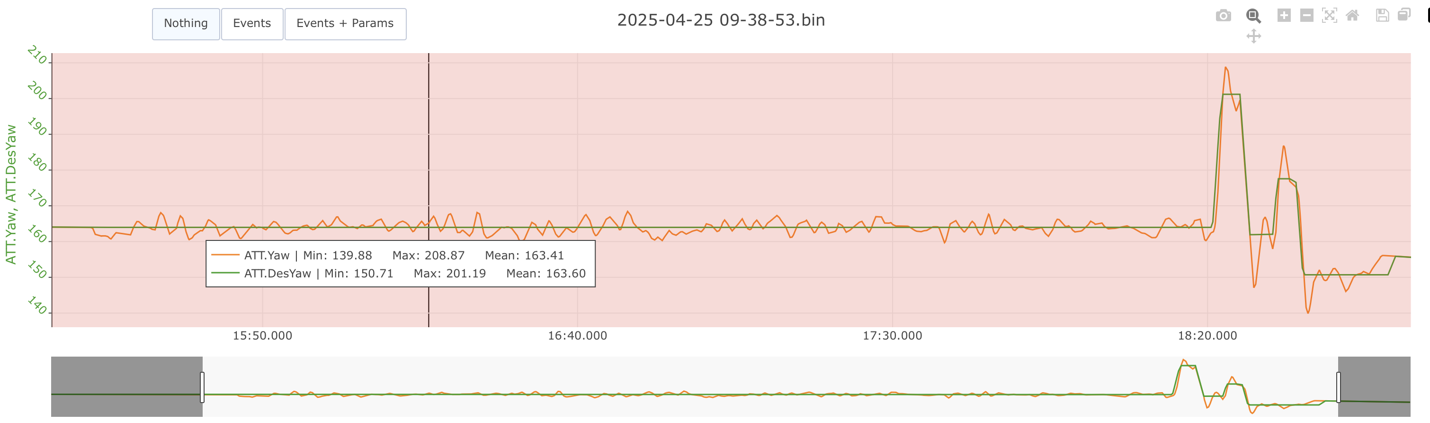
task-grant-bounty/pt2/flight-test/0006/images/yaw.png
