Julius-eng/project-quiver-05032025/task-grant-bounty/pt1/flight-test/0001-list-of-issues/information-note.md

# Status  

`Valid`

# Project Description

Project Quiver – Prototype 1 (PT1) flight logs between folders 1-6 underwent a comprehensive flight log review as part of its ongoing development and flight validation process. The goal of this phase was to evaluate PT1's performance under various flight conditions by manually reviewing all available flight test logs. This preliminary analysis is intended to identify potential issues for further investigation and to support the next stages of tuning and flight control refinement.

# Methodology

Each individual log file was manually sorted and thoroughly examined. Specific focus areas included:

- Flight modes and their transitions  
- Duration of each flight and executed maneuvers  
- Vibration levels during operation  
- GPS performance and satellite fix quality  
- EKF (Extended Kalman Filter) status, including any resets  
- Battery voltage consistency and ESC (Electronic Speed Controller) readings  
- General behavior of the flight controller  
- Trends in motor output signals  
- Additional general observations relevant to flight performance

Key findings and recurring patterns were documented throughout the review process. A summary table was prepared to consolidate the results, and it will also be shared in `.xlsx` format for future reference.

# Results and Deliverables

The review yielded several recurring issues requiring further investigation:

### 1. ESC0 Voltage Discrepancy

In all examined flights, the voltage reading from **ESC0** consistently appears approximately **0.5V lower** than that of the other ESCs and the main battery voltage. This may indicate a **sensor offset or measurement error**, and further investigation is required to confirm its cause and impact.

### 2. Motor Output Divergence

In some tests, particularly **while on the ground** and occasionally during **yaw inputs in flight**, motor outputs show **significant divergence** and in a small number of tests **hitting the motor limits**. These deviations may point to control imbalance or tuning inconsistencies.

### 3. Ground Resonance on Landing

Ground resonance phenomena were observed during **landings**, particularly during the **March 22, 2025** tests. This effect was **mostly seen in AUTO mode** and **to a lesser extent in POS mode**. These events should be reviewed in connection with landing gear dynamics and control system behavior near touchdown.

### 4. Oscillations and Tracking Deficiency in POS and AUTO Modes

Minor **oscillatory behavior** was noted in **Position Hold (POS)** and **AUTO** modes. Additionally, it was observed that **actual control parameters do not follow the target values as precisely as in STABILIZE mode**. A noticeable **altitude loss during the deceleration phase** suggests that both the **inner-most and outer-loop controllers** may require **further tuning**, which can be effectively performed using the existing flight test data. Although it appears to be better in the later tests, a suitable gain set should be utilized.

### 5. EKF Yaw Resets

**EKF yaw resets** were detected in **every test log**. While some yaw resets may occur under normal conditions, this recurring behavior warrants further analysis to ensure there is **no underlying issue being masked**, such as magnetic interference, poor GPS heading initialization, or insufficient yaw observability.

### 6. Yaw Reference Initialization Offset

In a small number of tests, the **initial yaw reference value** was found to be slightly offset from the **actual yaw angle**. Although observed infrequently, this inconsistency should be examined to ensure proper heading alignment during mission-critical operations.

A detailed summary table of all log file reviews can be found at the end of this document and is also available as an `.xlsx` file in the project folder.

# Remarks

The manual review of PT1’s flight logs has provided valuable insights into recurring issues and performance trends. While the overall system shows promising behavior, several areas require further analysis and tuning, particularly in relation to ESC readings, yaw stability, and controller performance in autonomous modes. The observations made during this phase will directly inform the upcoming test campaigns and system refinements.

 ---
 
 ## Summary Table of Log Reviews
 
 | Log Name     | Date                | Flight Summary                                                                       | Flight Modes   | Flight Duration     | Vibration Levels                    | GPS                  | EKF         | Power                               | Flight Performance                                                                     | Motor Outputs                                          | Error Messages   | Comments                                                                |
 |:-------------|:--------------------|:-------------------------------------------------------------------------------------|:---------------|:--------------------|:------------------------------------|:---------------------|:------------|:------------------------------------|:---------------------------------------------------------------------------------------|:-------------------------------------------------------|:-----------------|:------------------------------------------------------------------------|
 | 00000095.BIN | 2025-03-20 | On-Ground                                                                            | STAB           | 01:00 | OK                                  | OK                   | OK          | OK                                  | -                                                                                      | Random zeros?                                          | -                | -                                                                     |
 | 00000096.BIN | 2025-03-20 | Hover, stabilization                                                                 | STAB, ALT, POS | 01:35 | OK                                  | OK                   | 2 Yaw Reset | OK                                  | Good                                                                                   | Good, 2-4 giving more                                  | -                | Pitch and roll performance great                                        |
 | 00000097.BIN | 2025-03-20 | Hover, small inputs                                                                  | STAB, POS      | 03:20 | OK                                  | OK                   | 2 Yaw Reset | OK                                  | Good                                                                                   | Good, too much change during yaw inputs                | -                | Yaw input response should be studied                                    |
 | 00000098.BIN | 2025-03-20 | On-Ground                                                                            | STAB           | 00:15 | Higher but safe                     | OK                   | OK          | OK                                  | -                                                                                      | Hitting limits on ground                               | -                | ?                                                                       |
 | 00000099.BIN | 2025-03-20 | Horizontal Movements                                                                 | STAB, POS      | 03:00 | OK                                  | OK                   | 2 Yaw Reset | OK                                  | Good, POS needs tuning                                                                 | Good, too much change during yaw inputs                | -                | -                                                                     |
 | 00000100.BIN | 2025-03-21 | On-Ground                                                                            | STAB           | 00:30 | OK                                  | OK                   | OK          | OK                                  | -                                                                                      | Good                                                   | -                | -                                                                     |
 | 00000101.BIN | 2025-03-21 | On-Ground                                                                            | STAB           | 00:40 | OK                                  | OK                   | OK          | ESC0 slightly less                  | -                                                                                      | Good, 1-2 giving more                                  | -                | -                                                                     |
 | 00000102.BIN | 2025-03-21 | Takeoff, Landing                                                                     | STAB, POS      | 01:25 | OK                                  | OK                   | 2 Yaw Reset | ESC0 slightly less                  | Ground oscillations at the end                                                         | 1-2 giving way more on ground (around 28:30)           | -                | Check yaw at the beginning                                              |
 | 00000103.BIN | 2025-03-21 | On-Ground, No input                                                                  | GUIDED         | 02:00 | OK                                  | OK                   | OK          | Contactor Open                      | -                                                                                      | -                                                      | -                | Tried activating guided mode                                            |
 | 00000104.BIN | 2025-03-21 | On-Ground, No input                                                                  | POS            | 00:15 | OK                                  | OK                   | OK          | Contactor Open                      | -                                                                                      | -                                                      | -                | RC calibration?                                                         |
 | 00000105.BIN | 2025-03-22 | On-Ground, No input                                                                  | POS            | 00:15 | OK                                  | inside the workshop? | OK          | Contactor Open                      | -                                                                                      | -                                                      | -                | -                                                                     |
 | 00000106.BIN | 2025-03-22 | On-Ground                                                                            | STAB           | 01:00 | OK                                  | OK                   | OK          | ESC0 slightly less                  | Ground oscillations - no takeoff                                                       | Too much oscillation on ground                         | -                | -                                                                     |
 | 00000107.BIN | 2025-03-22 | Takeoff,  few maneuvers, Landing                                                     | STAB, POS      | 00:55 | OK                                  | OK                   | 2 Yaw Reset | ESC0 slightly less                  | A bit worse than others                                                                | 3-4 giving more                                        | -                | -                                                                     |
 | 00000108.BIN | 2025-03-22 | Takeoff, small maneuvers                                                             | ALT, POS       | 01:40 | OK                                  | OK                   | 2 Yaw Reset | ESC0 slightly less                  | A bit oscillatory                                                                      | Good                                                   | -                | Altitude changes in POS even though no throttle given                   |
 | 00000109.BIN | 2025-03-22 | Lateral and longitudinal movements, step inputs, yaw inputs                          | ALT, POS       | 03:10 | OK                                  | OK                   | 2 Yaw Reset | ESC0 slightly less                  | Good, check POS                                                                        | Good but check around 46:30                            | -                | -                                                                     |
 | 00000110.BIN | 2025-03-22 | On-Ground                                                                            | ALT, POS       | 00:30 | OK                                  | -                    | -           | No data                             | -                                                                                      | No data                                                | -                | It says armed but no battery data? Contractor probably open, armed how? |
 | 00000111.BIN | 2025-03-22 | Altitude changes in POS mode                                                         | ALT, POS       | 01:30 | OK                                  | OK                   | 1 Yaw Reset | ESC0 slightly less                  | A bit oscillatory                                                                      | Good but check around 09:36                            | -                | Route was like a big circle but very little pilot input. Check          |
 | 00000112.BIN | 2025-03-22 | Takeoff, very small maneuvers, altitude change, land                                 | ALT, POS       | 01:20 | Slightly higher at landing but safe | OK                   | 2 Yaw Reset | OK, too much oscillation at landing | A bit oscillatory                                                                      | Good                                                   | -                | Too much vibration at landing                                           |
 | 00000113.BIN | 2025-03-22 | Takeoff and landing in POS mode                                                      | POS            | 00:50 | OK                                  | OK                   | 2 Yaw Reset | ESC0 slightly less                  | Pitch twitches, roll better                                                            | Good                                                   | -                | -                                                                     |
 | 00000114.BIN | 2025-03-22 | Takeoff and landing in AUTO mode                                                     | POS, AUTO      | 00:50 | OK                                  | OK                   | 1 Yaw Reset | ESC0 slightly less                  | Worse than POS                                                                         | Good but twitches at landing                           | -              | -                                                                     |
 | 00000115.BIN | 2025-03-22 | Takeoff and land in POS mode, roll step                                              | POS            | 00:45 | OK                                  | OK                   | 1 Yaw Reset | ESC0 slightly less                  | Better but still needs tuning                                                          | Good                                                   | -              | -                                                                     |
 | 00000116.BIN | 2025-03-22 | Waypoint tracking with AUTO mode (line)                                              | POS, AUTO      | 01:15 | OK                                  | OK                   | 1 Yaw Reset | ESC0 slightly less                  | Better than 114, still needs checking                                                  | Good but twitches at landing                           | -              | -                                                                     |
 | 00000117.BIN | 2025-03-22 | Waypoint tracking with AUTO mode (triangle)                                          | POS, AUTO      | 01:30 | OK                                  | OK                   | 2 Yaw Reset | ESC0 slightly less                  | Similar to 116                                                                         | 1 giving less after some point, check attitudes        | -              | -                                                                     |
 | 00000118.BIN | 2025-03-22 | On-Ground, No input                                                                  | POS            | 00:20 | OK                                  | OK                   | -           | ESC0 slightly less                  | -                                                                                      | -                                                      | -              | -                                                                     |
 | 00000119.BIN | 2025-03-22 | On-Ground, No input                                                                  | POS            | 00:30 | OK                                  | OK                   | -           | ESC0 slightly less                  | -                                                                                      | -                                                      | -              | -                                                                     |
 | 00000120.BIN | 2025-03-22 | 10 m altitude test in AUTO mode                                                      | POS, AUTO      | 00:40 | OK                                  | OK                   | 1 Yaw Reset | ESC0 slightly less                  | Twitches                                                                               | 1-2 giving less but attitude is also positive          | -              | Possible wind, positive roll and pitch                                  |
 | 00000121.BIN | 2025-03-22 | 10 m altitude test in AUTO mode                                                      | POS, AUTO      | 00:30 | OK                                  | OK                   | 2 Yaw Reset | ESC0 slightly less                  | Worse than 120                                                                         | 1-2 giving less, small yaw divergence. Landing twitchy | -              | Possible wind, positive roll and pitch                                  |
 | 00000122.BIN | 2025-03-22 | 10 m altitude test in AUTO mode                                                      | POS, AUTO      | 00:30 | OK                                  | OK                   | 2 Yaw Reset | ESC0 slightly less                  | Needs tuning                                                                           | 1-2 giving less, small yaw divergence. Landing twitchy | -              | Possible wind, positive roll and pitch                                  |
 | 00000123.BIN | 2025-03-22 | 10 m altitude test in AUTO mode                                                      | POS, AUTO      | 00:25 | OK                                  | OK                   | 1 Yaw Reset | ESC0 slightly less                  | Worse in pitch and roll, faster in climb rate                                          | 1-2 giving less, small yaw divergence. Landing twitchy | -              | Possible wind, positive roll and pitch                                  |
 | 00000124.BIN | 2025-03-22 | 10 m altitude test in AUTO mode, stays longer at 10 m                                | POS, AUTO      | 00:35 | OK                                  | OK                   | 1 Yaw Reset | ESC0 slightly less                  | Similar to 123                                                                         | 1-2 giving less, small yaw divergence. Landing twitchy | -              | Possible wind, positive roll and pitch                                  |
 | 00000125.BIN | 2025-03-22 | 10 m altitude test in AUTO mode                                                      | POS, AUTO      | 00:30 | OK                                  | OK                   | 1 Yaw Reset | ESC0 slightly less                  | Less twitchy but not following too well                                                | 1-2 giving less, small yaw divergence. Landing twitchy | -              | -                                                                     |
 | 00000126.BIN | 2025-03-22 | 10 m altitude test in AUTO mode                                                      | POS, AUTO      | 00:30 | OK, a bit higher than others        | OK                   | 1 Yaw Reset | ESC0 slightly less                  | Still slow                                                                             | 1-2 giving less, small yaw divergence. Landing twitchy | -              | -                                                                     |
 | 00000127.BIN | 2025-03-22 | Takeoff and reach 10m in AUTO, descend and land in POS mode                          | POS, AUTO      | 01:00 | OK                                  | OK                   | 1 Yaw Reset | ESC0 slightly less                  | Overshoots in AUTO, POS slightly better than AUTO                                      | Good, landing less twitchy                             | -              | -                                                                     |
 | 00000128.BIN | 2025-03-22 | 10 m altitude test in AUTO mode                                                      | POS, AUTO      | 00:30 | OK                                  | OK                   | 1 Yaw Reset | ESC0 slightly less                  | Oscillatory behavior                                                                   | Landing twitchy                                        | -              | -                                                                     |
 | 00000129.BIN | 2025-03-22 | Waypoint tracking with AUTO mode (square). In the last leg, POS activated for return | POS, AUTO      | 01:00 | OK                                  | OK                   | 1 Yaw Reset | ESC0 slightly less                  | Angle tracking is the best in all AUTO flights. POS is also better.                    | Good, landing is great                                 | -              | Best test, check gains                                                  |
 | 00000130.BIN | 2025-03-22 | Waypoint tracking with AUTO mode (zigzag with elevation change)                      | AUTO           | 02:00 | OK                                  | OK                   | 1 Yaw Reset | ESC0 slightly less                  | Angle tracking is good, less altitude drop during deceleration. Landing is a bit fast. | Hit the limits yaw turns. Investigate.                 | -              | -                                                                     |
