Julius-eng/project-quiver-05032025/docs/pt3-assembly-guides/harnessing-guide/assets/Wire Data - BC_PCB.pdf

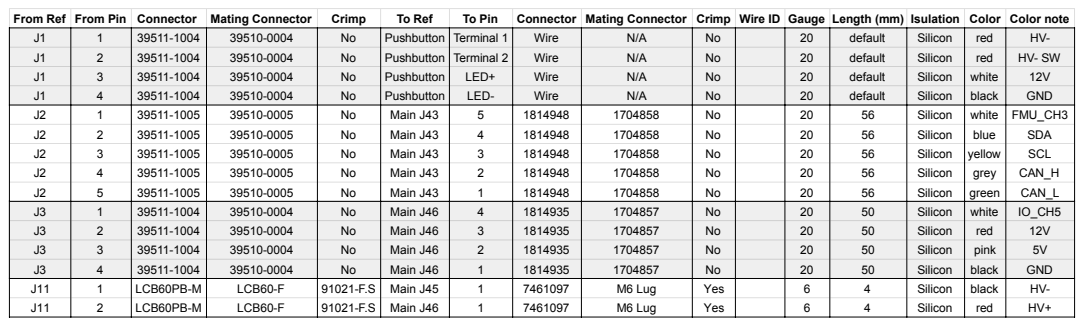
[picture p300: page 1]
From Ref From Pin Connector; Mating Connector; Crimp; To Ref; To Pin; Connector Mating Connector Crimp Wire ID Gauge Length (mm) Isulation Color Color note

J1 J1 | 1 2 3 4 | 39511-1004 39511-1004 | 39510-0004 39510-0004 | No No | Pushbutton Pushbutton | Terminal 1 Terminal 2 LED+ LED- | Wire Wire | N/A N/A | No No | 20 20 | default default | Silicon Silicon | red red white black | HV-HV- SW 12V GND

J2 J2 J2 J2 J2 | 1 2 3 4 5 | 39511-1005 39511-1005 39511-1005 39511-1005 39511-1005 | 39510-0005 39510-0005 39510-0005 39510-0005 39510-0005 | No No No No No | Main J43 Main J43 Main J43 Main J43 Main J43 | 5 4 3 2 1 | 1814948 1814948 1814948 1814948 1814948 | 1704858 1704858 1704858 1704858 1704858 | No No No No No | 20 20 20 20 20 | 56 56 56 56 56 | Silicon Silicon Silicon Silicon Silicon | white blue yellow grey green | FMU_CH3 SDA SCL CAN_H CAN_L

J3 J3 | 1 2 3 4 | 39511-1004 39511-1004 | 39510-0004 39510-0004 | No No | Main J46 Main J46 | 4 3 2 1 | 1814935 1814935 | 1704857 1704857 | No No | 20 20 | 50 50 | Silicon Silicon | white red pink black | IO_CH5 12V 5V GND

J11 | 1 2 | LCB60PB-M | LCB60-F | 91021-F.S | Main J45 Main J46 | 1 1 | 7461097 | M6 Lug | Yes | 6 6 | 4 4 | Silicon | black red | HV-HV+
