Julius-eng/project-quiver-05032025/task-grant-bounty/pt1/electronics/0001-PDB_V1/project-data/BOM/Quiver_PDB_01 - BOM_Quiver_PDB_V1.pdf

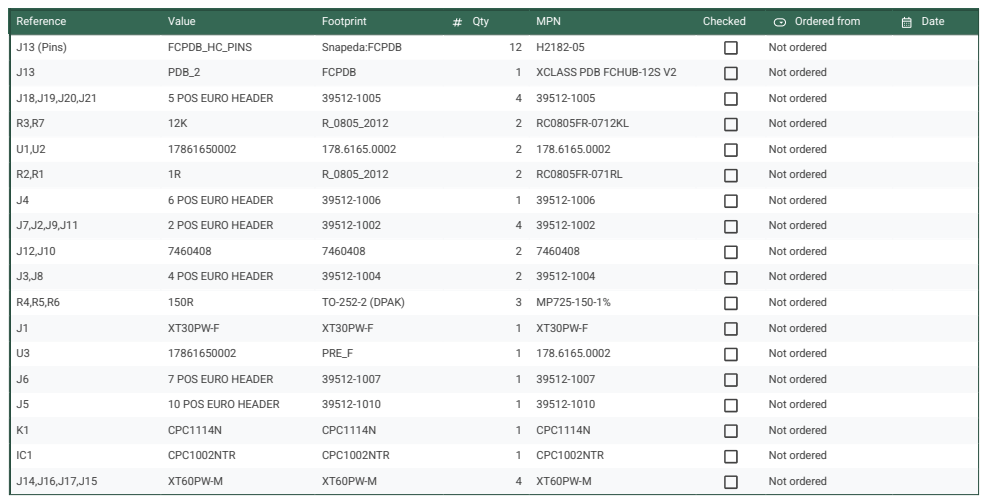
[picture p301: page 1]

Reference | Value | Footprint | Qty | MPN | Checked | Ordered from | Date

J13 (Pins) | FCPDB_HC_PINS | Snapeda:FCPDB | 12 | H2182-05 | | Not ordered

J13 | PDB_2 | FCPDB | 1 | XCLASS PDB FCHUB-12S V2 | | Not ordered

J18,J19,J20,J21 | 5 POS EURO HEADER | 39512-1005 | 4 | 39512-1005 | | Not ordered

R3,R7 | 12K | R_0805_2012 | 2 | RC0805FR-0712KL | | Not ordered

U1,U2 | 17861650002 | 178.6165.0002 | 2 | 178.6165.0002 | | Not ordered

R2,R1 | 1R | R_0805_2012 | 2 | RC0805FR-071RL | | Not ordered

J4 | 6 POS EURO HEADER | 39512-1006 | 1 | 39512-1006 | | Not ordered

J7,J2,J9,J11 | 2 POS EURO HEADER | 39512-1002 | 4 | 39512-1002 | | Not ordered

J12,J10 | 7460408 | 7460408 | 2 | 7460408 | | Not ordered

J3,J8 | 4 POS EURO HEADER | 39512-1004 | 2 | 39512-1004 | | Not ordered

R4,R5,R6 | 150R | TO-252-2 (DPAK) | 3 | MP725-150-1% | | Not ordered

J1 | XT30PW-F | XT30PW-F | 1 | XT30PW-F | | Not ordered

U3 | 17861650002 | PRE_F | 1 | 178.6165.0002 | | Not ordered

J6 | 7 POS EURO HEADER | 39512-1007 | 1 | 39512-1007 | | Not ordered

J5 | 10 POS EURO HEADER | 39512-1010 | 1 | 39512-1010 | | Not ordered

K1 | CPC1114N | CPC1114N | 1 | CPC1114N | | Not ordered

IC1 | CPC1002NTR | CPC1002NTR | 1 | CPC1002NTR | | Not ordered

J14,J16,J17,J15 | XT60PW-M | XT60PW-M | 4 | XT60PW-M | | Not ordered
