Julius-eng/project-quiver-05032025/task-grant-bounty/pt3/electronics/0002-Battery-PCB/KiCAD-Files/Front_PCB.kicad_pcb

## KiCad design task-grant-bounty/pt3/electronics/0002-Battery-PCB/KiCAD-Files/Front_PCB.kicad_pcb (2025-11-04)

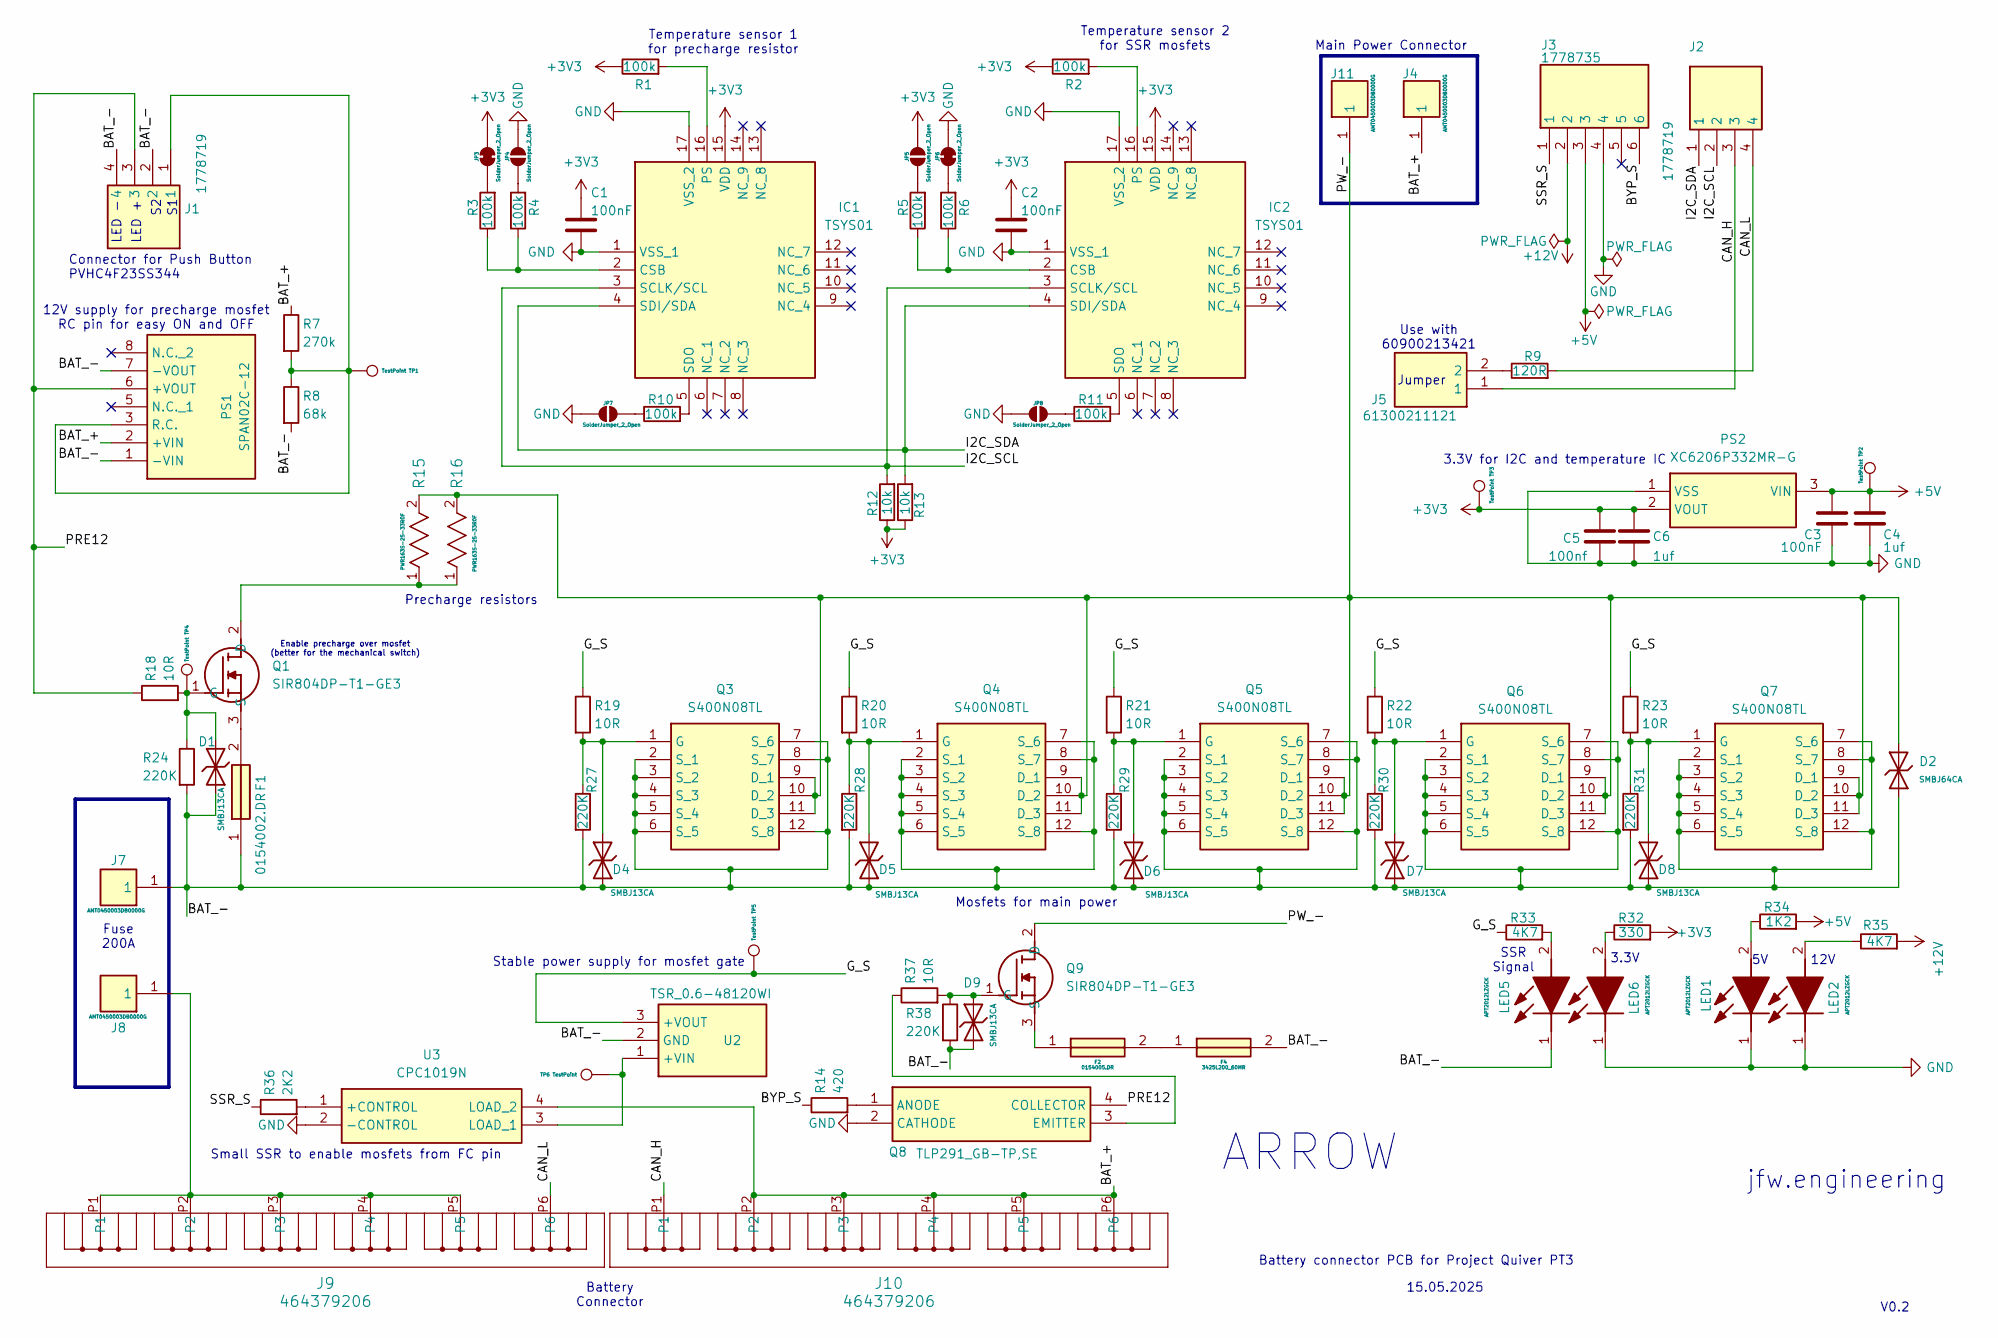
[picture p302: schematic Front_PCB.kicad_sch]

Parts:
C1, C2, C3: 100nF; C_0805_2012Metric_Pad1.18x1.45mm_HandSolder
C4, C6: 1uf; C_0805_2012Metric_Pad1.18x1.45mm_HandSolder
C5: 100nf; C_0805_2012Metric_Pad1.18x1.45mm_HandSolder
D1, D4, D5, D6, D7, D8, D9: SMBJ13CA; D_SMB; Part SMBJ13CA; LCSC C19077568
D2: SMBJ64CA; D_SMB; Breakdown Voltage 78.6V; Part SMBJ64CA; LCSC C41376099
F1: 0154002.DR; 0154002DR; Mouser Part Number 576-0154002.DR
F2: 0154005.DR; 0154005DR; Mouser Part Number 576-0154005.DR
F4: 3425L200_60MR; FUSC8664X180N; Mouser Part Number 576-3425L200/60MR
IC1, IC2: TSYS01; QFN65P400X400X90-17N; Mouser Part Number 824-TSYS01
J1, J2: 1778719; Mouser Part Number 651-1778719
J3: 1778735; Mouser Part Number 651-1778735
J4, J7, J8, J11: AMT0450003DB0000G; Mouser Part Number 523-AMT0450003DB000G
J5: 61300211121; HDRV2W110P0X254_1X2_508X254X854P; Mouser Part Number 710-61300211121
J9, J10: 464379206; CONN_SD-46437-9000_06_MOL
JP3, JP6: SolderJumper_2_Open; SolderJumper-2_P1.3mm_Bridged2Bar_RoundedPad1.0x1.5mm
JP4, JP5, JP7, JP8: SolderJumper_2_Open; SolderJumper-2_P1.3mm_Open_RoundedPad1.0x1.5mm
LED1, LED2, LED5, LED6: APT2012LZGCK; LEDC2012X85N; Mouser Part Number 604-APT2012LZGCK
PS1: SPAN02C-12; SPAN02C12; Mouser Part Number 709-SPAN02C-12
PS2: XC6206P332MR-G; SOT95P280X130-3N; Mouser Part Number 865-XC6206P332MR-G
Q1, Q9: SIR804DP-T1-GE3; SIR804DPT1GE3; Mouser Part Number 781-SIR804DP-T1-GE3
Q3, Q4, Q5, Q6, Q7: S400N08TL; IAUT150N10S5N035ATMA1; Mouser Part Number 726-IPT017N12NM6ATMA
Q8: TLP291_GB-TP,SE; SOIC127P700X230-4N; Mouser Part Number 757-TLP291GB-TPSE
R1, R2, R3, R4, R5, R6, R10, R11: 100k; R_0805_2012Metric_Pad1.20x1.40mm_HandSolder
R7: 270k; R_0805_2012Metric_Pad1.20x1.40mm_HandSolder
R8: 68k; R_0805_2012Metric_Pad1.20x1.40mm_HandSolder
R9: 120R; R_0805_2012Metric_Pad1.20x1.40mm_HandSolder
R12, R13: 10k; R_0805_2012Metric_Pad1.20x1.40mm_HandSolder
R14: 420; R_0805_2012Metric_Pad1.20x1.40mm_HandSolder
R15, R16: PWR163S-25-33R0F; RES_PWR163_BRN; PARTREV 0716
R18, R19, R20, R21, R22, R23, R37: 10R; R_0805_2012Metric_Pad1.20x1.40mm_HandSolder
R24, R27, R28, R29, R30, R31, R38: 220K; R_0805_2012Metric_Pad1.20x1.40mm_HandSolder
R32: 330; R_0805_2012Metric_Pad1.20x1.40mm_HandSolder
R33, R35: 4K7; R_0805_2012Metric_Pad1.20x1.40mm_HandSolder
R34: 1K2; R_0805_2012Metric_Pad1.20x1.40mm_HandSolder
R36: 2K2; R_0805_2012Metric_Pad1.20x1.40mm_HandSolder
TP1, TP2, TP3, TP4, TP5, TP6: TestPoint; TestPoint_Pad_D1.5mm
U2: TSR_0.6-48120WI; TSR0648120WI; Mouser Part Number 495-TSR0.6-48120WI
U3: CPC1019N; SOP254P610X218-4N; Mouser Part Number 849-CPC1019N

Connections:
+3V3: C1.1, C2.1, C5.1, C6.1, IC1.15 (VDD), IC2.15 (VDD), JP3.2 (B), JP5.2 (B), PS2.2 (VOUT), R1.1, R2.1, R12.1, R13.1, R32.2, TP3.1
+5V: C3.1, C4.1, J3.3, PS2.3 (VIN), R34.2, TP2.1
+12V: J3.2, R35.2
/BAT_+: J4.1, J10.P2, J10.P3, J10.P4, J10.P5, J10.P6, PS1.2 (+VIN), R7.1, U3.4 (LOAD_2)
/BAT_-: D1.1, D2.1, D4.1, D5.1, D6.1, D7.1, D8.1, D9.1, F1.1, F4.2, J1.2, J1.4, J7.1, LED5.1 (K), PS1.1 (-VIN), PS1.7 (-VOUT), Q3.2 (S_1), Q3.3 (S_2), Q3.4 (S_3), Q3.5 (S_4), Q3.6 (S_5), Q3.7 (S_6), Q3.8 (S_7), Q3.12 (S_8), Q4.2 (S_1), Q4.3 (S_2), Q4.4 (S_3), Q4.5 (S_4), Q4.6 (S_5), Q4.7 (S_6), Q4.8 (S_7), Q4.12 (S_8), Q5.2 (S_1), Q5.3 (S_2), Q5.4 (S_3), Q5.5 (S_4), Q5.6 (S_5), Q5.7 (S_6), Q5.8 (S_7), Q5.12 (S_8), Q6.2 (S_1), Q6.3 (S_2), Q6.4 (S_3), Q6.5 (S_4), Q6.6 (S_5), Q6.7 (S_6), Q6.8 (S_7), Q6.12 (S_8), Q7.2 (S_1), Q7.3 (S_2), Q7.4 (S_3), Q7.5 (S_4), Q7.6 (S_5), Q7.7 (S_6), Q7.8 (S_7), Q7.12 (S_8), R8.2, R24.2, R27.2, R28.2, R29.2, R30.2, R31.2, R38.2, U2.2 (GND)
/BYP_S: J3.6, R14.1
/CAN_H: J2.3, J5.1, J10.P1
/CAN_L: J2.4, J9.P6, R9.2
/G_S: R19.1, R20.1, R21.1, R22.1, R23.1, R33.1, TP5.1, U2.3 (+VOUT)
/I2C_SCL: IC1.3 (SCLK/SCL), IC2.3 (SCLK/SCL), J2.2, R12.2
/I2C_SDA: IC1.4 (SDI/SDA), IC2.4 (SDI/SDA), J2.1, R13.2
/PRE12: J1.3, PS1.6 (+VOUT), Q8.4 (COLLECTOR), R18.1
/PW_-: D2.2, J11.1, Q3.9 (D_1), Q3.10 (D_2), Q3.11 (D_3), Q4.9 (D_1), Q4.10 (D_2), Q4.11 (D_3), Q5.9 (D_1), Q5.10 (D_2), Q5.11 (D_3), Q6.9 (D_1), Q6.10 (D_2), Q6.11 (D_3), Q7.9 (D_1), Q7.10 (D_2), Q7.11 (D_3), Q9.2 (D), R15.2, R16.2
/SSR_S: J3.1, R36.1
GND: C1.2, C2.2, C3.2, C4.2, C5.2, C6.2, IC1.1 (VSS_1), IC1.17 (VSS_2), IC2.1 (VSS_1), IC2.17 (VSS_2), J3.4, JP4.2 (B), JP6.2 (B), JP7.1 (A), JP8.1 (A), LED1.1 (K), LED2.1 (K), LED6.1 (K), PS2.1 (VSS), Q8.2 (CATHODE), U3.2 (-CONTROL)
unnamed: F2.2, F4.1
unnamed: IC1.2 (CSB), R3.1, R4.1
unnamed: IC1.16 (PS), R1.2
unnamed: IC1.5 (SDO), R10.2
unnamed: IC2.2 (CSB), R5.1, R6.1
unnamed: IC2.16 (PS), R2.2
unnamed: IC2.5 (SDO), R11.2
unnamed: J5.2, R9.1
unnamed: J8.1, J9.P1, J9.P2, J9.P3, J9.P4, J9.P5
unnamed: JP3.1 (A), R3.2
unnamed: JP4.1 (A), R4.2
unnamed: JP5.1 (A), R5.2
unnamed: JP6.1 (A), R6.2
unnamed: JP7.2 (B), R10.1
unnamed: JP8.2 (B), R11.1
unnamed: LED1.2 (A), R34.1
unnamed: LED2.2 (A), R35.1
unnamed: LED5.2 (A), R33.2
unnamed: LED6.2 (A), R32.1
unnamed: J1.1, PS1.3 (R.C.), R7.2, R8.1, TP1.1
unnamed: Q1.2 (D), R15.1, R16.1
unnamed: D1.2, Q1.1 (G), R18.2, R24.1, TP4.1
unnamed: F1.2, Q1.3 (S)
unnamed: D4.2, Q3.1 (G), R19.2, R27.1
unnamed: D5.2, Q4.1 (G), R20.2, R28.1
unnamed: D6.2, Q5.1 (G), R21.2, R29.1
unnamed: D7.2, Q6.1 (G), R22.2, R30.1
unnamed: D8.2, Q7.1 (G), R23.2, R31.1
unnamed: Q8.1 (ANODE), R14.2
unnamed: Q8.3 (EMITTER), R37.1
unnamed: D9.2, Q9.1 (G), R37.2, R38.1
unnamed: F2.1, Q9.3 (S)
unnamed: TP6.1, U2.1 (+VIN), U3.3 (LOAD_1)
unnamed: R36.2, U3.1 (+CONTROL)

Notes on the sheet:
15.05.2025
Connector for Push Button PVHC4F23SS344
Battery connector PCB for Project Quiver PT3
SSR Signal
3.3V
12V supply for precharge mosfet RC pin for easy ON and OFF
Use with 60900213421
12V
Battery Connector
ARROW
Temperature sensor 1 for precharge resistor
Small SSR to enable mosfets from FC pin
3.3V for I2C and temperature IC
Jumper
Mosfets for main power
LED -
Stable power supply for mosfet gate
V0.2
jfw.engineering
Temperature sensor 2 for SSR mosfets
Enable precharge over mosfet (better for the mechanical switch)
LED +
Main Power Connector
Fuse 200A
Precharge resistors

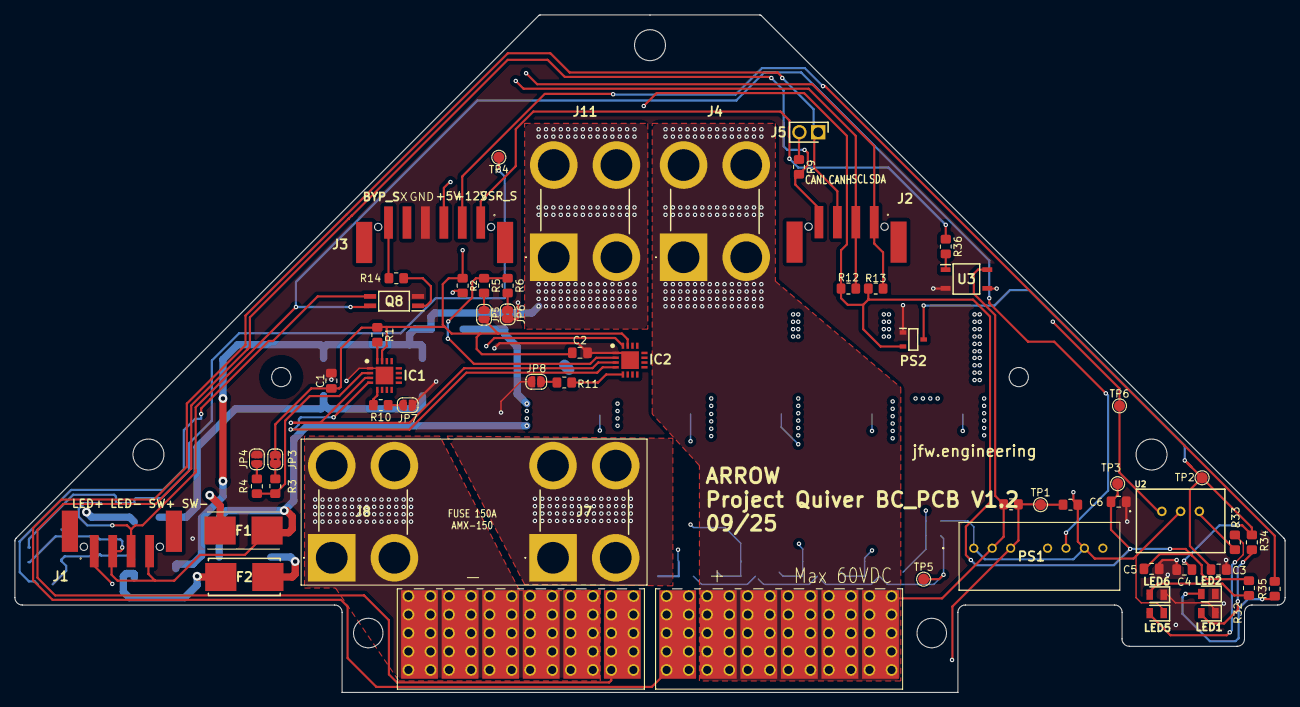
[picture p303: board Front_PCB.kicad_pcb from above]

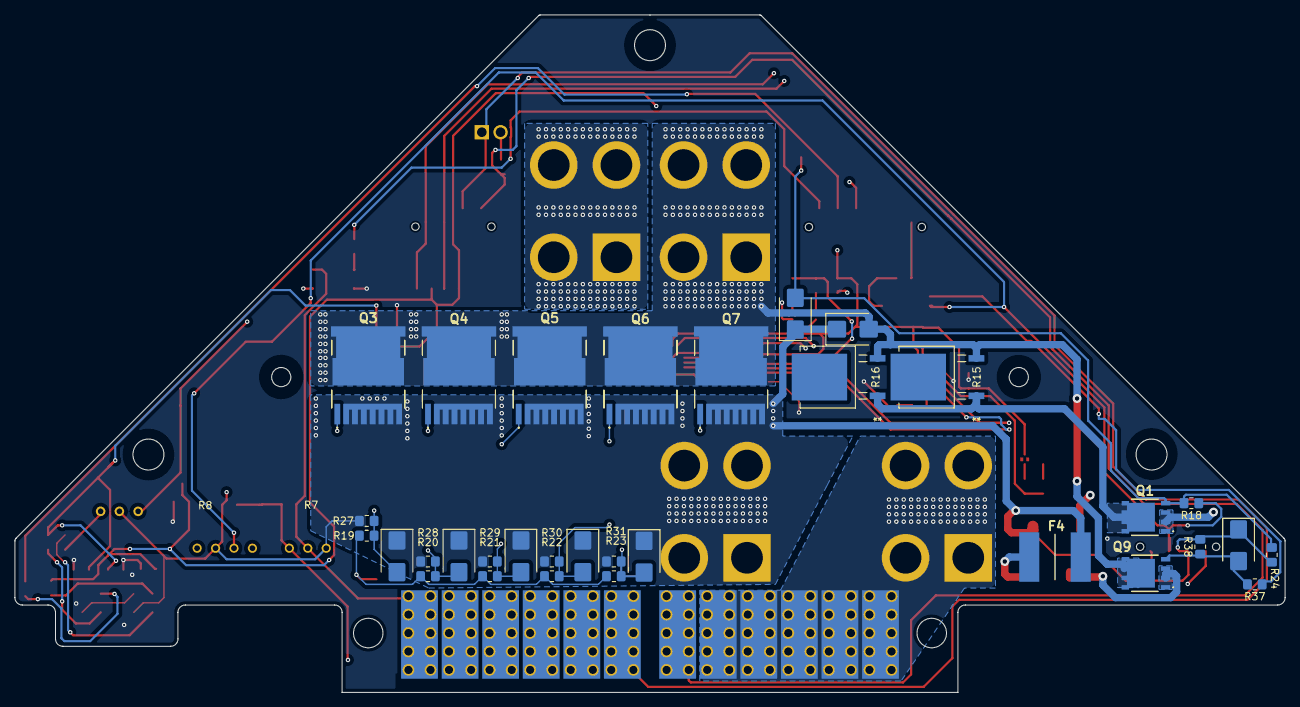
[picture p304: board Front_PCB.kicad_pcb from below]

Board: 4 copper layers, 172.2 x 91.8 mm, 92 parts (32 on the bottom side), 49 nets.
