Julius-eng/project-quiver-05032025/task-grant-bounty/pt3/electronics/0008-FC-PCB/KiCAD-Files/Quiver_PT3_FC_PCB.kicad_pcb

## KiCad design task-grant-bounty/pt3/electronics/0008-FC-PCB/KiCAD-Files/Quiver_PT3_FC_PCB.kicad_pcb (2025-11-04)

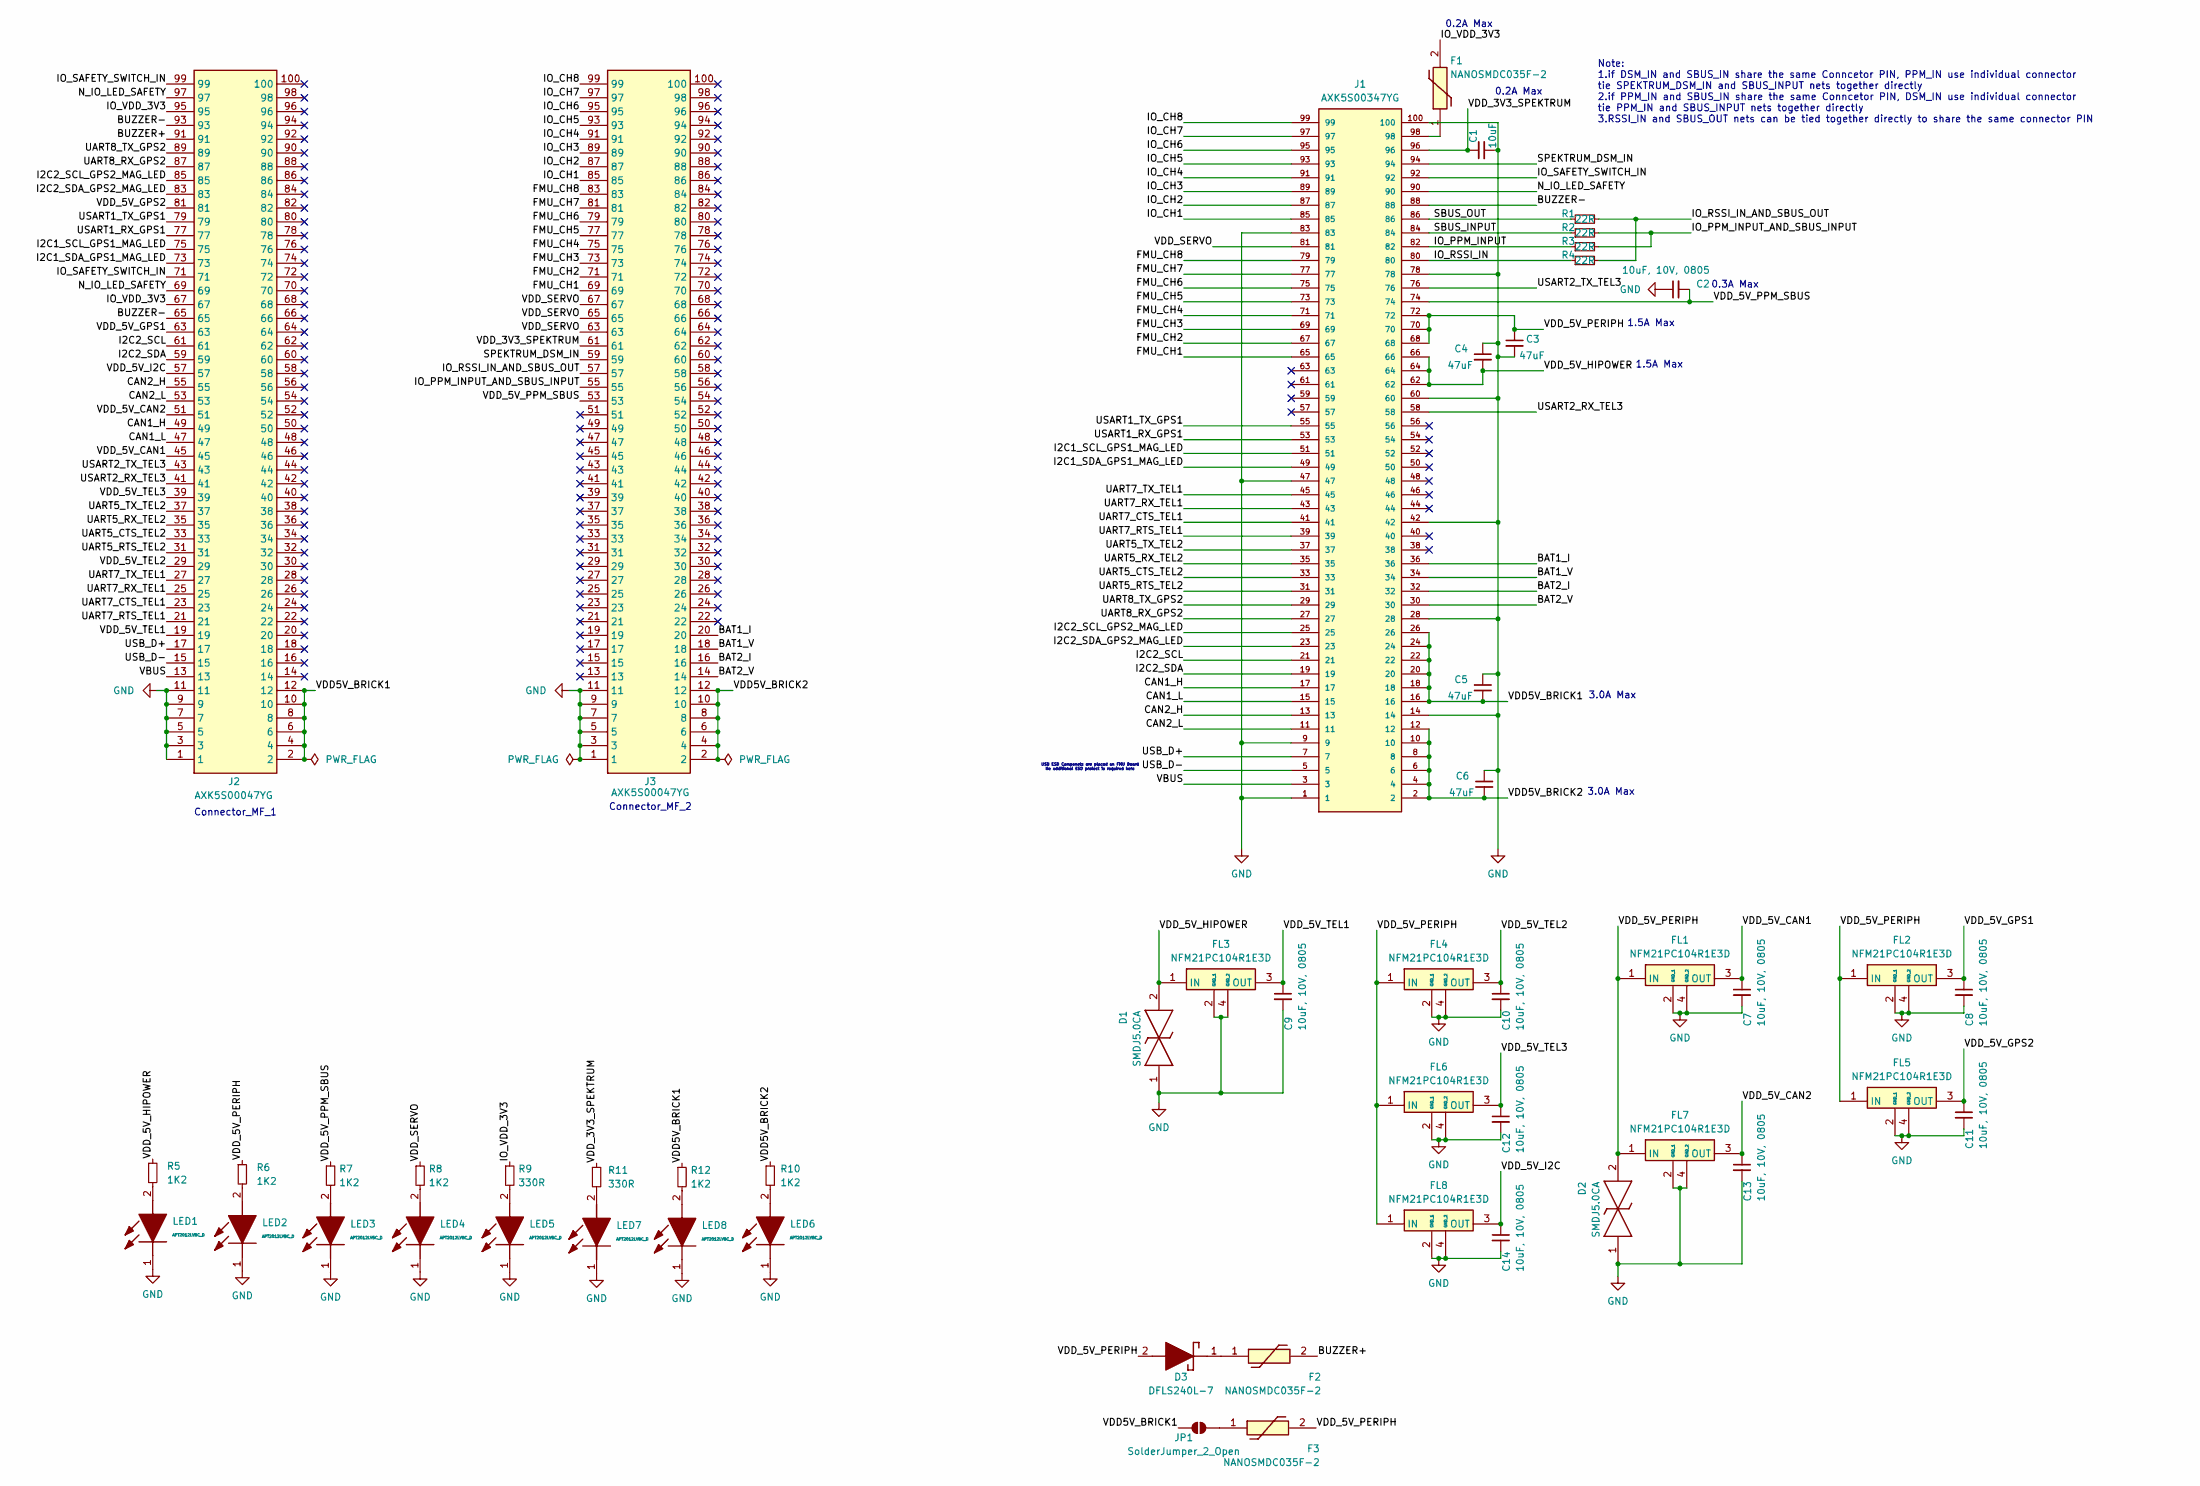
[picture p305: schematic Quiver_PT3_FC_PCB.kicad_sch]

Parts:
C1: 10uF; C_0805_2012Metric_Pad1.18x1.45mm_HandSolder
C2, C7, C8, C9, C10, C11, C12, C13, C14: 10uF, 10V, 0805; C_0805_2012Metric_Pad1.18x1.45mm_HandSolder
C3, C4, C5, C6: 47uF; C_0805_2012Metric_Pad1.18x1.45mm_HandSolder
D1, D2: SMDJ5.0CA; DIONM7959X262N; Mouser Part Number 576-SMDJ5.0CA
D3: DFLS240L-7; DFLS240L7; Mouser Part Number 621-DFLS240L-7
F1, F2, F3: NANOSMDC035F-2; NANOSMDC016F2; Mouser Part Number 650-NANOSMDC035F-2
FL1, FL2, FL3, FL4, FL5, FL6, FL7, FL8: NFM21PC104R1E3D; Mouser Part Number 81-NFM21PC104R1E3D
J1: AXK5S00347YG; AXK5S00347YG_AXK5S00347YG; MANUFACTURER_PART_NUMBER AXK5S00347YG
J2, J3: AXK5S00047YG; Mouser Part Number AXK5S00047YG
JP1: SolderJumper_2_Open; SolderJumper-2_P1.3mm_Open_RoundedPad1.0x1.5mm
LED1, LED2, LED3, LED4, LED5, LED6, LED7, LED8: APT2012LVBC_D; LEDC2012X85N; Mouser Part Number 604-APT2012LVBCD
R1, R2, R3, R4: 22R; R_0805_2012Metric_Pad1.20x1.40mm_HandSolder
R5, R6, R7, R8, R10, R12: 1K2; R_0805_2012Metric_Pad1.20x1.40mm_HandSolder
R9, R11: 330R; R_0805_2012Metric_Pad1.20x1.40mm_HandSolder

Connections:
/ I2C2_SDA_GPS2_MAG_LED: J1.23, J2.83
/BAT1_I: J1.36, J3.20
/BAT1_V: J1.34, J3.18
/BAT2_I: J1.32, J3.16
/BAT2_V: J1.30, J3.14
/BUZZER+: F2.2, J2.91
/BUZZER-: J1.88, J2.65, J2.93
/CAN1_H: J1.17, J2.49
/CAN1_L: J1.15, J2.47
/CAN2_H: J1.13, J2.55
/CAN2_L: J1.11, J2.53
/FMU_CH1: J1.65, J3.69
/FMU_CH2: J1.67, J3.71
/FMU_CH3: J1.69, J3.73
/FMU_CH4: J1.71, J3.75
/FMU_CH5: J1.73, J3.77
/FMU_CH6: J1.75, J3.79
/FMU_CH7: J1.77, J3.81
/FMU_CH8: J1.79, J3.83
/I2C1_SCL_GPS1_MAG_LED: J1.51, J2.75
/I2C1_SDA_GPS1_MAG_LED: J1.49, J2.73
/I2C2_SCL: J1.21, J2.61
/I2C2_SCL_GPS2_MAG_LED: J1.25, J2.85
/I2C2_SDA: J1.19, J2.59
/IO_CH1: J1.85, J3.85
/IO_CH2: J1.87, J3.87
/IO_CH3: J1.89, J3.89
/IO_CH4: J1.91, J3.91
/IO_CH5: J1.93, J3.93
/IO_CH6: J1.95, J3.95
/IO_CH7: J1.97, J3.97
/IO_CH8: J1.99, J3.99
/IO_PPM_INPUT: J1.82, R3.1
/IO_PPM_INPUT_AND_SBUS_INPUT: J3.55, R2.2, R3.2
/IO_RSSI_IN: J1.80, R4.1
/IO_RSSI_IN_AND_SBUS_OUT: J3.57, R1.2, R4.2
/IO_SAFETY_SWITCH_IN: J1.92, J2.71, J2.99
/IO_VDD_3V3: F1.2, J2.67, J2.95, R9.1
/N_IO_LED_SAFETY: J1.90, J2.69, J2.97
/SBUS_INPUT: J1.84, R2.1
/SBUS_OUT: J1.86, R1.1
/SPEKTRUM_DSM_IN: J1.94, J3.59
/UART5_CTS_TEL2: J1.33, J2.33
/UART5_RTS_TEL2: J1.31, J2.31
/UART5_RX_TEL2: J1.35, J2.35
/UART5_TX_TEL2: J1.37, J2.37
/UART7_CTS_TEL1: J1.41, J2.23
/UART7_RTS_TEL1: J1.39, J2.21
/UART7_RX_TEL1: J1.43, J2.25
/UART7_TX_TEL1: J1.45, J2.27
/UART8_RX_GPS2: J1.27, J2.87
/UART8_TX_GPS2: J1.29, J2.89
/USART1_RX_GPS1: J1.53, J2.77
/USART1_TX_GPS1: J1.55, J2.79
/USART2_RX_TEL3: J1.58, J2.41
/USART2_TX_TEL3: J1.76, J2.43
/USB_D+: J1.7, J2.17
/USB_D-: J1.5, J2.15
/VBUS: J1.3, J2.13
/VDD5V_BRICK1: C5.2, J1.16, J1.18, J1.20, J1.22, J1.24, J1.26, J2.2, J2.4, J2.6, J2.8, J2.10, J2.12, JP1.1 (A), R12.1
/VDD5V_BRICK2: C6.2, J1.2, J1.4, J1.6, J1.8, J1.10, J1.12, J3.2, J3.4, J3.6, J3.8, J3.10, J3.12, R10.1
/VDD_3V3_SPEKTRUM: C1.1, J1.96, J3.61, R11.1
/VDD_5V_CAN1: C7.1, FL1.3 (OUT), J2.45
/VDD_5V_CAN2: C13.1, FL7.3 (OUT), J2.51
/VDD_5V_GPS1: C8.1, FL2.3 (OUT), J2.63
/VDD_5V_GPS2: C11.1, FL5.3 (OUT), J2.81
/VDD_5V_HIPOWER: C4.2, D1.2, FL3.1 (IN), J1.62, J1.64, J1.66, R5.1
/VDD_5V_I2C: C14.1, FL8.3 (OUT), J2.57
/VDD_5V_PERIPH: C3.1, D2.2, D3.2 (A), F3.2, FL1.1 (IN), FL2.1 (IN), FL4.1 (IN), FL5.1 (IN), FL6.1 (IN), FL7.1 (IN), FL8.1 (IN), J1.68, J1.70, J1.72, R6.1
/VDD_5V_PPM_SBUS: C2.2, J1.74, J3.53, R7.1
/VDD_5V_TEL1: C9.1, FL3.3 (OUT), J2.19
/VDD_5V_TEL2: C10.1, FL4.3 (OUT), J2.29
/VDD_5V_TEL3: C12.1, FL6.3 (OUT), J2.39
/VDD_SERVO: J1.81, J3.63, J3.65, J3.67, R8.1
GND: C1.2, C2.1, C3.2, C4.1, C5.1, C6.1, C7.2, C8.2, C9.2, C10.2, C11.2, C12.2, C13.2, C14.2, D1.1, D2.1, FL1.2 (GND_1), FL1.4 (GND_2), FL2.2 (GND_1), FL2.4 (GND_2), FL3.2 (GND_1), FL3.4 (GND_2), FL4.2 (GND_1), FL4.4 (GND_2), FL5.2 (GND_1), FL5.4 (GND_2), FL6.2 (GND_1), FL6.4 (GND_2), FL7.2 (GND_1), FL7.4 (GND_2), FL8.2 (GND_1), FL8.4 (GND_2), J1.1, J1.9, J1.14, J1.28, J1.42, J1.47, J1.60, J1.78, J1.83, J1.100, J2.1, J2.3, J2.5, J2.7, J2.9, J2.11, J3.1, J3.3, J3.5, J3.7, J3.9, J3.11, LED1.1 (K), LED2.1 (K), LED3.1 (K), LED4.1 (K), LED5.1 (K), LED6.1 (K), LED7.1 (K), LED8.1 (K)
unnamed: D3.1 (K), F2.1
unnamed: F1.1, J1.98
unnamed: F3.1, JP1.2 (B)
unnamed: LED1.2 (A), R5.2
unnamed: LED2.2 (A), R6.2
unnamed: LED3.2 (A), R7.2
unnamed: LED4.2 (A), R8.2
unnamed: LED5.2 (A), R9.2
unnamed: LED6.2 (A), R10.2
unnamed: LED7.2 (A), R11.2
unnamed: LED8.2 (A), R12.2

Notes on the sheet:
3.0A Max
0.2A Max
0.3A Max
1.5A Max
Connector_MF_2
USB ESD Componets are placed on FMU Board No additional ESD protect is required here
Connector_MF_1
Note: 1.if DSM_IN and SBUS_IN share the same Conncetor PIN, PPM_IN use individual connector tie SPEKTRUM_DSM_IN and SBUS_INPUT nets together directly 2.if PPM_IN and SBUS_IN share the same Conncetor PIN, DSM_IN use individual connector tie PPM_IN and SBUS_INPUT nets together directly 3.RSSI_IN and 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

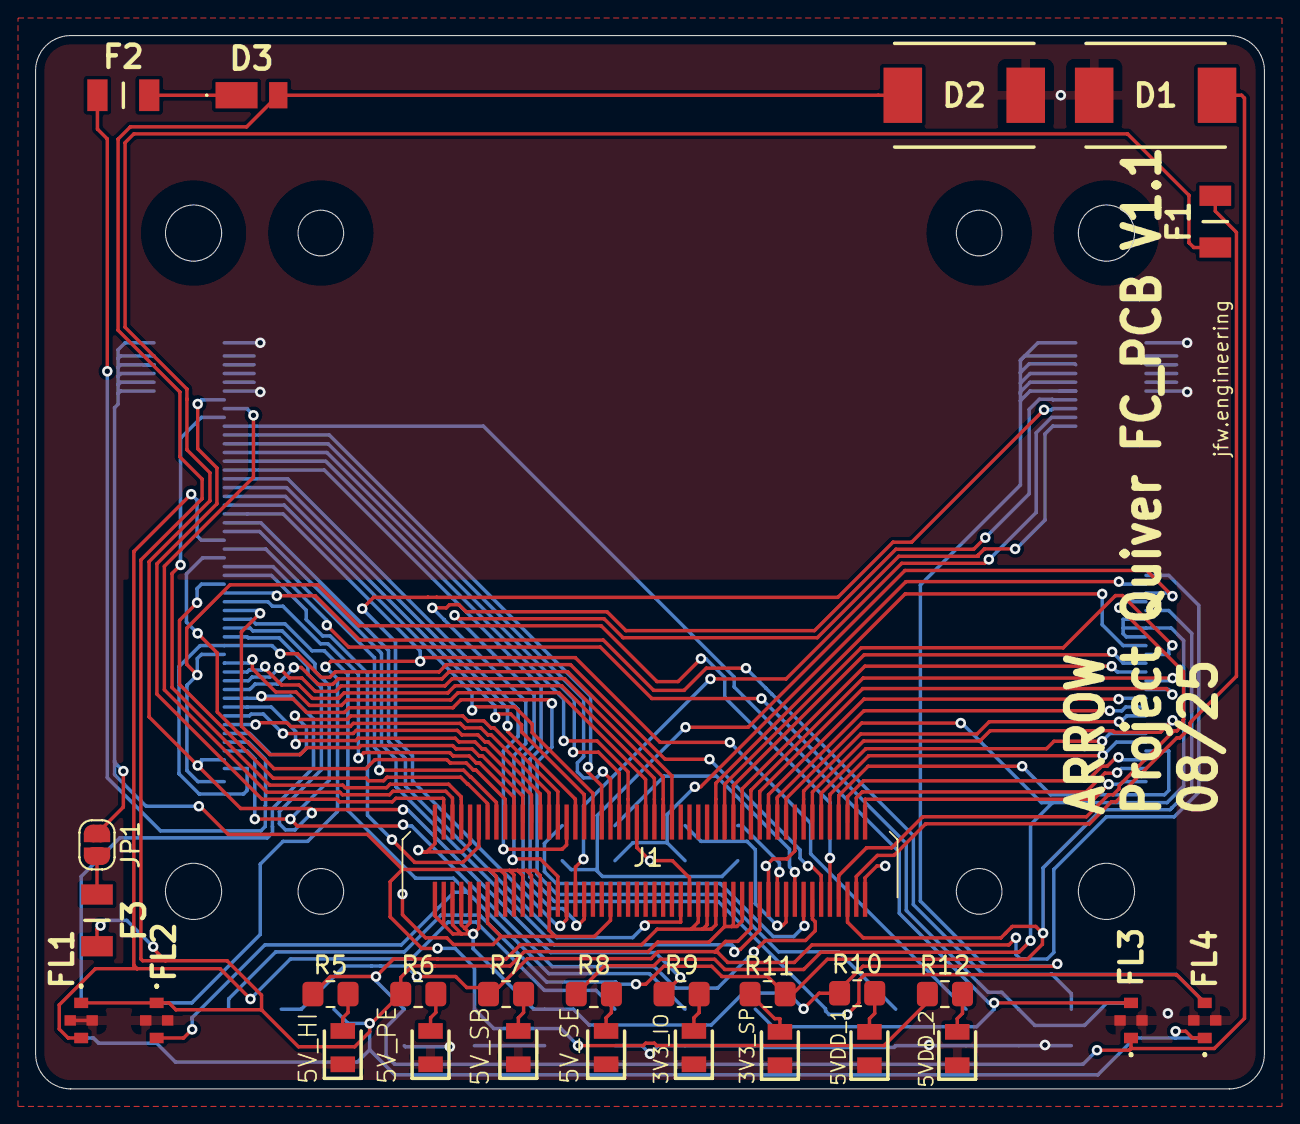
[picture p306: board Quiver_PT3_FC_PCB.kicad_pcb from above]

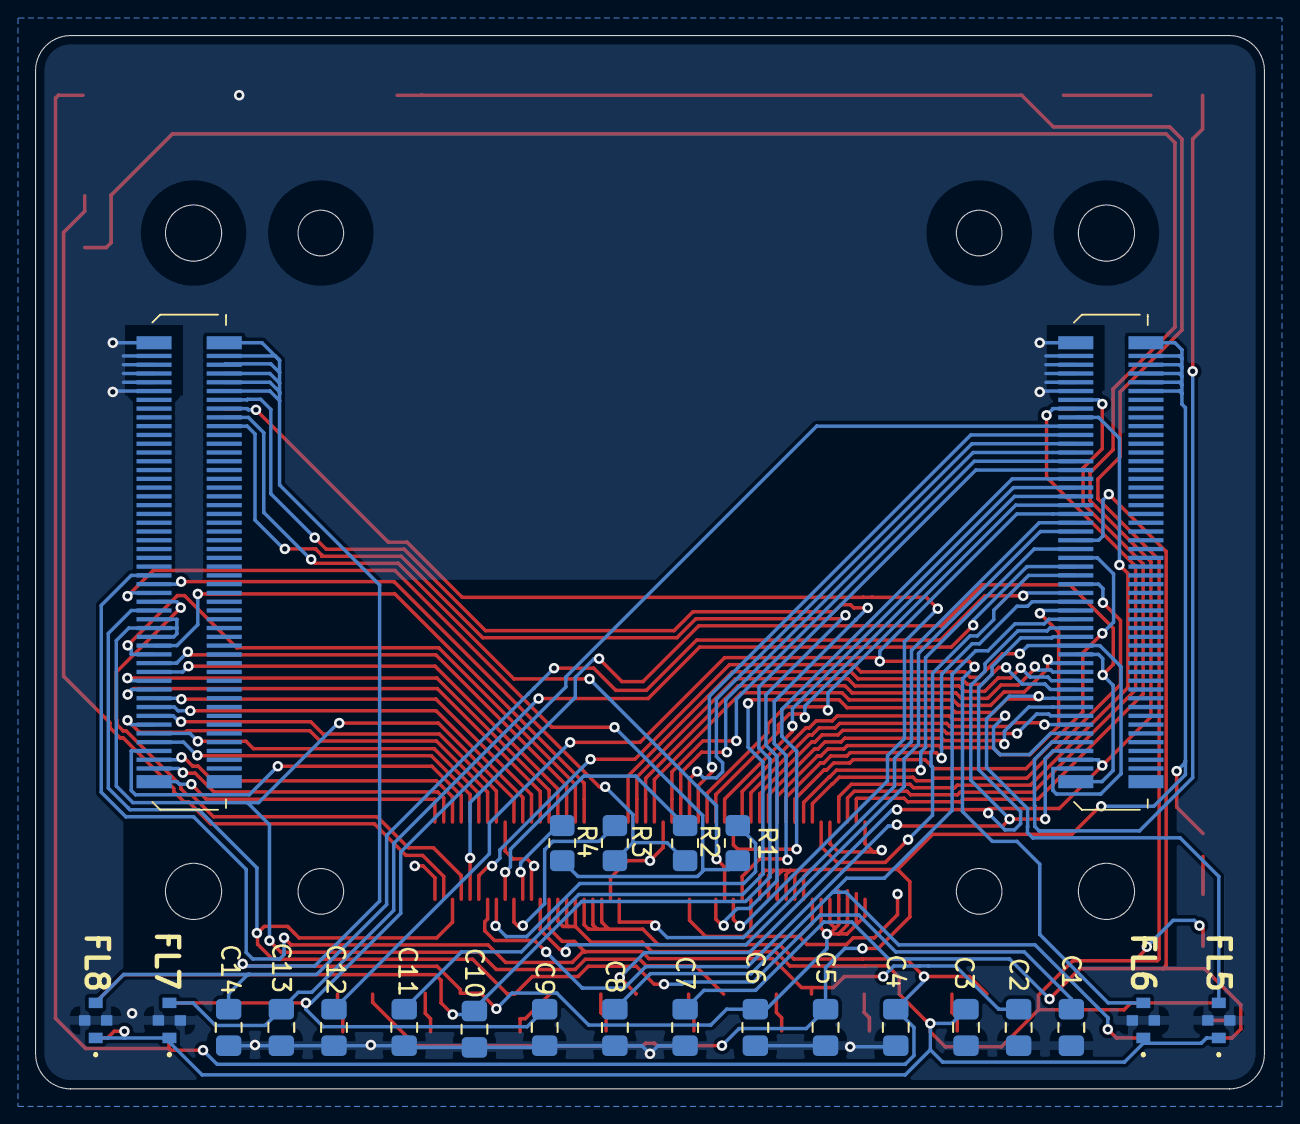
[picture p307: board Quiver_PT3_FC_PCB.kicad_pcb from below]

Board: 4 copper layers, 70.0 x 60.0 mm, 52 parts (24 on the bottom side), 86 nets.
