Julius-eng/project-quiver-05032025/task-grant-bounty/pt3/electronics/0003-Attachment-Interface-PCB/QuiverAttachPCB_10pin/QuiverAttachPCB.kicad_pcb

## KiCad design task-grant-bounty/pt3/electronics/0003-Attachment-Interface-PCB/QuiverAttachPCB_10pin/QuiverAttachPCB.kicad_pcb (2025-08-18)

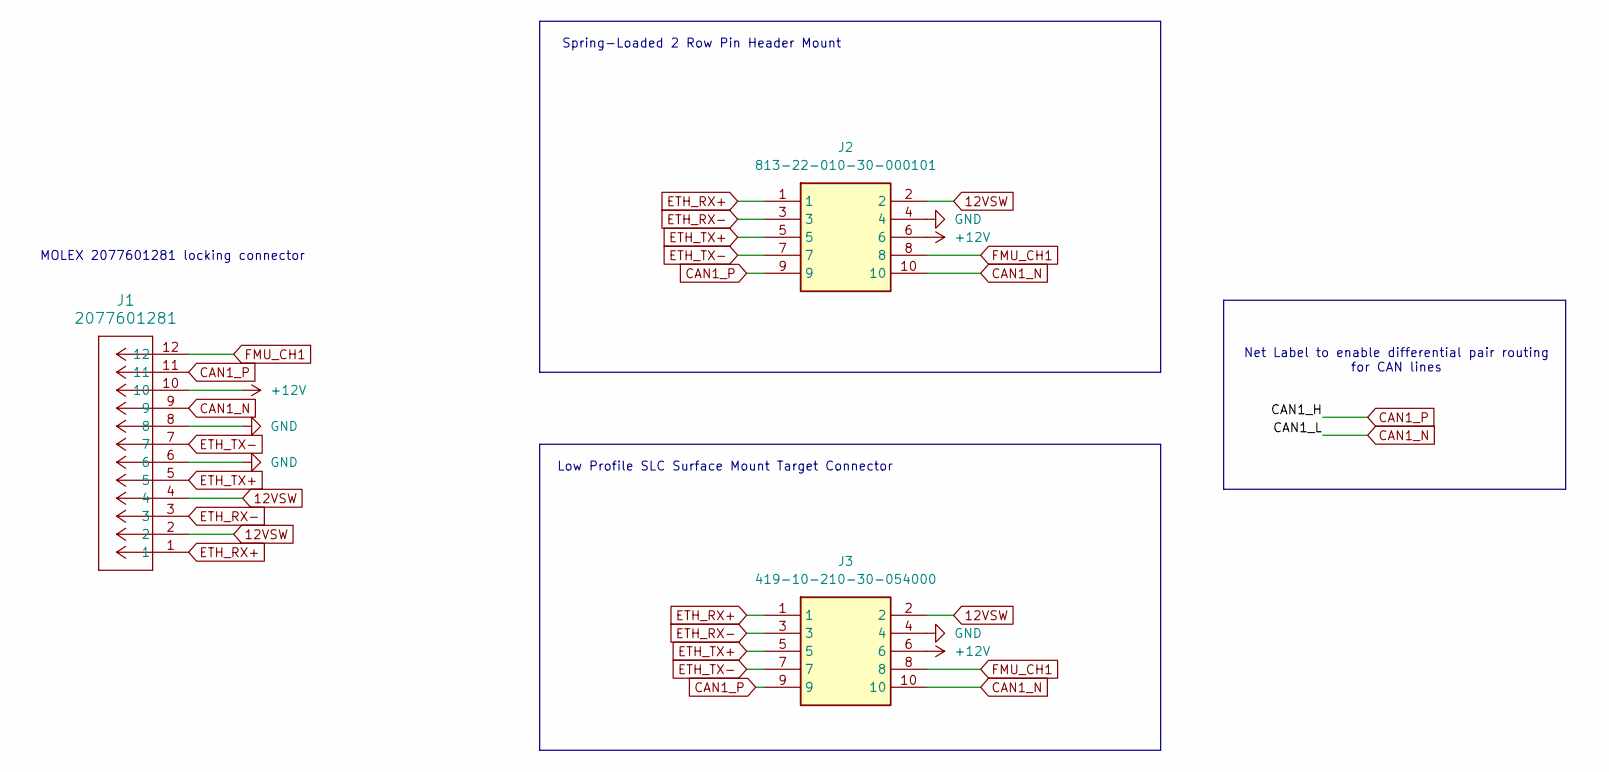
[picture p308: schematic QuiverAttachPCB.kicad_sch, Project Quiver Attachment Interface PCB]

Parts:
J1: 2077601281; CONN12_2077601281_MOL
J2: 813-22-010-30-000101; 8132201030000101; Mouser Part Number 575-8132201030000101
J3: 419-10-210-30-054000; Mouser Part Number 575-8132201030000101

Connections:
12VSW: J1.2, J1.4, J2.2, J3.2
+12V: J1.10, J2.6, J3.6
CAN1_N: J1.9, J2.10, J3.10
CAN1_P: J1.11, J2.9, J3.9
ETH_RX+: J1.1, J2.1, J3.1
ETH_RX-: J1.3, J2.3, J3.3
ETH_TX+: J1.5, J2.5, J3.5
ETH_TX-: J1.7, J2.7, J3.7
FMU_CH1: J1.12, J2.8, J3.8
GND: J1.6, J1.8, J2.4, J3.4

Notes on the sheet:
MOLEX 2077601281 locking connector
Spring-Loaded 2 Row Pin Header Mount
Low Profile SLC Surface Mount Target Connector
Net Label to enable differential pair routing for CAN lines

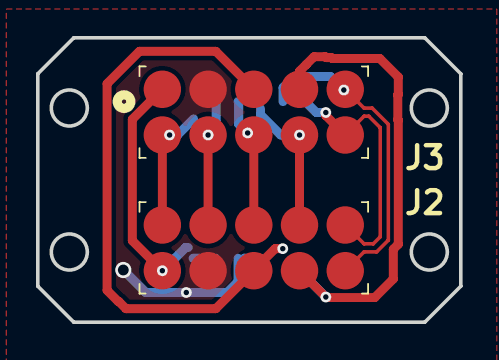
[picture p309: board QuiverAttachPCB.kicad_pcb from above]

Board: 2 copper layers, 23.5 x 15.8 mm, 3 parts (1 on the bottom side), 10 nets.
