Julius-eng/project-quiver-05032025/task-grant-bounty/pt1/electronics/0001-PDB_V1/project-data/Quiver_PDB_01.kicad_pcb

## KiCad design task-grant-bounty/pt1/electronics/0001-PDB_V1/project-data/Quiver_PDB_01.kicad_pcb (2025-04-21)

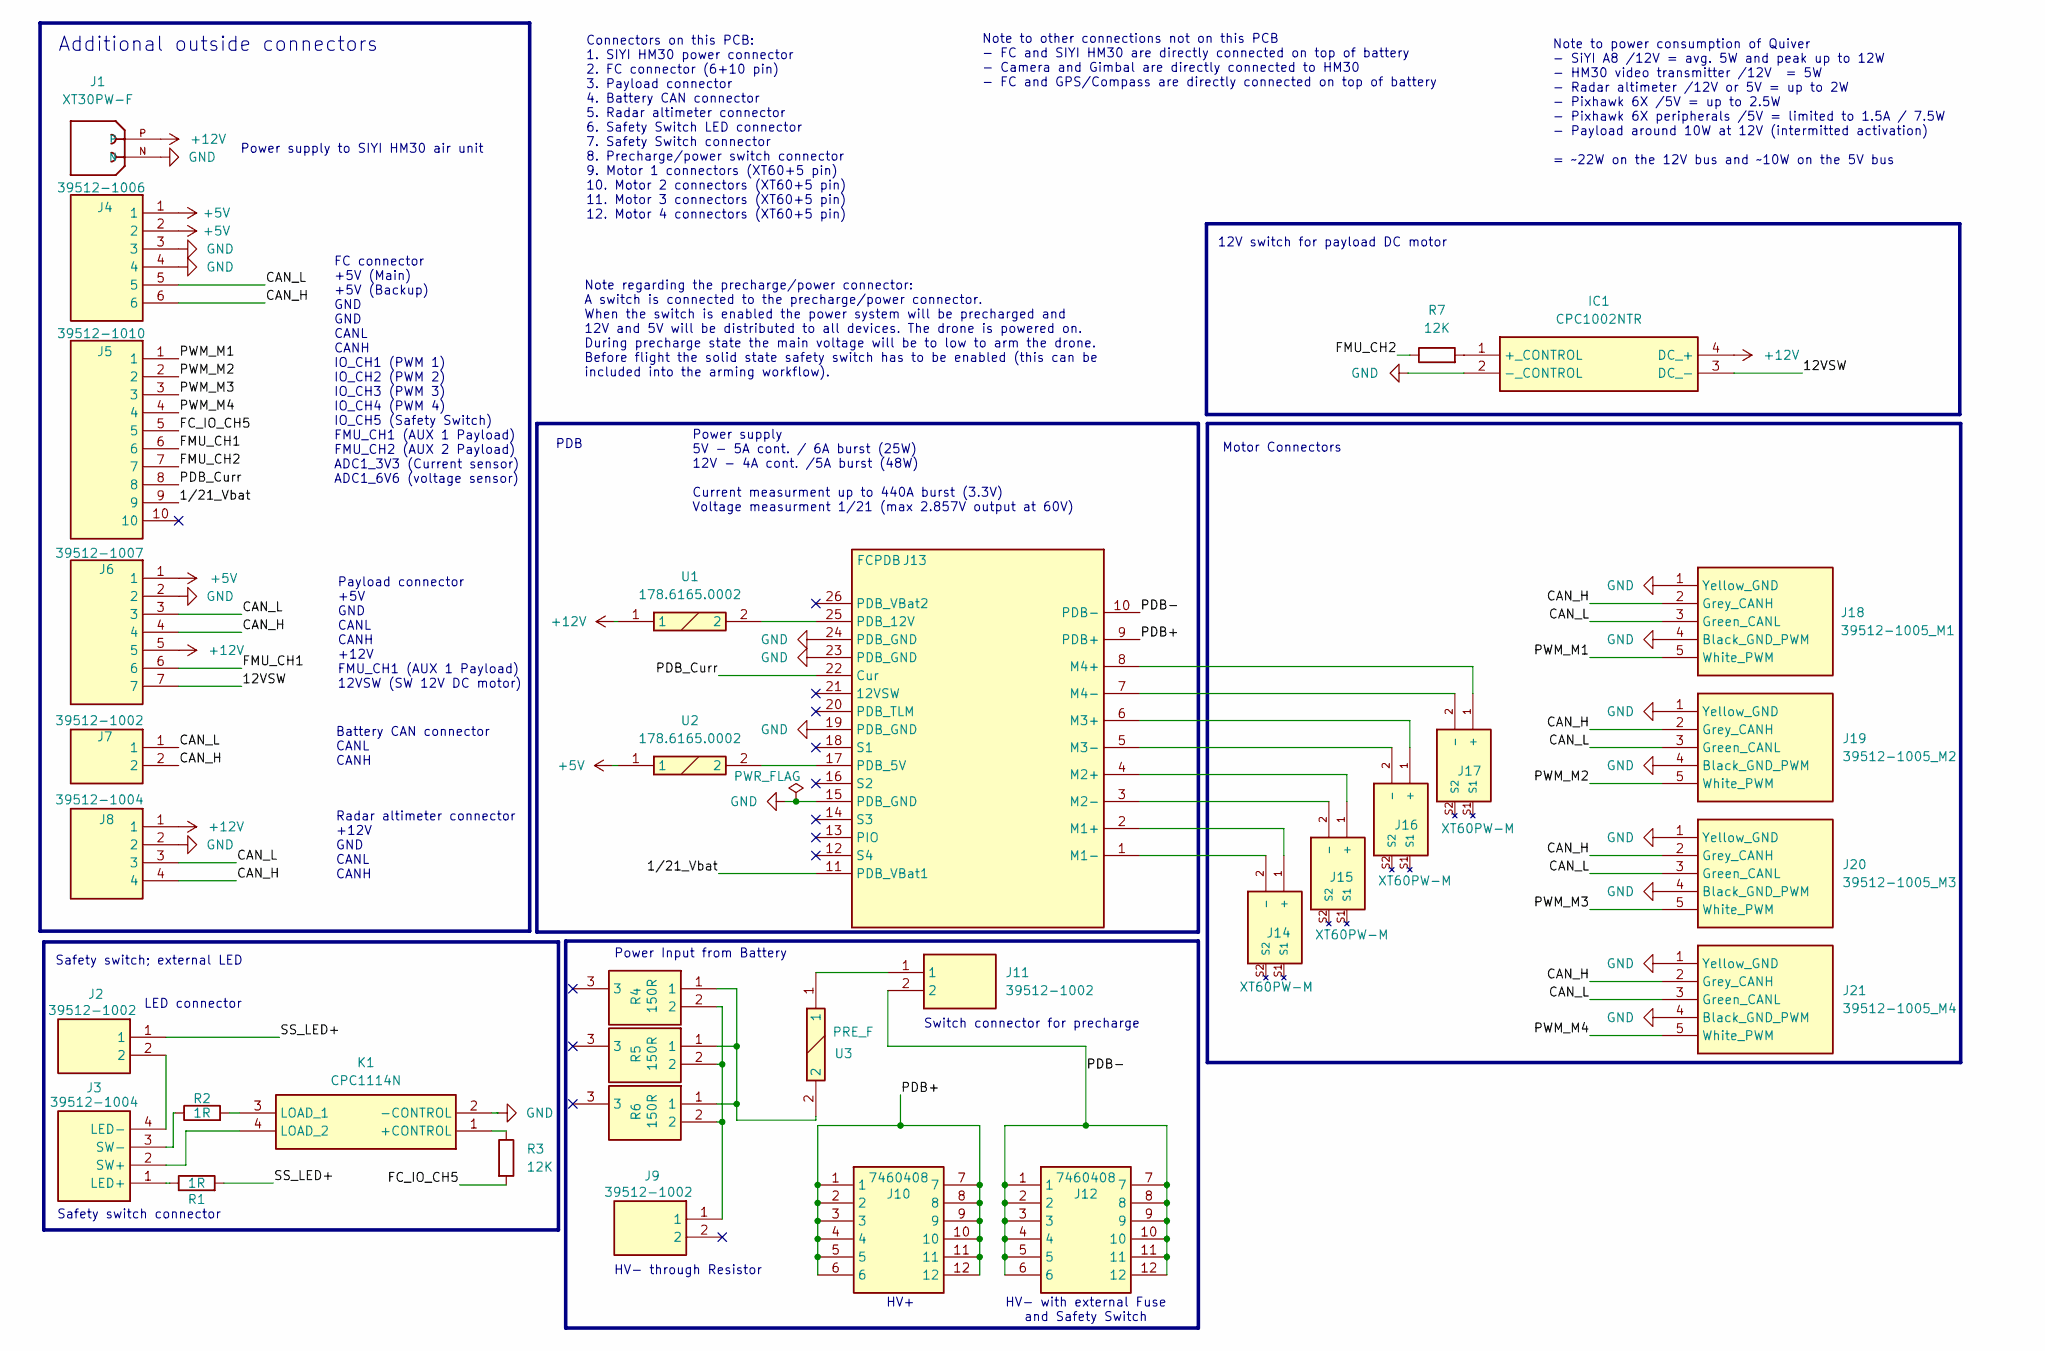
[picture p310: schematic Quiver_PDB_01.kicad_sch]

Parts:
IC1: CPC1002NTR; SOP254P610X216-4N; Mouser Part Number 849-CPC1002NTR
J1: XT30PW-F; XT30PW-F_AMASS_XT30PW-F; PARTREV 1.2
J2, J7, J9, J11: 39512-1002; SHDRRA2W80P0X381_1X2_901X920X730P; Mouser Part Number 538-39512-1002
J3, J8: 39512-1004; SHDRRA4W80P0X381_1X4_1663X920X730P; Mouser Part Number 538-39512-1004
J4: 39512-1006; 395121006; Mouser Part Number 538-39512-1005
J5: 39512-1010; 395121010; Mouser Part Number 538-39512-1005
J6: 39512-1007; 395121007; Mouser Part Number 538-39512-1005
J10, J12: 7460408; Mouser Part Number 710-7460408
J13: FCPDB; PDB_2; Mouser Part Number 200-SSQ12001FD
J14, J15, J16, J17: XT60PW-M; XT60PW-M_AMASS_XT60PW-M; PARTREV V1.2
J18: 39512-1005_M1; 395121005; Mouser Part Number 538-39512-1005
J19: 39512-1005_M2; 395121005; Mouser Part Number 538-39512-1005
J20: 39512-1005_M3; 395121005; Mouser Part Number 538-39512-1005
J21: 39512-1005_M4; 395121005; Mouser Part Number 538-39512-1005
K1: CPC1114N; SOP254P610X218-4N; Mouser Part Number 849-CPC1114N
R1, R2: 1R; R_0805_2012Metric_Pad1.20x1.40mm_HandSolder
R3, R7: 12K; R_0805_2012Metric_Pad1.20x1.40mm_HandSolder
R4, R5, R6: 150R; PWR163S2550R0F; Mouser Part Number 652-PWR163S-25-50R0F
U1, U2: 178.6165.0002; 17861650002; Mouser Part Number 576-178.6165.0002
U3: PRE_F; 17861650002; Mouser Part Number 576-178.6165.0002

Connections:
+5V: J4.1, J4.2, J6.1, U2.1
+12V: IC1.4 (DC_+), J1.P, J6.5, J8.1, U1.1
/1/21_Vbat: J5.9, J13.11 (PDB_VBat1)
/12VSW: IC1.3 (DC_-), J6.7
/CAN_H: J4.6, J6.4, J7.2, J8.4, J18.2 (Grey_CANH), J19.2 (Grey_CANH), J20.2 (Grey_CANH), J21.2 (Grey_CANH)
/CAN_L: J4.5, J6.3, J7.1, J8.3, J18.3 (Green_CANL), J19.3 (Green_CANL), J20.3 (Green_CANL), J21.3 (Green_CANL)
/FC_IO_CH5: J5.5, R3.2
/FMU_CH1: J5.6, J6.6
/FMU_CH2: J5.7, R7.1
/PDB+: J10.1, J10.2, J10.3, J10.4, J10.5, J10.6, J10.7, J10.8, J10.9, J10.10, J10.11, J10.12, J13.9 (PDB+)
/PDB-: J11.2, J12.1, J12.2, J12.3, J12.4, J12.5, J12.6, J12.7, J12.8, J12.9, J12.10, J12.11, J12.12, J13.10 (PDB-)
/PDB_Curr: J5.8, J13.22 (Cur)
/PWM_M1: J5.1, J18.5 (White_PWM)
/PWM_M2: J5.2, J19.5 (White_PWM)
/PWM_M3: J5.3, J20.5 (White_PWM)
/PWM_M4: J5.4, J21.5 (White_PWM)
/SS_LED+: J2.1, R1.2
GND: IC1.2 (-_CONTROL), J1.N, J4.3, J4.4, J6.2, J8.2, J13.15 (PDB_GND), J13.19 (PDB_GND), J13.23 (PDB_GND), J13.24 (PDB_GND), J18.1 (Yellow_GND), J18.4 (Black_GND_PWM), J19.1 (Yellow_GND), J19.4 (Black_GND_PWM), J20.1 (Yellow_GND), J20.4 (Black_GND_PWM), J21.1 (Yellow_GND), J21.4 (Black_GND_PWM), K1.2 (-CONTROL)
unnamed: IC1.1 (+_CONTROL), R7.2
unnamed: J3.1 (LED+), R1.1
unnamed: J2.2, J3.4 (LED-)
unnamed: J3.2 (SW+), K1.4 (LOAD_2)
unnamed: J3.3 (SW-), R2.1
unnamed: J9.1, R4.2, R5.2, R6.2
unnamed: J11.1, U3.1
unnamed: J13.2 (M1+), J14.1 (+)
unnamed: J13.1 (M1-), J14.2 (-)
unnamed: J13.4 (M2+), J15.1 (+)
unnamed: J13.3 (M2-), J15.2 (-)
unnamed: J13.6 (M3+), J16.1 (+)
unnamed: J13.5 (M3-), J16.2 (-)
unnamed: J13.8 (M4+), J17.1 (+)
unnamed: J13.7 (M4-), J17.2 (-)
unnamed: J13.17 (PDB_5V), U2.2
unnamed: J13.25 (PDB_12V), U1.2
unnamed: K1.1 (+CONTROL), R3.1
unnamed: K1.3 (LOAD_1), R2.2
unnamed: R4.1, R5.1, R6.1, U3.2

Notes on the sheet:
HV- with external Fuse and Safety Switch
HV+
HV- through Resistor
FC connector +5V (Main) +5V (Backup) GND GND CANL CANH IO_CH1 (PWM 1) IO_CH2 (PWM 2) IO_CH3 (PWM 3) IO_CH4 (PWM 4) IO_CH5 (Safety Switch) FMU_CH1 (AUX 1 Payload) FMU_CH2 (AUX 2 Payload) ADC1_3V3 (Current sensor) ADC1_6V6 (voltage sensor)
PDB
12V switch for payload DC motor
Power supply 5V - 5A cont. / 6A burst (25W) 12V - 4A cont. /5A burst (48W) Current measurment up to 440A burst (3.3V) Voltage measurment 1/21 (max 2.857V output at 60V)
Radar altimeter connector +12V GND CANL CANH
Power supply to SIYI HM30 air unit
Power Input from Battery
Motor Connectors
Switch connector for precharge
Battery CAN connector CANL CANH
Additional outside connectors
LED connector
Safety switch connector
Safety switch; external LED
Note to other connections not on this PCB - FC and SIYI HM30 are directly connected on top of battery - Camera and Gimbal are directly connected to HM30 - FC and GPS/Compass are directly connected on top of battery
Connectors on this PCB: 1. SIYI HM30 power connector 2. FC connector (6+10 pin) 3. Payload connector 4. Battery CAN connector 5. Radar altimeter connector 6. Safety Switch LED connector 7. Safety Switch connector 8. Precharge/power switch connector 9. Motor 1 connectors (XT60+5 pin) 10. Motor 2 con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
Note regarding the precharge/power connector: A switch is connected to the precharge/power connector. When the switch is enabled the power system will be precharged and 12V and 5V will be distributed to all devices. The drone is powered on. During precharge state the main voltage will be to low to 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
Note to power consumption of Quiver - SiYI A8 /12V = avg. 5W and peak up to 12W - HM30 video transmitter /12V = 5W - Radar altimeter /12V or 5V = up to 2W - Pixhawk 6X /5V = up to 2.5W - Pixhawk 6X peripherals /5V = limited to 1.5A / 7.5W - Payload around 10W at 12V (intermitted activation) = ~22W 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
Payload connector +5V GND CANL CANH +12V FMU_CH1 (AUX 1 Payload) 12VSW (SW 12V DC motor)

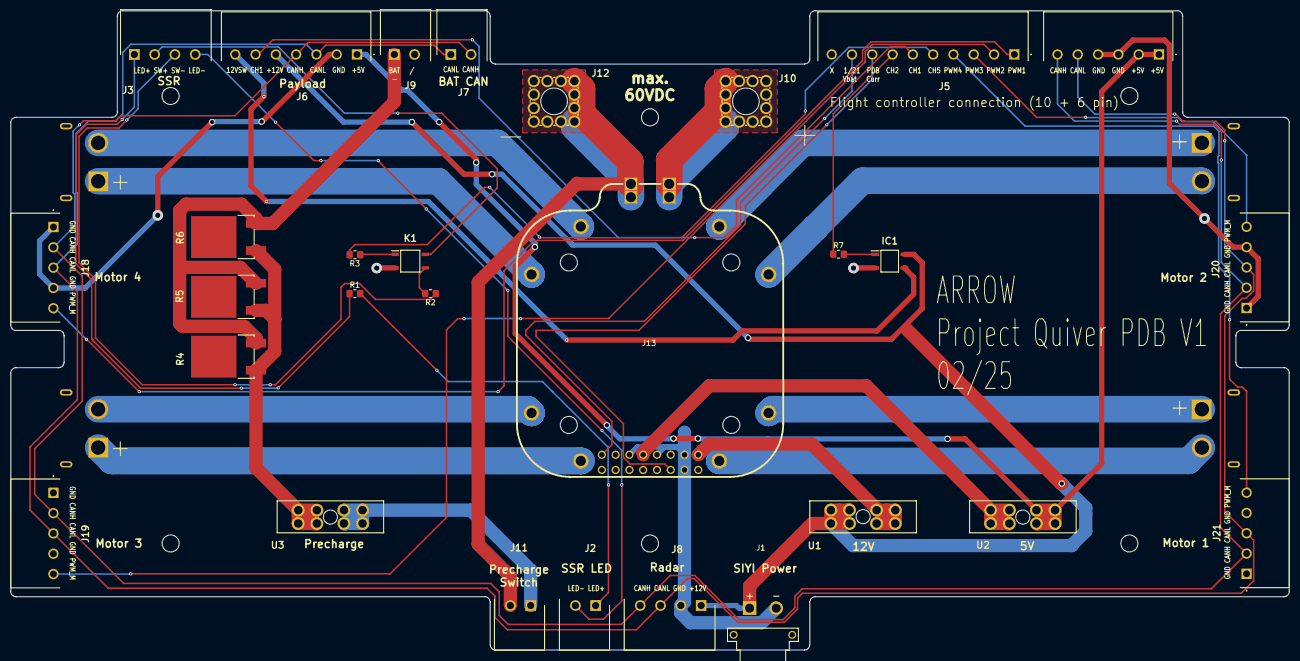
[picture p311: board Quiver_PDB_01.kicad_pcb from above]

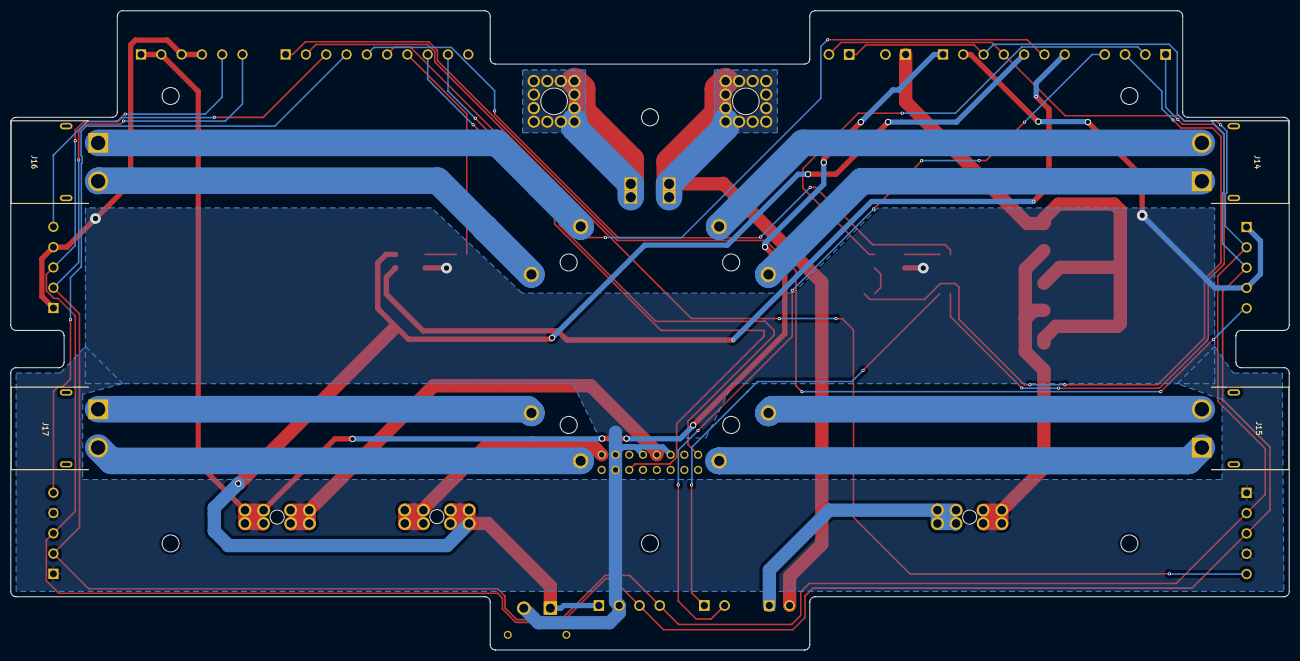
[picture p312: board Quiver_PDB_01.kicad_pcb from below]

Board: 2 copper layers, 240.0 x 120.0 mm, 33 parts (4 on the bottom side), 38 nets.
