Julius-eng/project-quiver-05032025/task-grant-bounty/pt3/electronics/0007-Main-PCB/KiCAD-Files/CAN circuit.kicad_sch

## KiCad design task-grant-bounty/pt3/electronics/0007-Main-PCB/KiCAD-Files/CAN circuit.kicad_sch (2025-11-04)

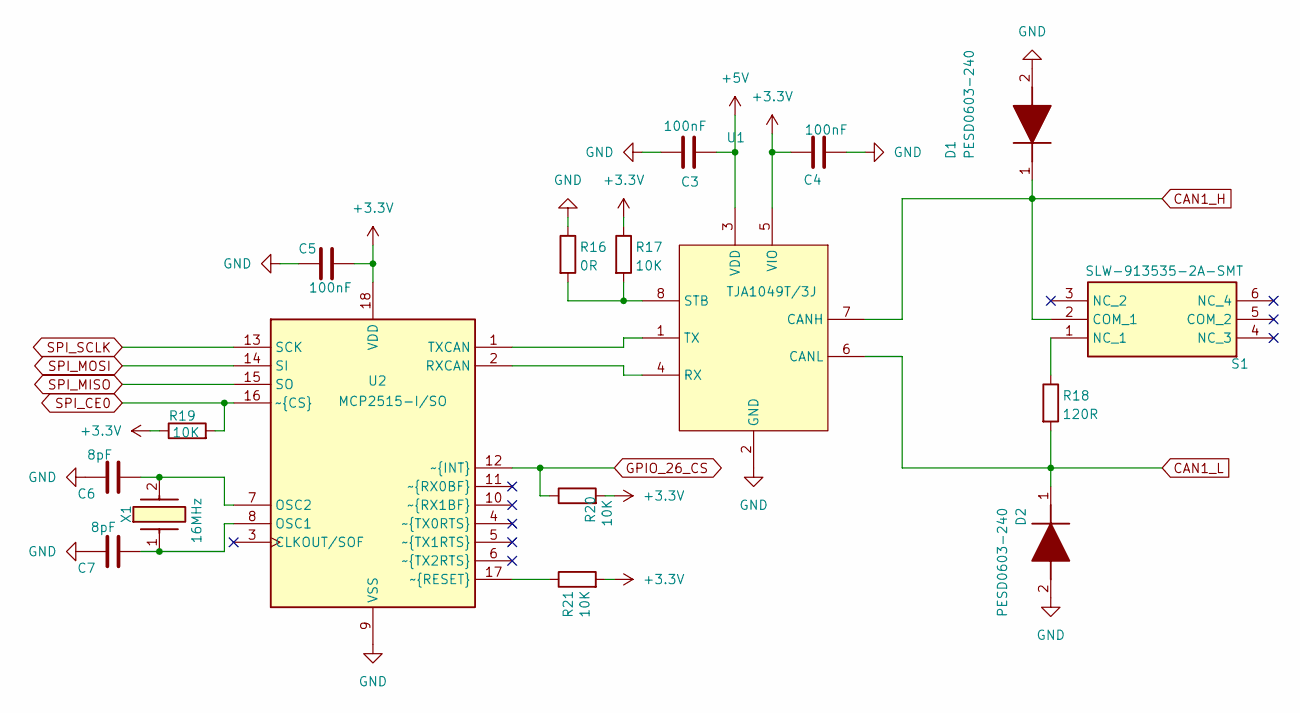
[picture p313: schematic CAN circuit.kicad_sch]

Parts:
C3, C4, C5: 100nF; C_0805_2012Metric_Pad1.18x1.45mm_HandSolder; MPN CC0805KRX7R9BB104
C6, C7: 8pF; C_0603_1608Metric_Pad1.08x0.95mm_HandSolder; MPN CC0603JRNPO9BN8R0
D1, D2: PESD0603-240; DIONC1608X55N; MPN PESD0603-240; Mouser Part Number 650-PESD0603-240
R16: 0R; R_0805_2012Metric_Pad1.20x1.40mm_HandSolder; MPN RC0805FR-070RL
R17, R19, R20, R21: 10K; R_0805_2012Metric_Pad1.20x1.40mm_HandSolder; MPN RC0805FR-0710KL
R18: 120R; R_0805_2012Metric_Pad1.20x1.40mm_HandSolder; MPN RC0805FR-07120RL
S1: SLW-913535-2A-SMT; SLW9135352ASMT; MPN SLW-913535-2A-SMT; Mouser Part Number 179-SLW-913535-2ASMT
U1: TJA1049T/3J; SOIC127P600X175-8N; MPN TJA1049T/3J; Mouser Part Number 771-TJA1049T/3J
U2: MCP2515-I/SO; SOIC127P1030X265-18N; MPN MCP2515-I/SO; Mouser Part Number 579-MCP2515-I/SO
X1: 16MHz; NX3225GD-STD-CRA-3; MPN NX3225GB-16M-STD-CRA-2; Mouser Part Number 344-NX3225GB16MSTRA2

Connections:
+3.3V: C4.1, C5.2, R17.1, R19.1, R20.2, R21.2, U1.5 (VIO), U2.18 (VDD)
+5V: C3.2, U1.3 (VDD)
CAN1_H: D1.1 (K), S1.2 (COM_1), U1.7 (CANH)
CAN1_L: D2.1 (K), R18.2, U1.6 (CANL)
GND: C3.1, C4.2, C5.1, C6.1, C7.1, D1.2 (A), D2.2 (A), R16.1, U1.2 (GND), U2.9 (VSS)
GPIO_26_CS: R20.1, U2.12 (~INT~{})
unnamed: C6.2, U2.7 (OSC2), X1.2
unnamed: C7.2, U2.8 (OSC1), X1.1
unnamed: R16.2, R17.2, U1.8 (STB)
unnamed: R18.1, S1.1 (NC_1)
unnamed: R21.1, U2.17 (~RESET~{})
unnamed: U1.1 (TX), U2.1 (TXCAN)
unnamed: U1.4 (RX), U2.2 (RXCAN)
SPI_CE0: R19.2, U2.16 (~CS~{})
SPI_MISO: U2.15 (SO)
SPI_MOSI: U2.14 (SI)
SPI_SCLK: U2.13 (SCK)
