Julius-eng/project-quiver-05032025/task-grant-bounty/pt3/electronics/0007-Main-PCB/KiCAD-Files/ETHERNET.kicad_sch

## KiCad design task-grant-bounty/pt3/electronics/0007-Main-PCB/KiCAD-Files/ETHERNET.kicad_sch (2025-11-04)

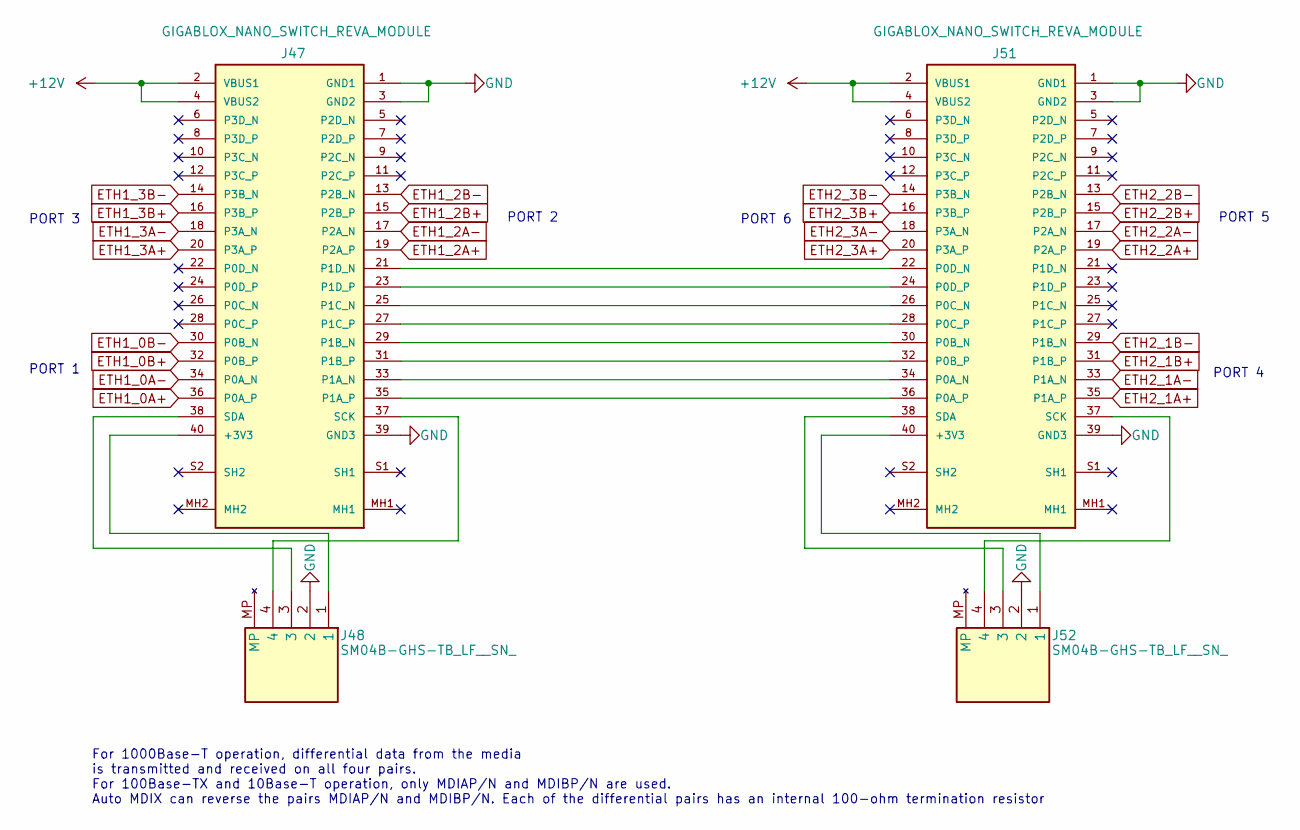
[picture p314: schematic ETHERNET.kicad_sch]

Parts:
J47, J51: GIGABLOX_NANO_SWITCH_REVA_MODULE; GIGABLOX_NANO_SWITCH_REVA_MODULE_LSHM-120-02.5-L-DV-A-S-K-TR; Mouser Part Number 200-LSHM1202.5LDVASK
J48, J52: SM04B-GHS-TB_LF__SN_; SM04B-GHS-TB; Mouser Part Number N/A

Connections:
+12V: J47.2 (VBUS1), J47.4 (VBUS2), J51.2 (VBUS1), J51.4 (VBUS2)
ETH1_0A+: J47.36 (P0A_P)
ETH1_0A-: J47.34 (P0A_N)
ETH1_0B+: J47.32 (P0B_P)
ETH1_0B-: J47.30 (P0B_N)
ETH1_2A+: J47.19 (P2A_P)
ETH1_2A-: J47.17 (P2A_N)
ETH1_2B+: J47.15 (P2B_P)
ETH1_2B-: J47.13 (P2B_N)
ETH1_3A+: J47.20 (P3A_P)
ETH1_3A-: J47.18 (P3A_N)
ETH1_3B+: J47.16 (P3B_P)
ETH1_3B-: J47.14 (P3B_N)
ETH2_1A+: J51.35 (P1A_P)
ETH2_1A-: J51.33 (P1A_N)
ETH2_1B+: J51.31 (P1B_P)
ETH2_1B-: J51.29 (P1B_N)
ETH2_2A+: J51.19 (P2A_P)
ETH2_2A-: J51.17 (P2A_N)
ETH2_2B+: J51.15 (P2B_P)
ETH2_2B-: J51.13 (P2B_N)
ETH2_3A+: J51.20 (P3A_P)
ETH2_3A-: J51.18 (P3A_N)
ETH2_3B+: J51.16 (P3B_P)
ETH2_3B-: J51.14 (P3B_N)
GND: J47.1 (GND1), J47.3 (GND2), J47.39 (GND3), J48.2, J51.1 (GND1), J51.3 (GND2), J51.39 (GND3), J52.2
unnamed: J47.21 (P1D_N), J51.22 (P0D_N)
unnamed: J47.23 (P1D_P), J51.24 (P0D_P)
unnamed: J47.25 (P1C_N), J51.26 (P0C_N)
unnamed: J47.27 (P1C_P), J51.28 (P0C_P)
unnamed: J47.29 (P1B_N), J51.30 (P0B_N)
unnamed: J47.31 (P1B_P), J51.32 (P0B_P)
unnamed: J47.33 (P1A_N), J51.34 (P0A_N)
unnamed: J47.35 (P1A_P), J51.36 (P0A_P)
unnamed: J47.37 (SCK), J48.4
unnamed: J47.38 (SDA), J48.3
unnamed: J47.40 (+3V3), J48.1
unnamed: J51.37 (SCK), J52.4
unnamed: J51.38 (SDA), J52.3
unnamed: J51.40 (+3V3), J52.1

Notes on the sheet:
PORT 6
PORT 3
For 1000Base-T operation, differential data from the media is transmitted and received on all four pairs. For 100Base-TX and 10Base-T operation, only MDIAP/N and MDIBP/N are used. Auto MDIX can reverse the pairs MDIAP/N and MDIBP/N. Each of the differential pairs has an internal 100-ohm termination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
PORT 4
PORT 2
PORT 1
PORT 5
