Julius-eng/project-quiver-05032025/task-grant-bounty/pt3/electronics/0007-Main-PCB/KiCAD-Files/Quiver_PT3_Main_PCB.kicad_sch

## KiCad design task-grant-bounty/pt3/electronics/0007-Main-PCB/KiCAD-Files/Quiver_PT3_Main_PCB.kicad_sch (2025-11-04)

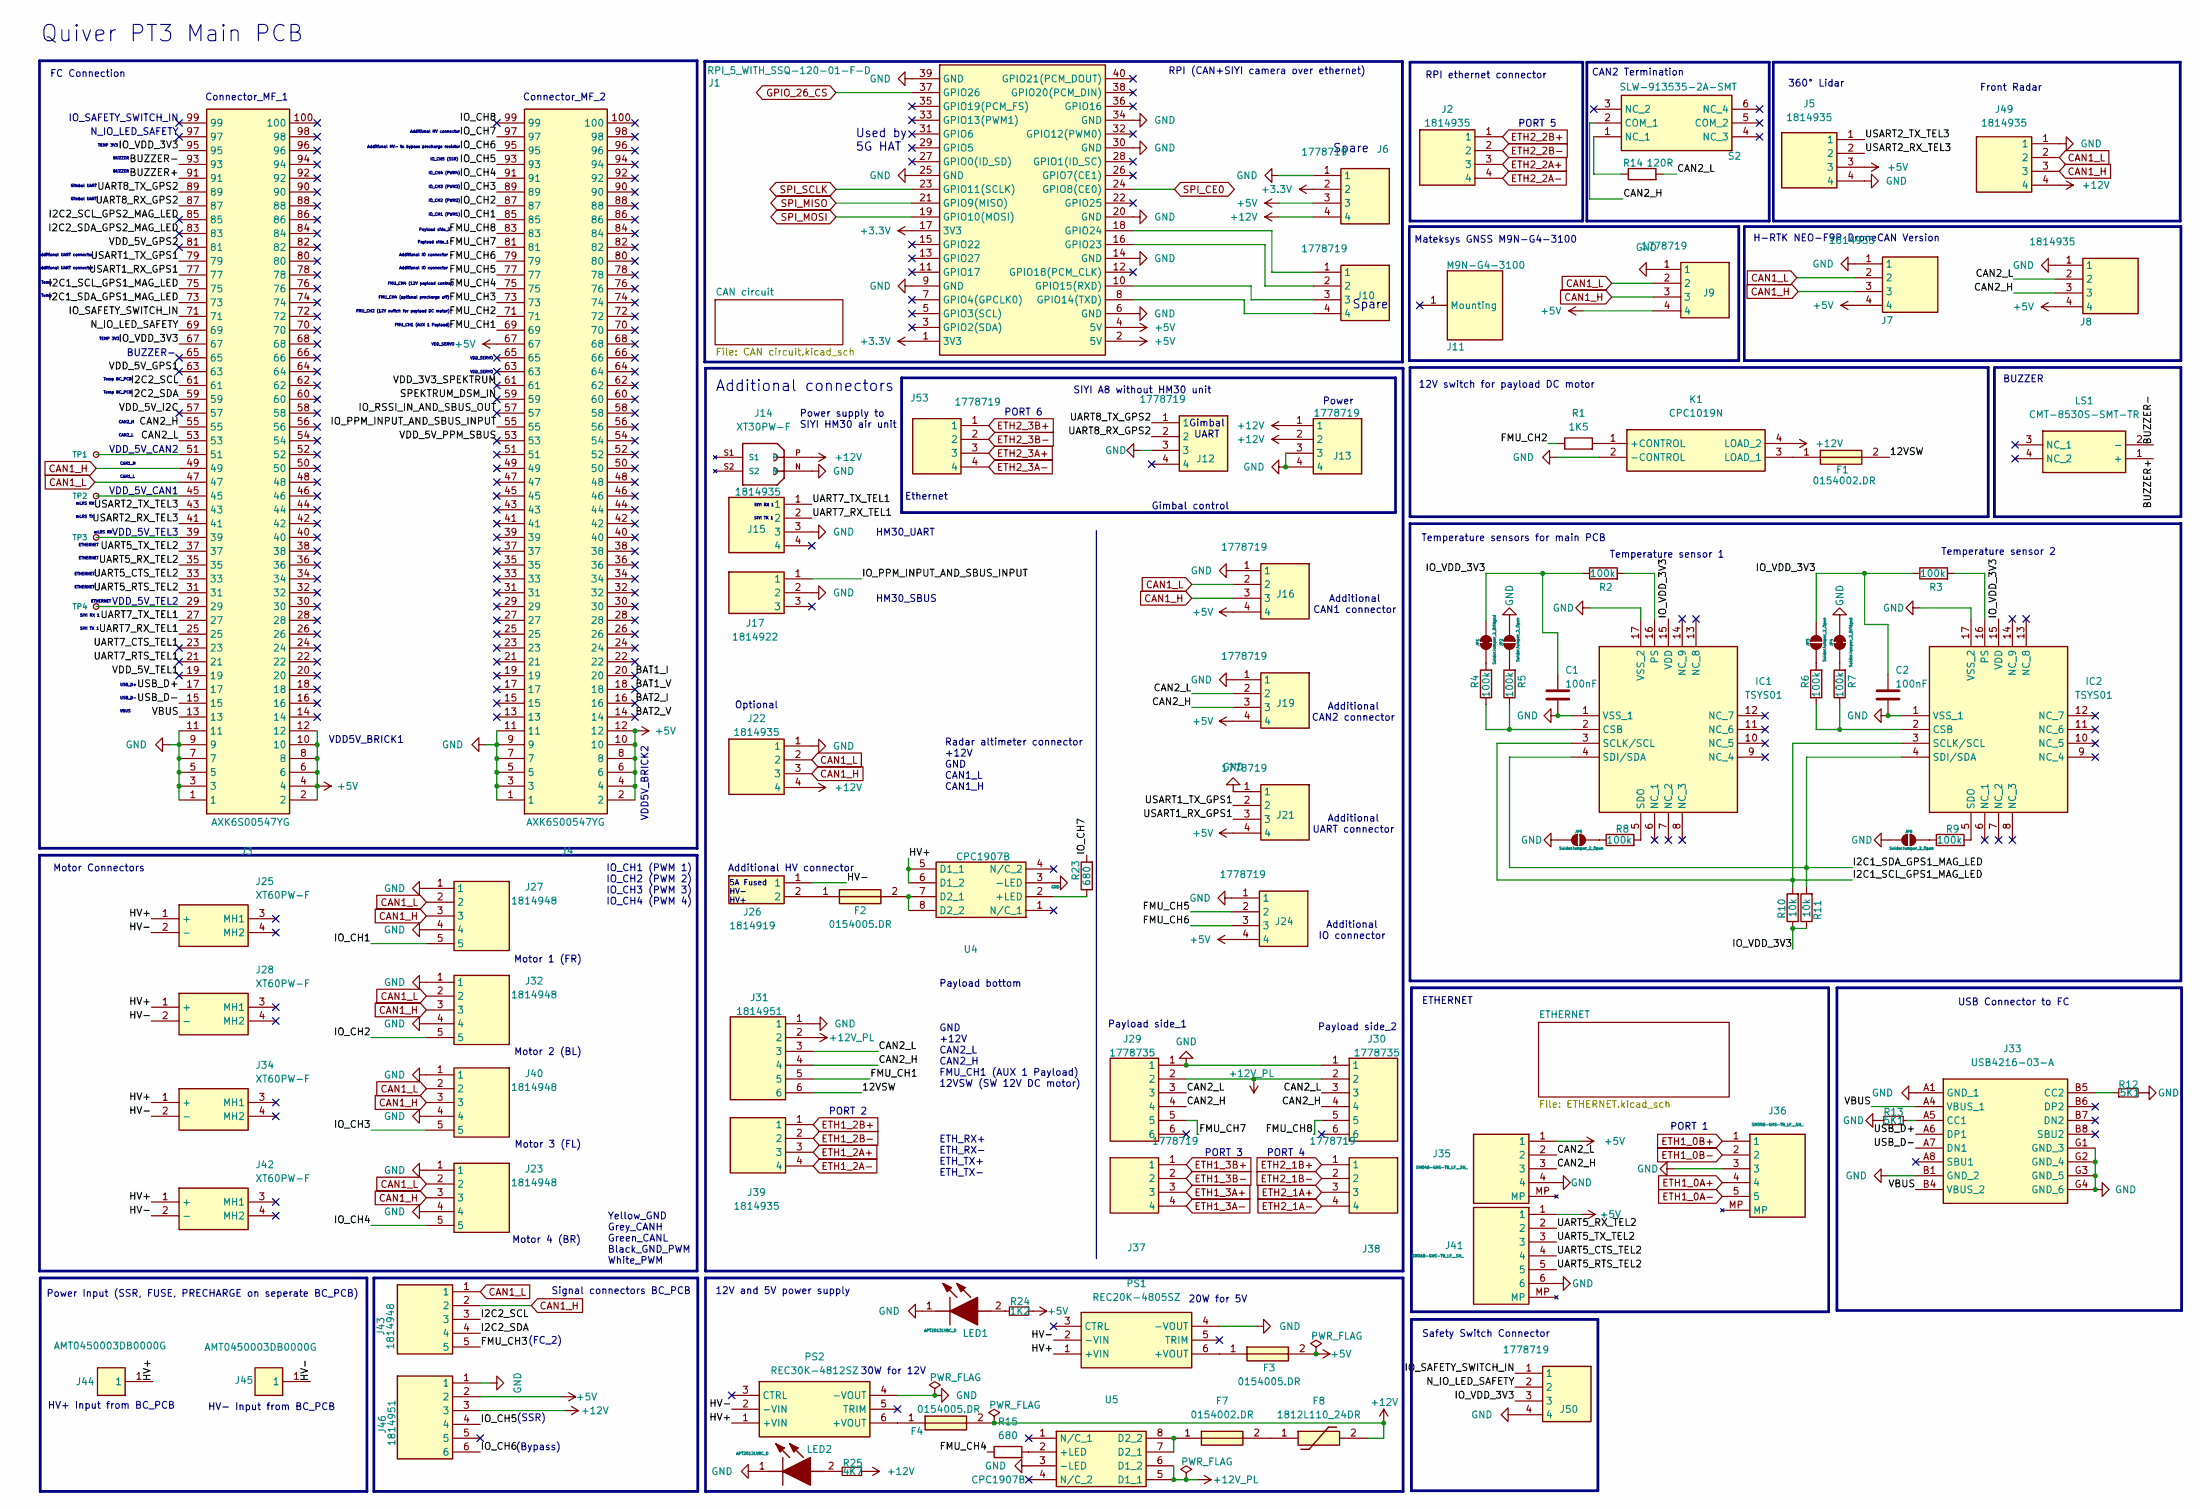
[picture p315: schematic Quiver_PT3_Main_PCB.kicad_sch]

Parts:
C1, C2: 100nF; C_0805_2012Metric_Pad1.18x1.45mm_HandSolder; MPN CC0805KRX7R9BB104
F1, F7: 0154002.DR; 0154002DR; Mouser Part Number 576-0154002.DR
F2, F3, F4: 0154005.DR; 0154005DR; Mouser Part Number 576-0154005.DR
F8: 1812L110_24DR; 1812L010DR; Mouser Part Number 576-1812L110/24DR
IC1, IC2: TSYS01; QFN65P400X400X90-17N; Mouser Part Number 824-TSYS01
J1: RPI_5_WITH_SSQ-120-01-F-D; SSM-120-XXX-DV; Mouser Part Number 200-SSQ12001FD
J2, J5, J7, J8, J15, J22, J39, J49: 1814935; Mouser Part Number 651-1814935
J3, J4: AXK6S00547YG; MANUFACTURER_PART_NUMBER AXK5S00347YG; Mouser Part Number 769-AXK6S00547YG
J6, J9, J10, J12, J13, J16, J19, J21, J24, J37, J38, J50, J53: 1778719; Mouser Part Number 651-1778719
J11: M9N-G4-3100; Manufacturer_Part_Number SSQ-104-01-L-D
J14: XT30PW-F; XT30PW-F_AMASS_XT30PW-F; PARTREV 1.2
J17: 1814922; Mouser Part Number 651-1814922
J23, J27, J32, J40, J43: 1814948; Mouser Part Number 651-1814948
J25, J28, J34, J42: XT60PW-F; XT60PWF; Manufacturer_Part_Number XT60PW-F
J26: 1814919; Mouser Part Number 651-1814919
J29, J30: 1778735; Mouser Part Number 651-1778735
J31, J46: 1814951; Mouser Part Number 651-1814951
J33: USB4216-03-A; USB421603A; Mouser Part Number 640-USB4216-03-A
J35: SM04B-GHS-TB_LF__SN_; SM04B-GHS-TB; Mouser Part Number N/A
J36: SM05B-GHS-TB_LF__SN_; SM05B-GHS-TB; Mouser Part Number N/A
J41: SM06B-GHS-TB_LF__SN_; SM06B-GHS-TB; Mouser Part Number N/A
J44, J45: AMT0450003DB0000G; Mouser Part Number 523-AMT0450003DB000G
JP1, JP4: SolderJumper_2_Bridged; SolderJumper-2_P1.3mm_Bridged2Bar_RoundedPad1.0x1.5mm
JP2, JP3, JP5, JP6: SolderJumper_2_Open; SolderJumper-2_P1.3mm_Open_RoundedPad1.0x1.5mm
K1: CPC1019N; SOP254P610X218-4N; Mouser Part Number 849-CPC1019N
LED1, LED2: APT2012LVBC_D; LEDC2012X85N; Mouser Part Number 604-APT2012LVBCD
LS1: CMT-8530S-SMT-TR; CMT8530SSMTTR; Mouser Part Number 490-CMT-8530S-SMT-TR
PS1: REC20K-4805SZ; REC20K; Manufacturer_Part_Number REC20K-4805SZ
PS2: REC30K-4812SZ; REC30K; Manufacturer_Part_Number REC30K-4812SZ
R1: 1K5; R_0805_2012Metric_Pad1.20x1.40mm_HandSolder
R2, R3, R4, R5, R6, R7: 100k; R_0805_2012Metric_Pad1.20x1.40mm_HandSolder
R8: 100k; R_0805_2012Metric_Pad1.20x1.40mm_HandSolder; MPN RC0805FR-0710KL
R9: 100k; R_0805_2012Metric_Pad1.20x1.40mm_HandSolder; MPN RC0805FR-07120RL
R10, R11: 10k; R_0805_2012Metric_Pad1.20x1.40mm_HandSolder; MPN RC0805FR-0710KL
R12, R13: 5K1; R_0805_2012Metric_Pad1.20x1.40mm_HandSolder
R14: 120R; R_0805_2012Metric_Pad1.20x1.40mm_HandSolder; MPN RC0805FR-07120RL
R15, R23: 680; R_0805_2012Metric_Pad1.20x1.40mm_HandSolder
R24: 1K2; R_0805_2012Metric_Pad1.20x1.40mm_HandSolder
R25: 4K7; R_0805_2012Metric_Pad1.20x1.40mm_HandSolder
S2: SLW-913535-2A-SMT; SLW9135352ASMT; MPN SLW-913535-2A-SMT; Mouser Part Number 179-SLW-913535-2ASMT
TP1, TP2, TP3, TP4: TestPoint_Small; TestPoint_Pad_1.0x1.0mm
U4, U5: CPC1907B; Mouser Part Number 849-CPC1907B

Connections:
12VSW: F1.2, J31.6
I2C2_SDA_GPS2_MAG_LED: J3.83
+3.3V: J1.1 (3V3), J1.17 (3V3), J6.2
+5V: F3.2, J1.2 (5V), J1.4 (5V), J3.2, J3.4, J3.6, J3.8, J3.10, J3.12, J4.2, J4.4, J4.6, J4.8, J4.10, J4.12, J4.67, J5.3, J6.3, J7.4, J8.4, J9.4, J16.4, J19.4, J21.4, J24.4, J35.1, J41.1, J46.2, R24.1
+12V: F4.2, F8.2, J6.4, J13.1, J13.2, J14.P, J22.4, J46.3, J49.4, K1.4 (LOAD_2), R25.1
+12V_PL: J29.2, J30.2, J31.2, U5.5 (D1_1), U5.6 (D1_2)
BAT1_I: J4.20
BAT1_V: J4.18
BAT2_I: J4.16
BAT2_V: J4.14
BUZZER+: J3.91, LS1.1 (+)
BUZZER-: J3.93, LS1.2 (-)
CAN1_H: J3.49, J7.3, J9.3, J16.3, J22.3, J23.3, J27.3, J32.3, J40.3, J43.2, J49.3
CAN1_L: J3.47, J7.2, J9.2, J16.2, J22.2, J23.2, J27.2, J32.2, J40.2, J43.1, J49.2
CAN2_H: J3.55, J8.3, J19.3, J29.4, J30.4, J31.4, J35.3, S2.2 (COM_1)
CAN2_L: J3.53, J8.2, J19.2, J29.3, J30.3, J31.3, J35.2, R14.2
ETH1_0A+: J36.4
ETH1_0A-: J36.5
ETH1_0B+: J36.1
ETH1_0B-: J36.2
ETH1_2A+: J39.3
ETH1_2A-: J39.4
ETH1_2B+: J39.1
ETH1_2B-: J39.2
ETH1_3A+: J37.3
ETH1_3A-: J37.4
ETH1_3B+: J37.1
ETH1_3B-: J37.2
ETH2_1A+: J38.3
ETH2_1A-: J38.4
ETH2_1B+: J38.1
ETH2_1B-: J38.2
ETH2_2A+: J2.3
ETH2_2A-: J2.4
ETH2_2B+: J2.1
ETH2_2B-: J2.2
ETH2_3A+: J53.3
ETH2_3A-: J53.4
ETH2_3B+: J53.1
ETH2_3B-: J53.2
FMU_CH1: J4.69, J31.5
FMU_CH2: J4.71, R1.1
FMU_CH3: J4.73, J43.5
FMU_CH4: J4.75, R15.1
FMU_CH5: J4.77, J24.2
FMU_CH6: J4.79, J24.3
FMU_CH7: J4.81, J29.5
FMU_CH8: J4.83, J30.5
GND: C1.2, C2.2, IC1.1 (VSS_1), IC1.17 (VSS_2), IC2.1 (VSS_1), IC2.17 (VSS_2), J1.6 (GND), J1.9 (GND), J1.14 (GND), J1.20 (GND), J1.25 (GND), J1.30 (GND), J1.34 (GND), J1.39 (GND), J3.1, J3.3, J3.5, J3.7, J3.9, J3.11, J4.1, J4.3, J4.5, J4.7, J4.9, J4.11, J5.4, J6.1, J7.1, J8.1, J9.1, J12.3, J13.3, J13.4, J14.N, J15.3, J16.1, J17.2, J19.1, J21.1, J22.1, J23.1, J23.4, J24.1, J27.1, J27.4, J29.1, J30.1, J31.1, J32.1, J32.4, J33.A1 (GND_1), J33.B1 (GND_2), J33.G1 (GND_3), J33.G2 (GND_4), J33.G3 (GND_5), J33.G4 (GND_6), J35.4, J36.3, J40.1, J40.4, J41.6, J46.1, J49.1, J50.4, JP2.2 (B), JP4.2 (B), JP5.1 (A), JP6.1 (A), K1.2 (-CONTROL), LED1.1 (K), LED2.1 (K), PS1.4 (-VOUT), PS2.4 (-VOUT), R12.2, R13.1, U4.3 (-LED), U5.3 (-LED)
GPIO_26_CS: J1.37 (GPIO26)
HV+: J25.1 (+), J28.1 (+), J34.1 (+), J42.1 (+), J44.1, PS1.1 (+VIN), PS2.1 (+VIN), U4.5 (D1_1), U4.6 (D1_2)
HV-: J25.2 (-), J26.1, J28.2 (-), J34.2 (-), J42.2 (-), J45.1, PS1.2 (-VIN), PS2.2 (-VIN)
I2C1_SCL_GPS1_MAG_LED: IC1.3 (SCLK/SCL), IC2.3 (SCLK/SCL), J3.75, R10.2
I2C1_SDA_GPS1_MAG_LED: IC1.4 (SDI/SDA), IC2.4 (SDI/SDA), J3.73, R11.2
I2C2_SCL: J3.61, J43.3
I2C2_SCL_GPS2_MAG_LED: J3.85
I2C2_SDA: J3.59, J43.4
IO_CH1: J4.85, J27.5
IO_CH2: J4.87, J32.5
IO_CH3: J4.89, J40.5
IO_CH4: J4.91, J23.5
IO_CH5: J4.93, J46.4
IO_CH6: J4.95, J46.6
IO_CH7: J4.97, R23.2
IO_CH8: J4.99
IO_PPM_INPUT_AND_SBUS_INPUT: J4.55, J17.1
IO_RSSI_IN_AND_SBUS_OUT: J4.57
IO_SAFETY_SWITCH_IN: J3.71, J50.1
IO_VDD_3V3: C1.1, C2.1, IC1.15 (VDD), IC2.15 (VDD), J3.67, J3.95, J50.3, JP1.2 (B), JP3.2 (B), R2.1, R3.1, R10.1, R11.1
N_IO_LED_SAFETY: J3.69, J50.2
unnamed: F1.1, K1.3 (LOAD_1)
unnamed: F2.1, J26.2
unnamed: F2.2, U4.7 (D2_1), U4.8 (D2_2)
unnamed: F3.1, PS1.6 (+VOUT)
unnamed: F4.1, PS2.6 (+VOUT)
unnamed: F7.1, U5.7 (D2_1), U5.8 (D2_2)
unnamed: F7.2, F8.1
unnamed: IC1.2 (CSB), R4.1, R5.1
unnamed: IC1.5 (SDO), R8.2
unnamed: IC1.16 (PS), R2.2
unnamed: IC2.2 (CSB), R6.1, R7.1
unnamed: IC2.5 (SDO), R9.2
unnamed: IC2.16 (PS), R3.2
unnamed: J1.8 (GPIO14(TXD)), J10.4
unnamed: J1.10 (GPIO15(RXD)), J10.3
unnamed: J1.16 (GPIO23), J10.2
unnamed: J1.18 (GPIO24), J10.1
unnamed: J3.29, TP4.1
unnamed: J3.39, TP3.1
unnamed: J3.45, TP2.1
unnamed: J3.51, TP1.1
unnamed: J33.A5 (CC1), R13.2
unnamed: J33.B5 (CC2), R12.1
unnamed: JP1.1 (A), R4.2
unnamed: JP2.1 (A), R5.2
unnamed: JP3.1 (A), R6.2
unnamed: JP4.1 (A), R7.2
unnamed: JP5.2 (B), R8.1
unnamed: JP6.2 (B), R9.1
unnamed: K1.1 (+CONTROL), R1.2
unnamed: LED1.2 (A), R24.2
unnamed: LED2.2 (A), R25.2
unnamed: R14.1, S2.1 (NC_1)
unnamed: R15.2, U5.2 (+LED)
unnamed: R23.1, U4.2 (+LED)
SPEKTRUM_DSM_IN: J4.59
SPI_CE0: J1.24 (GPIO8(CE0))
SPI_MISO: J1.21 (GPIO9(MISO))
SPI_MOSI: J1.19 (GPIO10(MOSI))
SPI_SCLK: J1.23 (GPIO11(SCLK))
UART5_CTS_TEL2: J3.33, J41.4
UART5_RTS_TEL2: J3.31, J41.5
UART5_RX_TEL2: J3.35, J41.2
UART5_TX_TEL2: J3.37, J41.3
UART7_CTS_TEL1: J3.23
UART7_RTS_TEL1: J3.21
UART7_RX_TEL1: J3.25, J15.2
UART7_TX_TEL1: J3.27, J15.1
UART8_RX_GPS2: J3.87, J12.2
UART8_TX_GPS2: J3.89, J12.1
USART1_RX_GPS1: J3.77, J21.3
USART1_TX_GPS1: J3.79, J21.2
USART2_RX_TEL3: J3.41, J5.2
USART2_TX_TEL3: J3.43, J5.1
USB_D+: J3.17, J33.A6 (DP1)
USB_D-: J3.15, J33.A7 (DN1)
VBUS: J3.13, J33.A4 (VBUS_1), J33.B4 (VBUS_2)
VDD_3V3_SPEKTRUM: J4.61
VDD_5V_GPS1: J3.63
VDD_5V_GPS2: J3.81
VDD_5V_I2C: J3.57
VDD_5V_PPM_SBUS: J4.53
VDD_5V_TEL1: J3.19

Notes on the sheet:
ETHERNET
30W for 12V
TEMP 3V3
12V and 5V power supply
IO_CH2 (PWM2)
Additional CAN2 connector
Additional HV connector
PORT 5
Motor Connectors
Motor 4 (BR)
FMU_CH4 (optional precharge off)
FC Connection
12V switch for payload DC motor
Motor 2 (BL)
FMU_CH4 (12V payload control)
BUZZER BUZZER
Used by 5G HAT
Temperature sensors for main PCB
Power Input (SSR, FUSE, PRECHARGE on seperate BC_PCB)
USB_D+ USB_D- VBUS
PORT 4
ETHERNET ETHERNET
FMU_CH2 (12V switch for payload DC motor)
Payload side_2
(Bypass)
IO_CH5 (SSR)
PORT 3
Connector_MF_2
N_IO_LED_SAFETY
CAN2 Termination
HM30_SBUS
VDD5V_BRICK1
FMU_CH1 (AUX 1 Payload)
USB Connector to FC
VDD5V_BRICK2
(FC_2)
Power
VDD_SERVO
RPI (CAN+SIYI camera over ethernet)
IO_CH4 (PWM4)
Gimbal UART Gimbal UART
360° Lidar
Mateksys GNSS M9N-G4-3100
SIYI RX 1 SIYI TX 1
(SSR)
VDD_5V_CAN2
Motor 3 (FL)
Signal connectors BC_PCB
Additional UART connector
PORT 6
ETHERNET
Connector_MF_1
Payload bottom GND +12V CAN2_L CAN2_H FMU_CH1 (AUX 1 Payload) 12VSW (SW 12V DC motor) ETH_RX+ ETH_RX- ETH_TX+ ETH_TX-
BUZZER-
H-RTK NEO-F9P DroneCAN Version
Additional HV- to bypass precharge resistor
IO_CH1 (PWM1)
Temp Temp
Additional connectors
Optional
Front Radar
Yellow_GND Grey_CANH Green_CANL Black_GND_PWM White_PWM
BUZZER
Additional IO connector
Temperature sensor 1
Gimbal control
5A Fused HV- HV+
PORT 2
Payload side_1
Spare
Additional CAN1 connector
Power supply to SIYI HM30 air unit
Safety Switch Connector
IO_SAFETY_SWITCH_IN
RPI ethernet connector
Radar altimeter connector +12V GND CAN1_L CAN1_H
CAN1_H CAN1_L
HV+ Input from BC_PCB
HM30_UART
HV- Input from BC_PCB
mLRS RX
CAN2_H CAN2_L
VDD_5V_CAN1
Temperature sensor 2
IO_CH3 (PWM3)
PORT 1
VDD_5V_TEL2
Motor 1 (FR)
IO_CH1 (PWM 1) IO_CH2 (PWM 2) IO_CH3 (PWM 3) IO_CH4 (PWM 4)
Additional IO connector Additional IO connector
Additional UART connector Additional UART connector
Gimbal UART
VDD_5V_TEL3
20W for 5V
Ethernet
SIYI A8 without HM30 unit
Temp BC_PCB Temp BC_PCB
Quiver PT3 Main PCB
mLRS RX mLRS TX
