Julius-eng/project-quiver-05032025/(commit log)

2025-03-06 Added project data files
    [Quiver_PDB_01-B_Cu.gbl, Quiver_PDB_01-B_Mask.gbs, Quiver_PDB_01-B_Paste.gbp, Quiver_PDB_01-B_Silkscreen.gbo, Quiver_PDB_01-Edge_Cuts.gm1, Quiver_PDB_01-F_Cu.gtl, Quiver_PDB_01-F_Mask.gts, Quiver_PDB_01-F_Paste.gtp]
2025-03-07 Add PT1 parameters file
    [parameters.param]
2025-03-10 Update Compass offsets, orientation
    [parameters.param]
2025-03-10 Remove board specific STAT parameters
    We don't need to track these here since they are unique to each individual flight controller
    [parameters.param]
2025-03-21 Create Quiver PDB V1 Assembly Manual.md
2025-03-21 Rename Quiver PDB V1 Assembly Manual.md to Quiver-PDB-V1-Assembly-Manual.md
2025-04-01 Add complete PT2 grant data. Move PT2 PDB grant.
    Add the complete data for the PT2 grant. Also move the PT2 PDB grant from PT2 folder to PT1 folder. The PDB will be used as an upgrade in PT1.
    [Quiver_PDB_01-B_Cu.gbl, Quiver_PDB_01-B_Mask.gbs, Quiver_PDB_01-B_Paste.gbp, Quiver_PDB_01-B_Silkscreen.gbo, Quiver_PDB_01-Edge_Cuts.gm1, Quiver_PDB_01-F_Cu.gtl, Quiver_PDB_01-F_Mask.gts, Quiver_PDB_01-F_Paste.gtp]
2025-04-07 Create 20hr-flight-plan
    General 20-Hour Flight Test Plan for Project Quiver Prototypes
    This document outlines a general 20-hour flight test plan for the evaluation of Project Quiver prototypes. While the time allocations for each phase are subject to change based on specific needs or progress observed during the testing process, this plan serves as a comprehensive overview of the steps required to ensure a successful and systematic evaluation of each prototype. Adjustments may be made throughout the program to optimize the testing workflow and address emerging priorities.
2025-04-18 PT2 electronics assembly guide
2025-04-18 Update 0001-electronics-assembly-manual.md
    spelling
2025-04-22 Information Note: Motor pairs performance difference
2025-04-24 Summary excel sheet
    [Flight Log Review.xlsx]
2025-05-12 Update PT3 PCB information-note.md
    added I2C note for temperature sensors
    - updated location for temperature sensors
    added pin configuration for attachment interface
2025-05-20 Create first draft of PT3 Battery PCB information-note.md
2025-05-24 Update 003-Ground_Target_Machine_Vision_System_(Comprehensive_Requirement).md
    24.05.25-3 Pork Noodle: Added M-6.
2025-05-28 Create information-note.md for attachment PCB
2025-05-28 fixed broken link in PT1-Engineering-Report.md
    fixed broken link for attachment interface
2025-06-04 Add project files for payload PCB
    Including:
    - documentation
    - KiCad project
    - Images
    - Gerbers and fabrication files
    [QuiverAttachPCB-B_Cu.gbr, QuiverAttachPCB-B_Mask.gbr, QuiverAttachPCB-B_Paste.gbr, QuiverAttachPCB-B_Silkscreen.gbr, QuiverAttachPCB-Edge_Cuts.gbr, QuiverAttachPCB-F_Cu.gbr, QuiverAttachPCB-F_Mask.gbr, QuiverAttachPCB-F_Paste.gbr]
2025-06-08 Update PCB, docs based on feedbacl
    - Update information note
    - Change pin headers
    - re-generate output files
    - update images for documentation
    [QuiverAttachPCB-B_Cu.gbr, QuiverAttachPCB-B_Mask.gbr, QuiverAttachPCB-B_Paste.gbr, QuiverAttachPCB-B_Silkscreen.gbr, QuiverAttachPCB-Edge_Cuts.gbr, QuiverAttachPCB-F_Cu.gbr, QuiverAttachPCB-F_Mask.gbr, QuiverAttachPCB-F_Paste.gbr]
2025-06-11 Create first draft of PCB manuals
    Main PCB
    FC PCB
    BC PCB
2025-06-11 Fix power limit in AB-1 and P-2
2025-06-11 Fix power limit at AB-1. Fix standard description in AB-4.
2025-06-11 Fix power limit in AB-1. Fix standard description in AB-3.
2025-06-11 Fix power limit at AB-1.
2025-06-11 Update 002-General_Aerial_LiDAR_Scanning_Device_comprehensive_requirement).md
    Fix power limit in AB-1. Fix standard description in AB-6.
2025-06-11 Fix power limit in AB-1.
2025-06-16 Create 0002-Airframe-CAD-Architecture
2025-06-16 Update and rename 0002-Airframe-CAD-Architecture to 0002-Airframe-CAD-Architecture.md
2025-06-16 Final draft for Battery PCB information note
2025-06-17 Create FC PCB directory
2025-06-17 Create FC PCB information_note
2025-06-17 add wire data PDF
2025-06-26 Create performance-metrics-flight-plan.md
    Flight plan and directives for quantitatively comparing any two prototypes of project Quiver.
2025-07-14 Updating color code for cables
2025-07-27 ADD filament datasheet sample image
2025-08-01 ADD testing specimen printing orientation image
2025-08-01 Center molex, adjust edges
    v 1.2
    - Centered molex header between mounting holes
    - Adjusted edge dimensions to 23.5mm x 15.8mm
    - Brought in corners to 2mm chamfered
    [QuiverAttachPCB-B_Cu.gbr, QuiverAttachPCB-B_Mask.gbr, QuiverAttachPCB-B_Paste.gbr, QuiverAttachPCB-B_Silkscreen.gbr, QuiverAttachPCB-Edge_Cuts.gbr, QuiverAttachPCB-F_Cu.gbr, QuiverAttachPCB-F_Mask.gbr, QuiverAttachPCB-F_Paste.gbr]
2025-08-02 ADD SLS materials
2025-08-02 UPDATE SLM materials
2025-08-13 Update Harnessing-Guide.md
    Added:
    - pre-crimped wires
    - connector instructions
    - note about cables from manufacturer
    - version control
2025-08-14 Fix: 1.2mm correct board thickness
2025-09-02 Update 003-Ground_Target_Machine_Vision_System_(Comprehensive_Requirement).md
    03.09.25-5 Deer Noodle: CHANGE M-1 for components source clarification.
2025-09-08 Object avoidance sensor selection information note
2025-09-12 ADD minor revisions description for RTK-GNSS mount
2025-10-01 Information Note for Main PCB Update
2025-10-01 Information Note for Front PCB Update
2025-10-02 upload CAD files
2025-10-02 additional folders
    [bom.csv, designators.csv, positions.csv]
2026-01-18 Refactor Engineering Reports for Docusaurus compatibility
    - Move PT1 and PT2 reports to Engineering-Reports root (remove subfolders)
    - Add Docusaurus frontmatter (title, sidebar_position, description)
    - Fix MDX compatibility issues:
    - Convert <br> to <br/>
    - Remove nested <details> tags
    - Fix spacing after </summary> for proper markdown rendering
    - Clean up PT1 header formatting
    - Simplify Mouser BOM table for better display
    - Add _category_.json for sidebar configuration
    Note: PT2 images need re-uploading (holocron.so links are broken)
2026-01-18 Reorganize assembly guides and update sidebar order
    - Rename assembly-guides/PT3/ to pt3-assembly-guides/ (flatten structure)
    - Add _category_.json for PT3 Assembly Guides sidebar config
    - Update sidebar positions: Assembly Guides (1), Engineering Reports (2)
    - Add frontmatter to structural-assembly.md for cleaner sidebar title
    [part1.step, part2.step, part3.step, part4.step, part5_6.step, part7_8.step]
2026-01-18 Refactor pcb assembly guides
2026-01-24 Move flight-test to repo root and fix CI checks
    - Move flight-test folder from docs/ to repository root
    - Add README explaining it's an archive of early flight tests
    - Add .editorconfig-checker.json to exclude binary/generated files
    - Update .cspell.config.yaml to exclude KiCAD and binary files
    - Add project-specific words to spell checker dictionary
    - Fix formatting issues in JSON files and markdown
    [parameters.param]
2026-01-25 Revise PT3 Engineering Report with updates and links
    Updated battery slider and PCB integration details, added links to KiCAD files, and revised sections for clarity. Removed outdated images and placeholders for future updates.
2026-01-25 Update PT3 assembly guides link in report
2026-01-25 Move PT3 report to match PT1/PT2 structure and fix typos
    - Move PT3-Engineering-Report.md to docs/Engineering-Reports/
    - Update image paths from images/ to PT3/images/
    - Fix typos: "heat sync" -> "heat sink", "Pix 32 V6" -> "Pix32 V6"
    - Fix grammar: "a various form factors that integrates"
    - Remove double spaces and extra blank lines
    - Add missing period
